audisio-ing/UNLZ-Proyecto_Final-Estacion_de_Escaneo_3D_para_Analisis_de_Desviaciones_Dimensionales/Propuesta Final.pdf

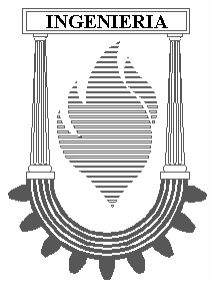
[picture p18: figure]

### Universidad Nacional de Lomas de Zamora

### Facultad de Ingeniería

### PROYECTO EN INGENIERÍA MECATRÓNICA

DOCENTES
- Blanca, Ezequiel.
- Lukaszewicz, Cristian Leandro.
- Szombach, Juan Ignacio.

### PROPUESTA FINAL

## CONTROL DE CALIDAD POR COMPARACIÓN CON NUBE DE PUNTOS

INTEGRANTES
Audisio, Juan Pablo - 43.671.648 Garrahan, Alan - 43.896.825 Reyna, Valentín Julián - 43.798.677

FECHA DE PRESENTACIÓN: 1 de Septiembre de 2025

MOTIVACIÓN
Buscamos desarrollar una solución innovadora para el control de calidad, un nuevo enfoque que permita un control detallado pieza por pieza asegurándose de que el producto final cumpla con los estándares requeridos. Garantizar la precisión, consistencia y velocidad en la detección de defectos y variaciones en las piezas.
Orientado a métodos de producción asociados a la matricería, para verificar si el producto generado por la matriz cumple los estándares de calidad. Por ejemplo para matrices de inyección de plástico, se puede verificar si la matriz se sigue llenando por completo, si se extrae bien la rebaba, y si el desgaste de la misma no es significante.

DESCRIPCIÓN DE LA PROPUESTA
Línea de control equipada con una cámara y un láser de línea funcionando como scanner 3D a través del principio de triangulación láser con el fin de detección de fallas en piezas producidas por matrices destinadas a producciones en serie..

Las piezas entrarán al sistema a través de una cinta transportadora, serán posicionadas dentro de la estación de escaneo 3D y posteriormente obtendremos una nube de puntos relacionada con las dimensiones del objeto. Se ejecutará un código que permitirá visualizar la nube de puntos obtenidas y compararla con el modelo CAD patrón de las piezas existentes para determinar si la misma presenta fallas o deformaciones que puedan afectar a su funcionamiento. Esto nos permite conocer el estado de la matriz y sus posibles deformaciones, para determinar si es apta o no para ser instalada en una línea de producción.

ALCANCE
Al fin de la cursada se presentará un prototipo funcional del sistema que cumpla de forma eficaz la tarea propuesta, no podemos asegurar un funcionamiento eficiente ya que el mismo dependerá de los componentes que seamos capaces de obtener.

Se presentará un prototipo que cuente con una cinta de transporte funcional capaz de transportar las piezas hasta la estación de escaneo 3D retroalimentada con sensores de posición.

El sistema contará con tres variantes de piezas funcionales con cualidades únicas para comprobar el funcionamiento del sistema.

La estación de escaneo 3D será capaz de escanear una órbita 360° alrededor de la pieza y devolviendo una nube de puntos de la misma que luego será utilizada para su comparación con la pieza patrón. El porcentaje de similitud con la misma determinará si la matriz fabricada es apta para la implementación en línea de producción

DOCENTES
- Alejandro Simoncelli (Procesamiento de Señales): Adquisición, gestión y visualización de datos, escaneo por triangulación láser, construcción de representaciones visuales satisfactorias.
- Diego Lopez (Instrumentación Industrial): Tolerancia de los sensores, selección de motores, selección sensores con frecuencia de muestreo apropiada, selección de microprocesador apropiado.
- Luis Lengo o José Luis Pelizzoni (Automatización Industrial): Conveyor belt, sensor de presencia y guardado, línea de producción.

ESPECIFICACIÓN DE REQUERIMIENTOS
El sistema será capaz de mover una pieza por una línea de producción y ubicarla precisamente sobre la plataforma de escaneo mediante una secuencia y retroalimentada por sensores de posición. Luego escaneará la pieza y devolverá una nube de puntos, la cual posteriormente permitirá identificar al sistema el tipo de pieza y reconocer errores para verificar si cumple con los estándares requeridos.

DISEÑO FUNCIONAL
El siguiente diagrama de bloques muestra el diseño funcional del sistema a gran escala, los pasos a seguir y el resultado esperado de cada uno

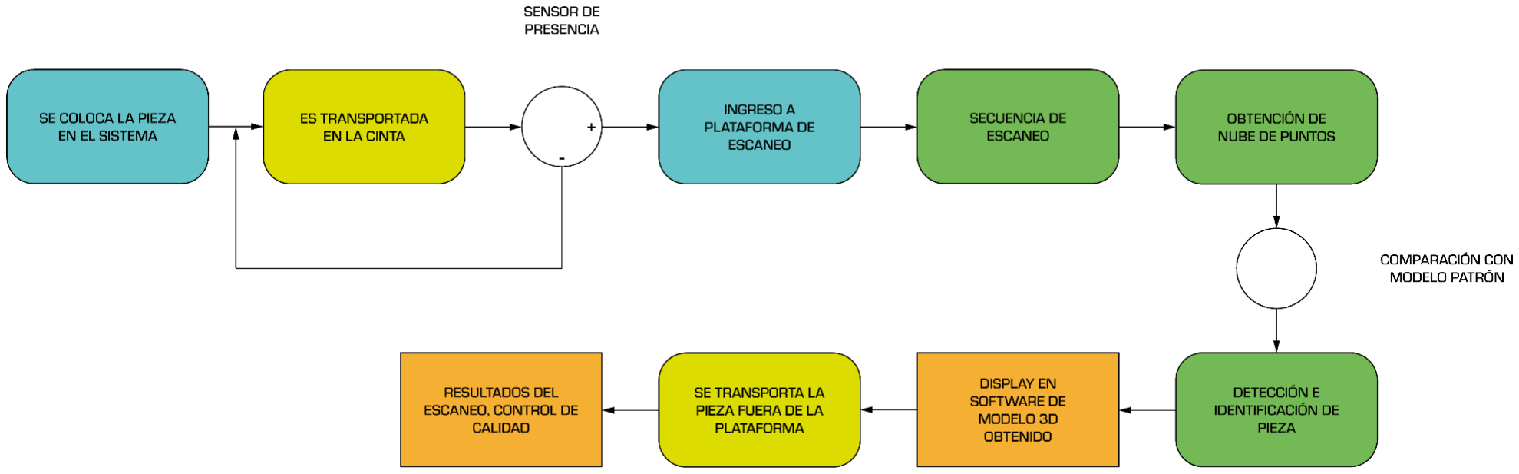
[picture p19: figure]

CONEXIONES DEL MICROCONTROLADOR
El siguiente diagrama muestra el conexionado del microcontrolador seleccionado para el proyecto (Arduino Uno)

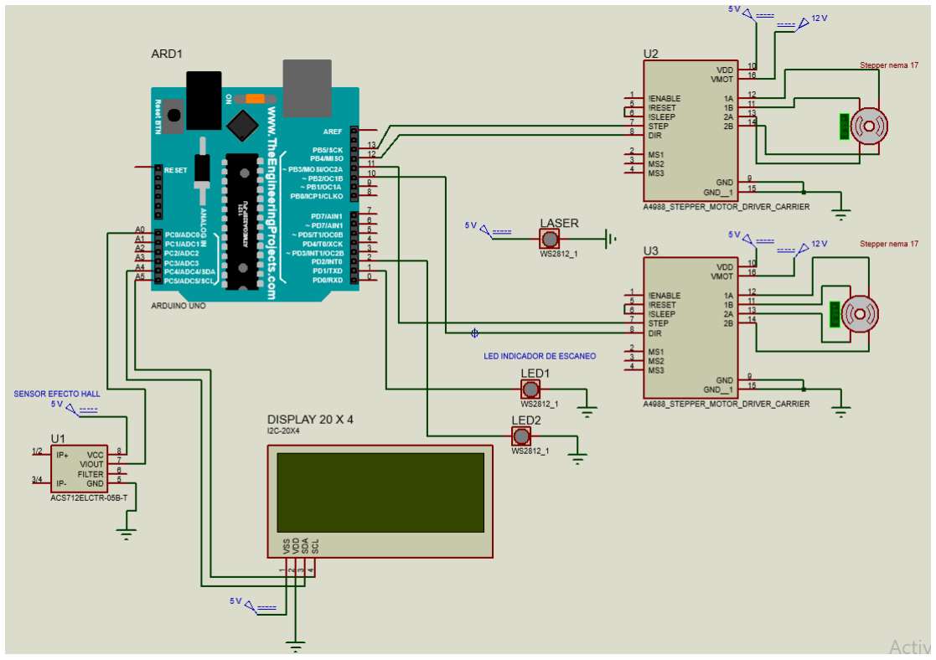
[picture p20: figure]

COSTO DEL PROTOTIPO, PRESUPUESTOS, PLAZOS DE ENTREGA DE MATERIALES
A continuación se incluye el BOM (Bill of Materials) que detalla los materiales necesarios para la realización del proyecto, junto con sus respectivos valores, tiempos de entrega y proveedores tanto en pesos y dólares, presentando alternativas de cada uno.

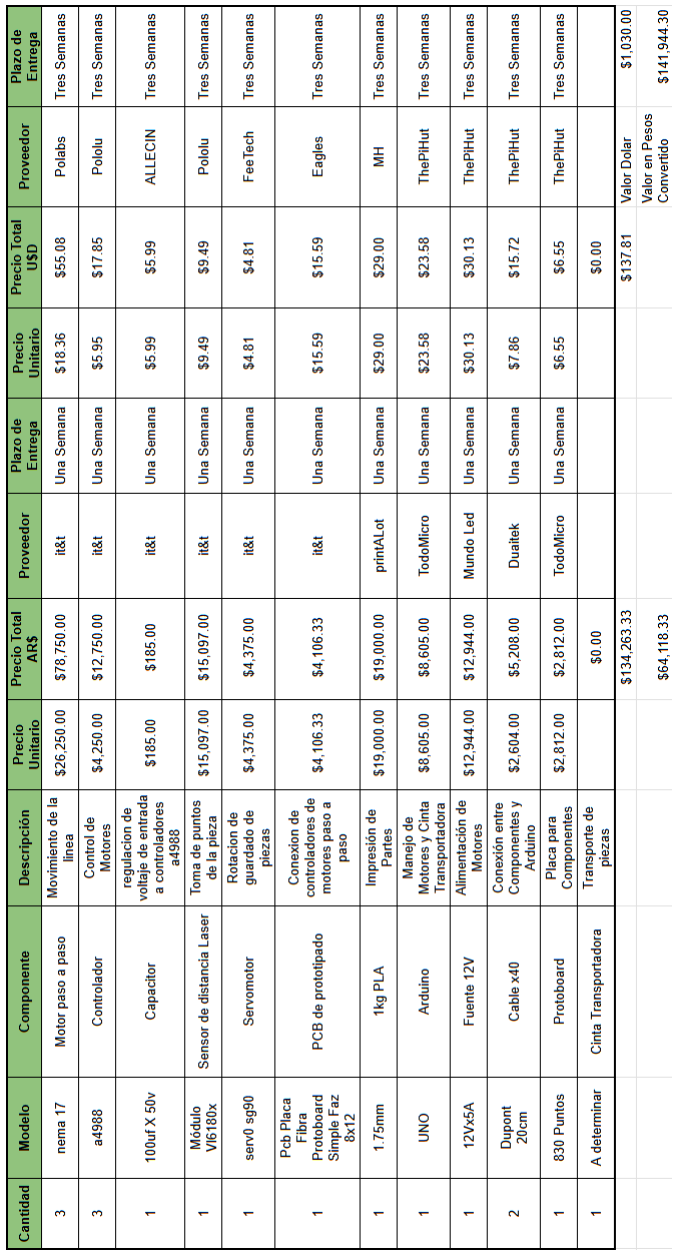
[picture p21: figure]
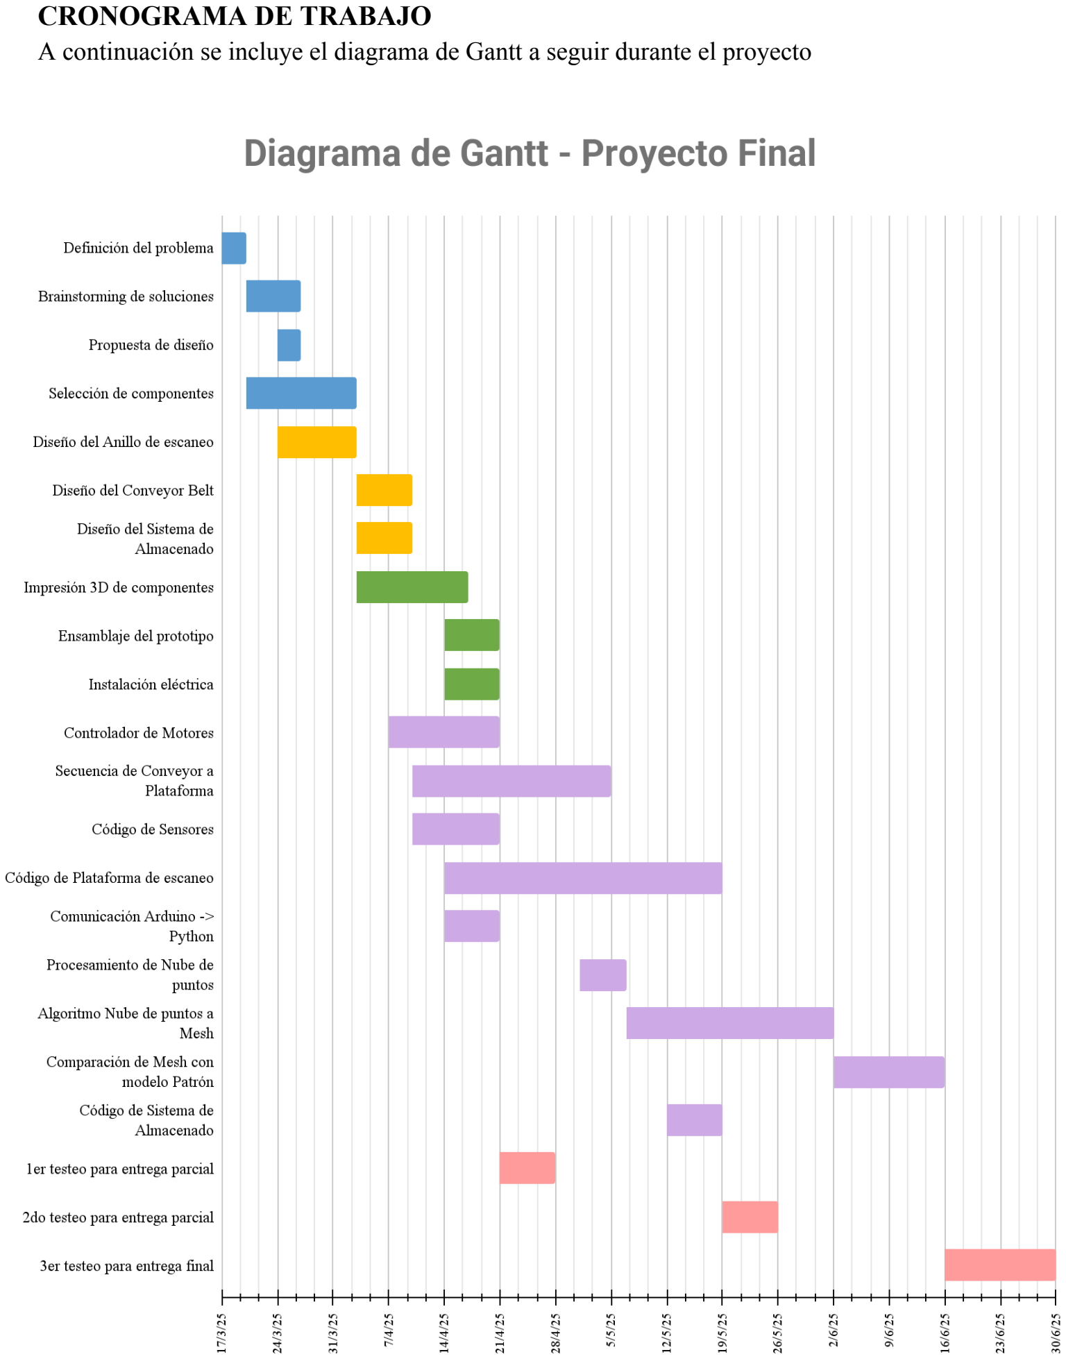
[picture p22: page 6]

CRONOGRAMA DE TRABAJO
A continuación se incluye el diagrama de Gantt a seguir durante el proyecto
