audisio-ing/UNLZ-Proyecto_Final-Estacion_de_Escaneo_3D_para_Analisis_de_Desviaciones_Dimensionales/Informes/DIAGRAMA DE GANTT.pdf

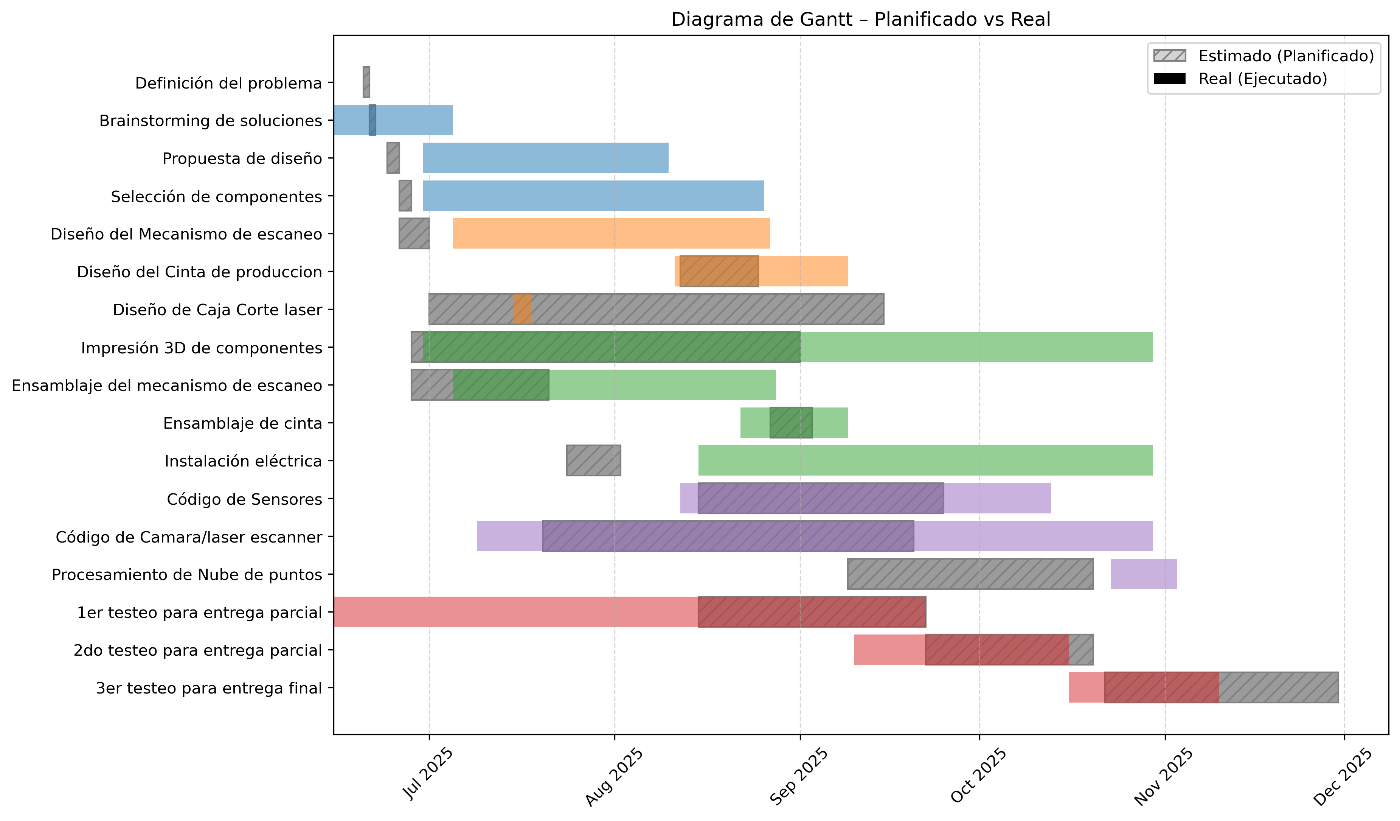
[picture p23: page 1]
