audisio-ing/UNLZ-Proyecto_Final-Estacion_de_Escaneo_3D_para_Analisis_de_Desviaciones_Dimensionales/Planos/Explosion/Explosion mecanismo v7.pdf

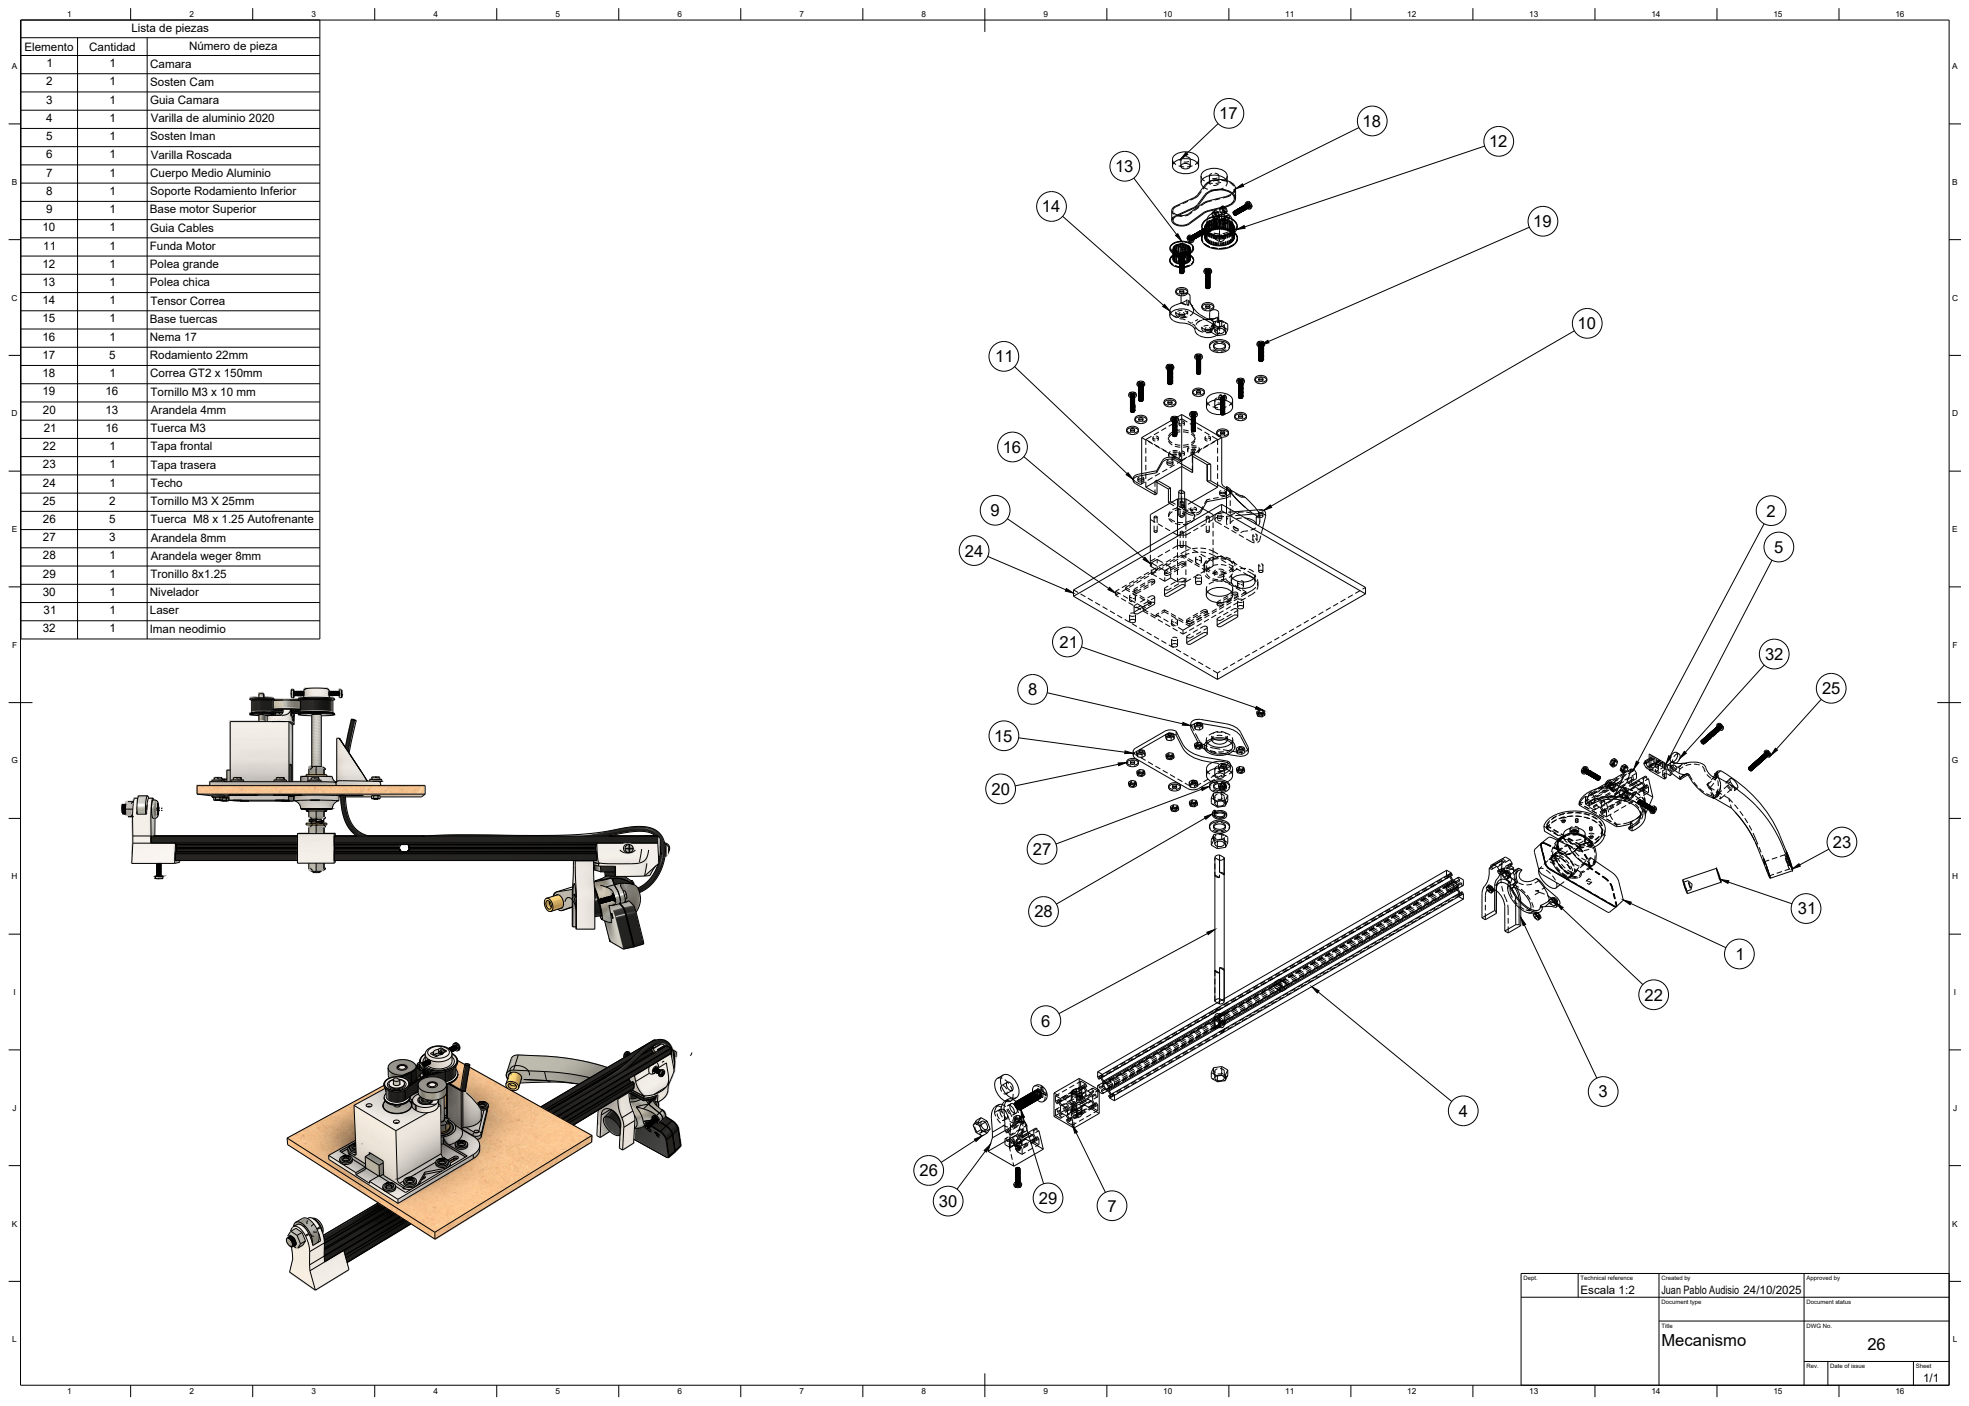
[picture p24: page 1]
Dept.; Technical reference; Created by; Approved by; Document type; Document status; Title; DWG No.; Rev.; Date of issue; Sheet; Escala 1:2; Juan Pablo Audisio; Elemento; Cantidad; Número de pieza 1; Camara 2; Sosten Cam 3; Guia Camara 4; Varilla de aluminio 2020 5; Sosten Iman 6; Varilla Roscada 7; Cuerpo Medio Aluminio 8; Soporte Rodamiento Inferior 9; Base motor Superior; Guia Cables; Funda Motor; Polea grande; Polea chica; Tensor Correa; Base tuercas; Nema 17; Rodamiento 22mm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

Lista de piezas
