audisio-ing/UNLZ-Proyecto_Final-Estacion_de_Escaneo_3D_para_Analisis_de_Desviaciones_Dimensionales/Planos/Explosion/Plano caja v8.pdf

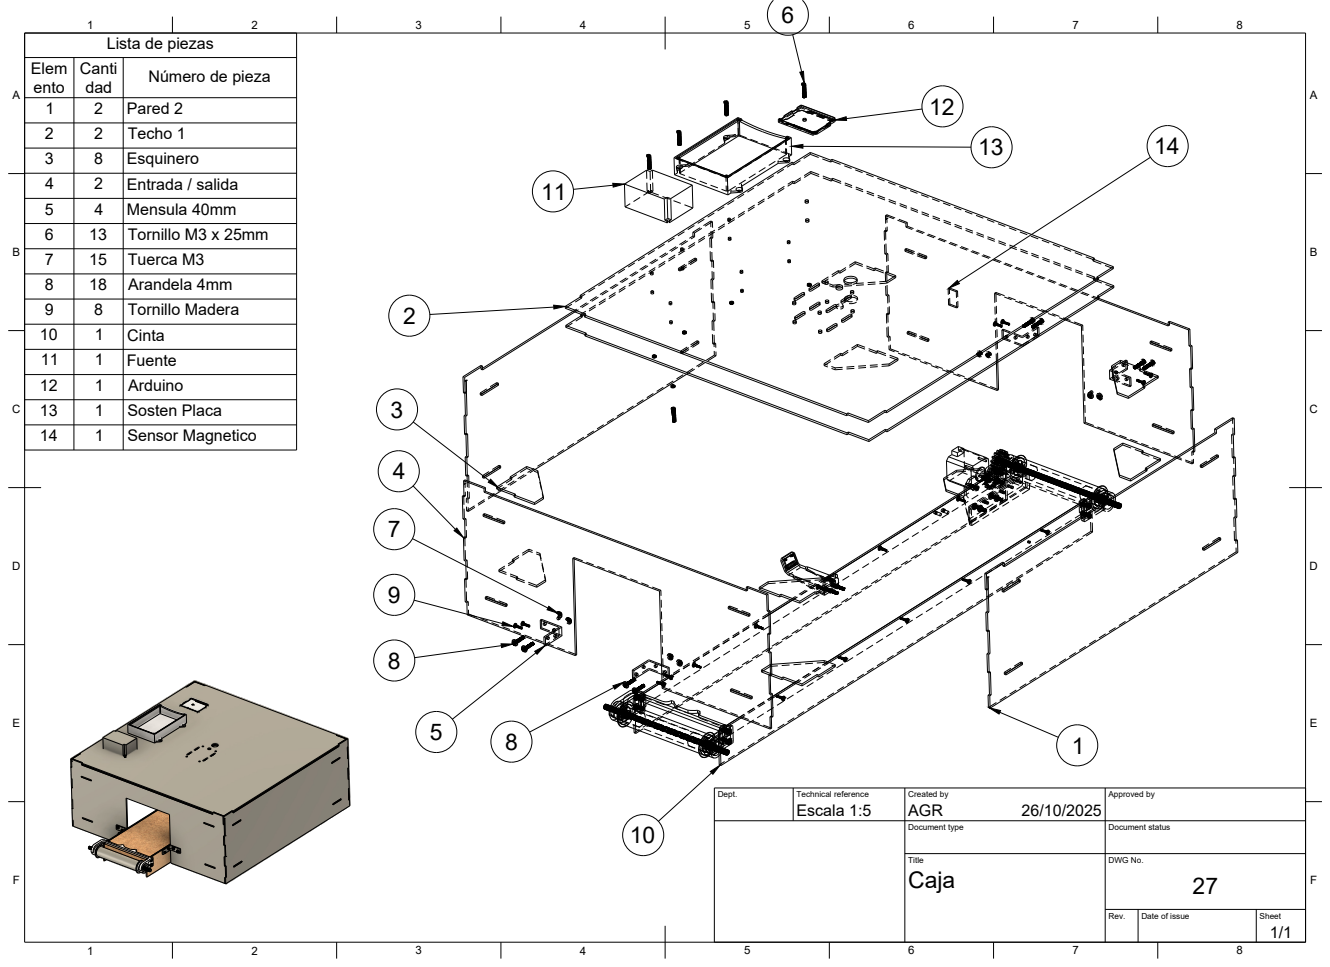
[picture p25: page 1]
Dept.; Technical reference; Created by; Approved by; Document type; Document status; Title; DWG No.; Rev.; Date of issue; Sheet; Escala 1:5; AGR; Lista de piezas; dad; Número de pieza; Pared 2; Techo 1; Entrada / salida; Mensula 40mm; Tornillo M3 x 25mm; Tuerca M3; Arandela 4mm; Tornillo Madera; Sosten Placa; Sensor Magnetico
