audisio-ing/UNLZ-Proyecto_Final-Estacion_de_Escaneo_3D_para_Analisis_de_Desviaciones_Dimensionales/Planos/Explosion/Plano cinta explosion v10.pdf

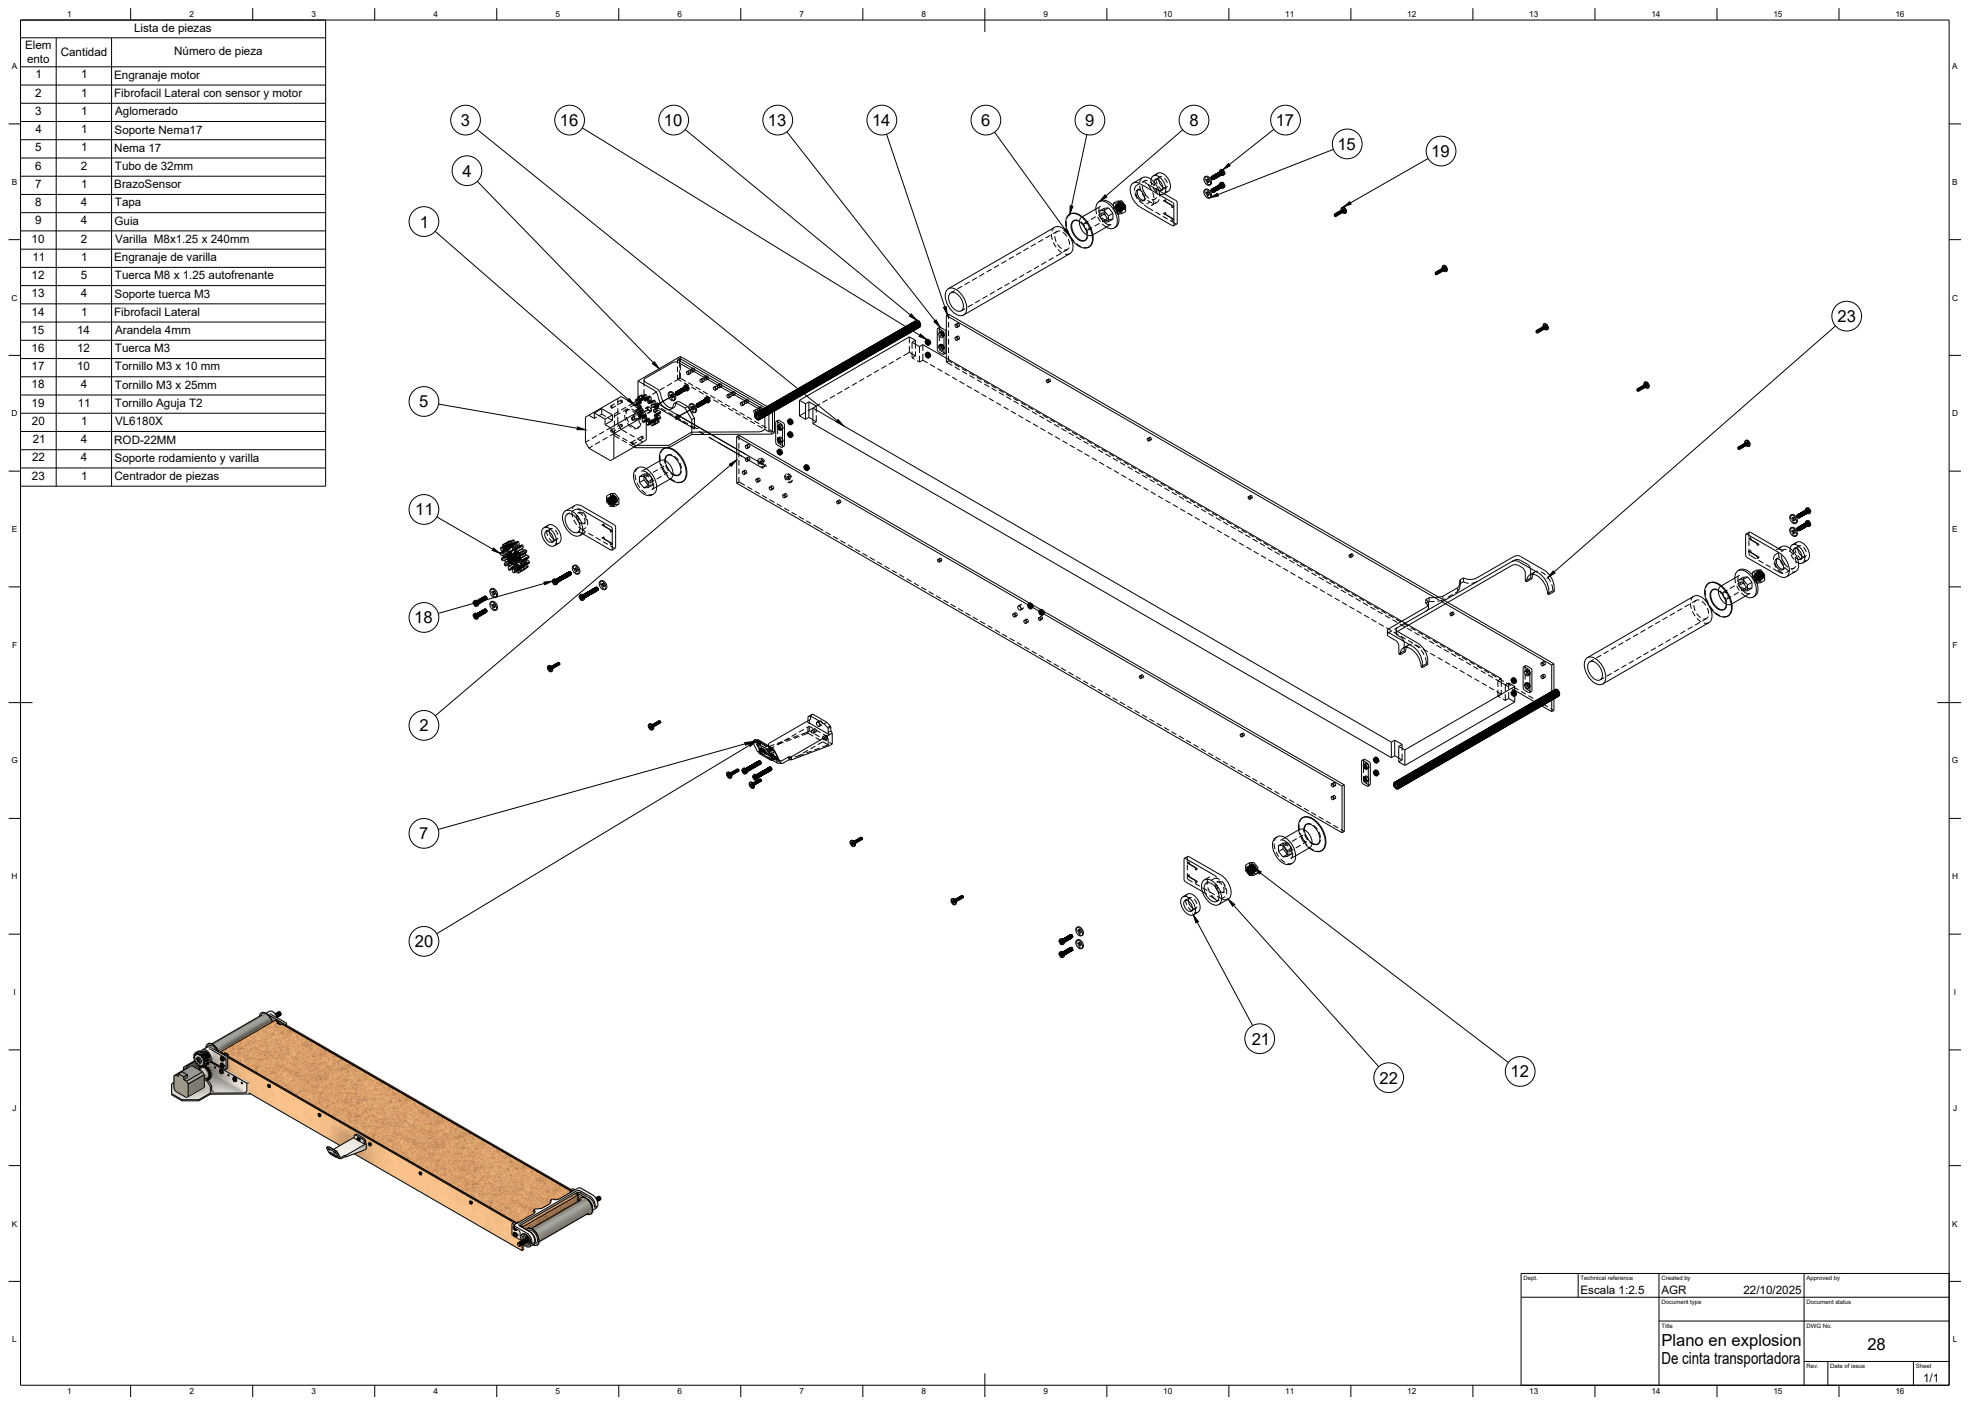
[picture p26: page 1]
Dept.; Technical reference; Created by; Approved by; Document type; Document status; Title; DWG No.; Rev.; Date of issue; Sheet; Plano en explosion; Escala 1:2.5; AGR; ento Cantidad; Número de pieza; Engranaje motor; Fibrofacil Lateral con sensor y motor; Soporte Nema17; Nema 17; Tubo de 32mm; Varilla M8x1.25 x 240mm; Engranaje de varilla; Tuerca M8 x 1.25 autofrenante; Soporte tuerca M3; Fibrofacil Lateral; Arandela 4mm; Tuerca M3; Tornillo M3 x 10 mm; Tornillo M3 x 25mm; Tornillo Aguja T2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

Lista de piezas

De cinta transportadora
