audisio-ing/UNLZ-Proyecto_Final-Estacion_de_Escaneo_3D_para_Analisis_de_Desviaciones_Dimensionales/Planos/Cinta/Plano MDF lados cinta v3.pdf

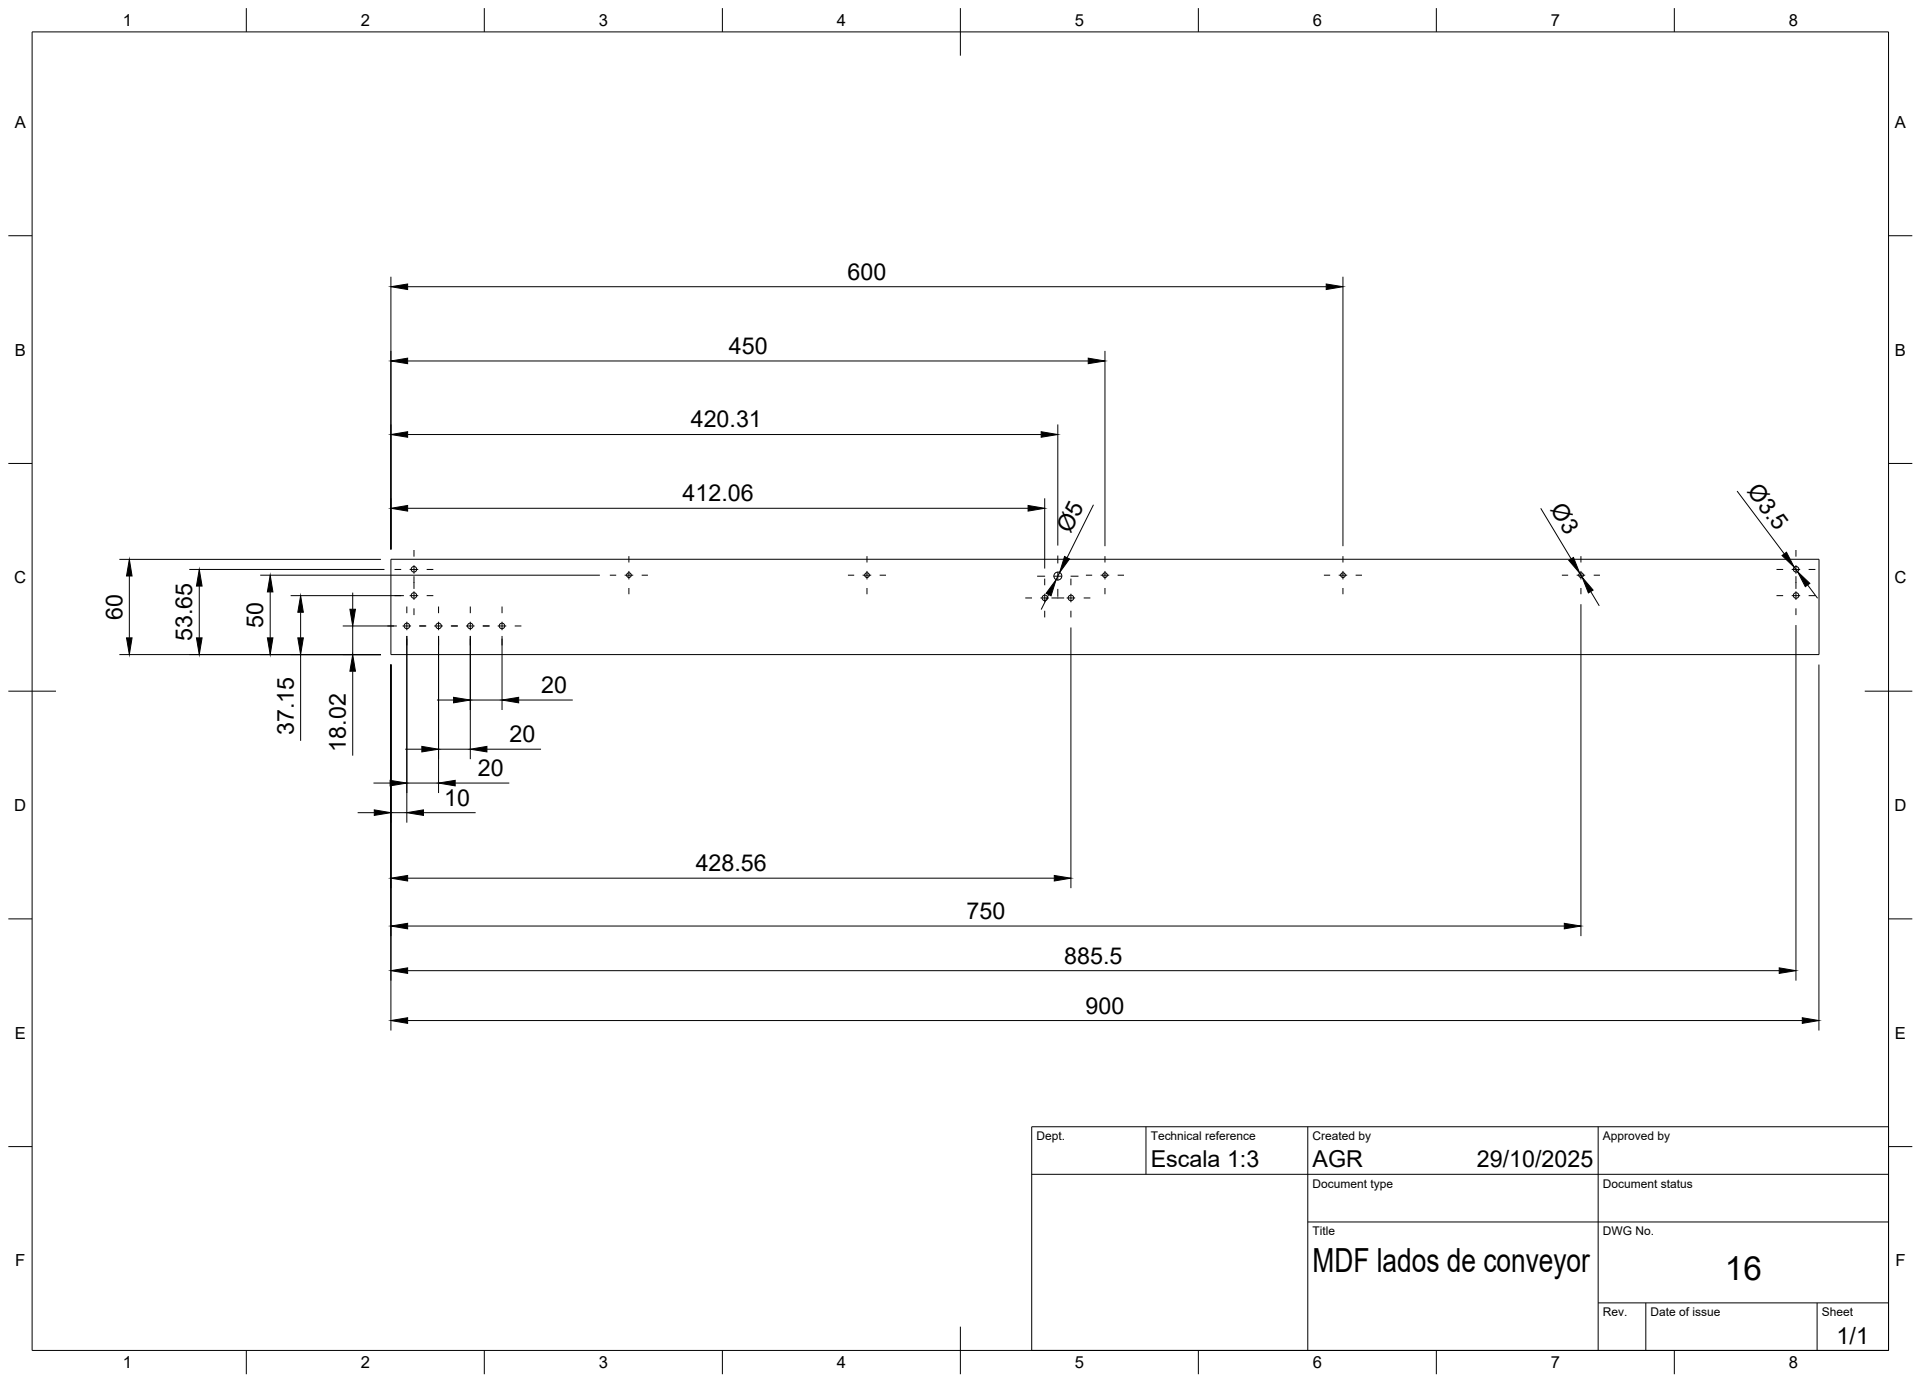
[picture p27: page 1]

Dept. | Technical reference Escala 1:3 | Created by AGR 29/10/2025 | Approved by

Document type | Document status

Title MDF lados de conveyor | DWG No. 16

Rev. | Date of issue | Sheet 1/1
