audisio-ing/UNLZ-Proyecto_Final-Estacion_de_Escaneo_3D_para_Analisis_de_Desviaciones_Dimensionales/Planos/Cinta/Plano soporte sensor VL6180x v2.pdf

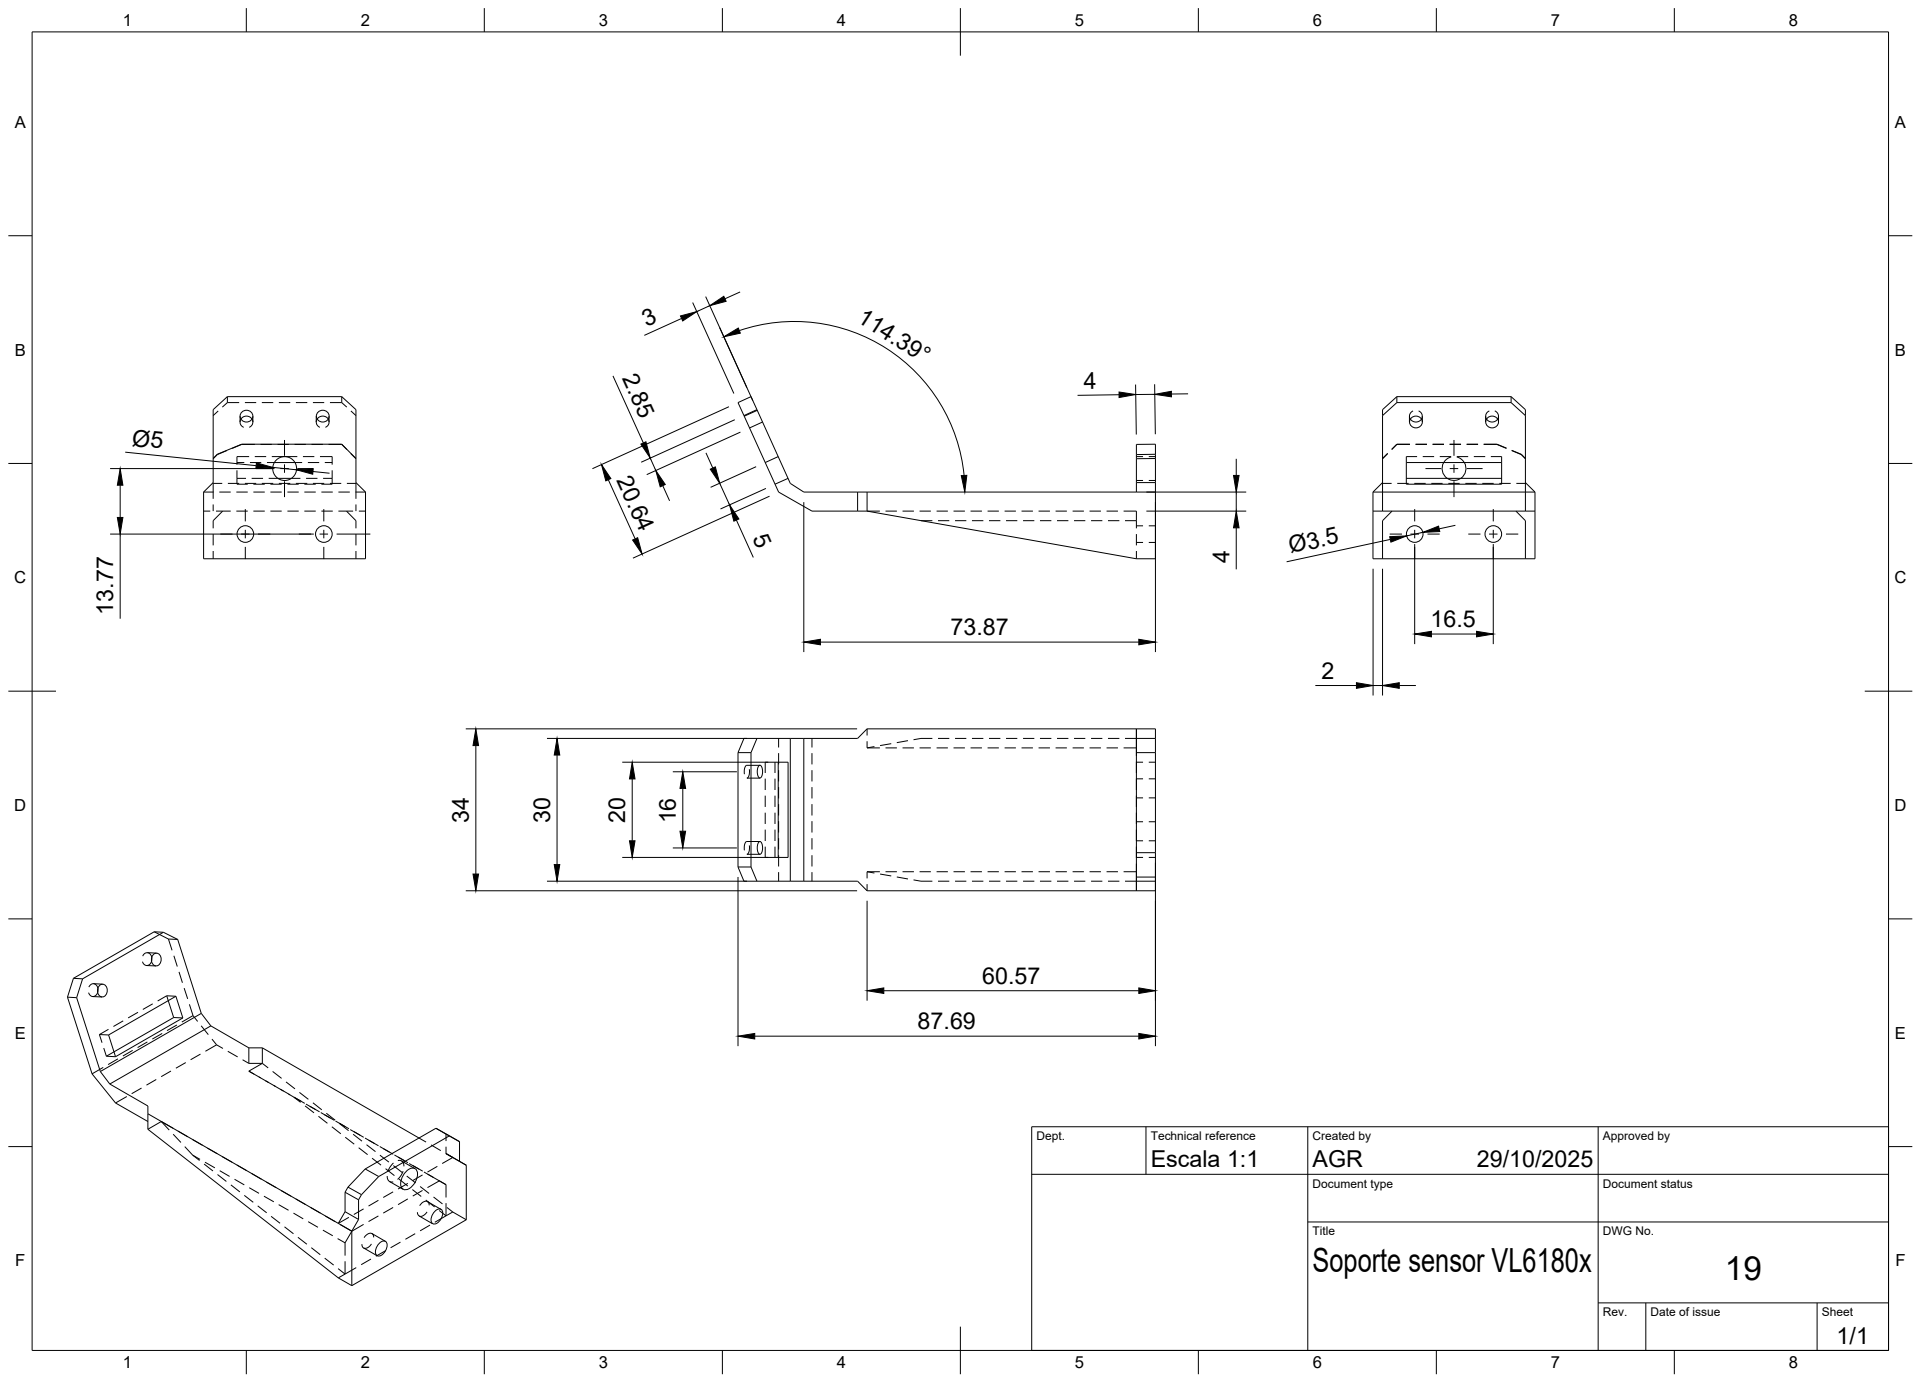
[picture p28: page 1]
Escala 1:1; AGR 16

Dept. | Technical reference | Created by 29/10/2025 | Approved by

Document type | Document status

Title Soporte sensor VL6180x | DWG No. 19

Rev. | Date of issue | Sheet 1/1
