audisio-ing/UNLZ-Proyecto_Final-Estacion_de_Escaneo_3D_para_Analisis_de_Desviaciones_Dimensionales/Planos/Mecanismo Giratorio/Funda motor v2.pdf

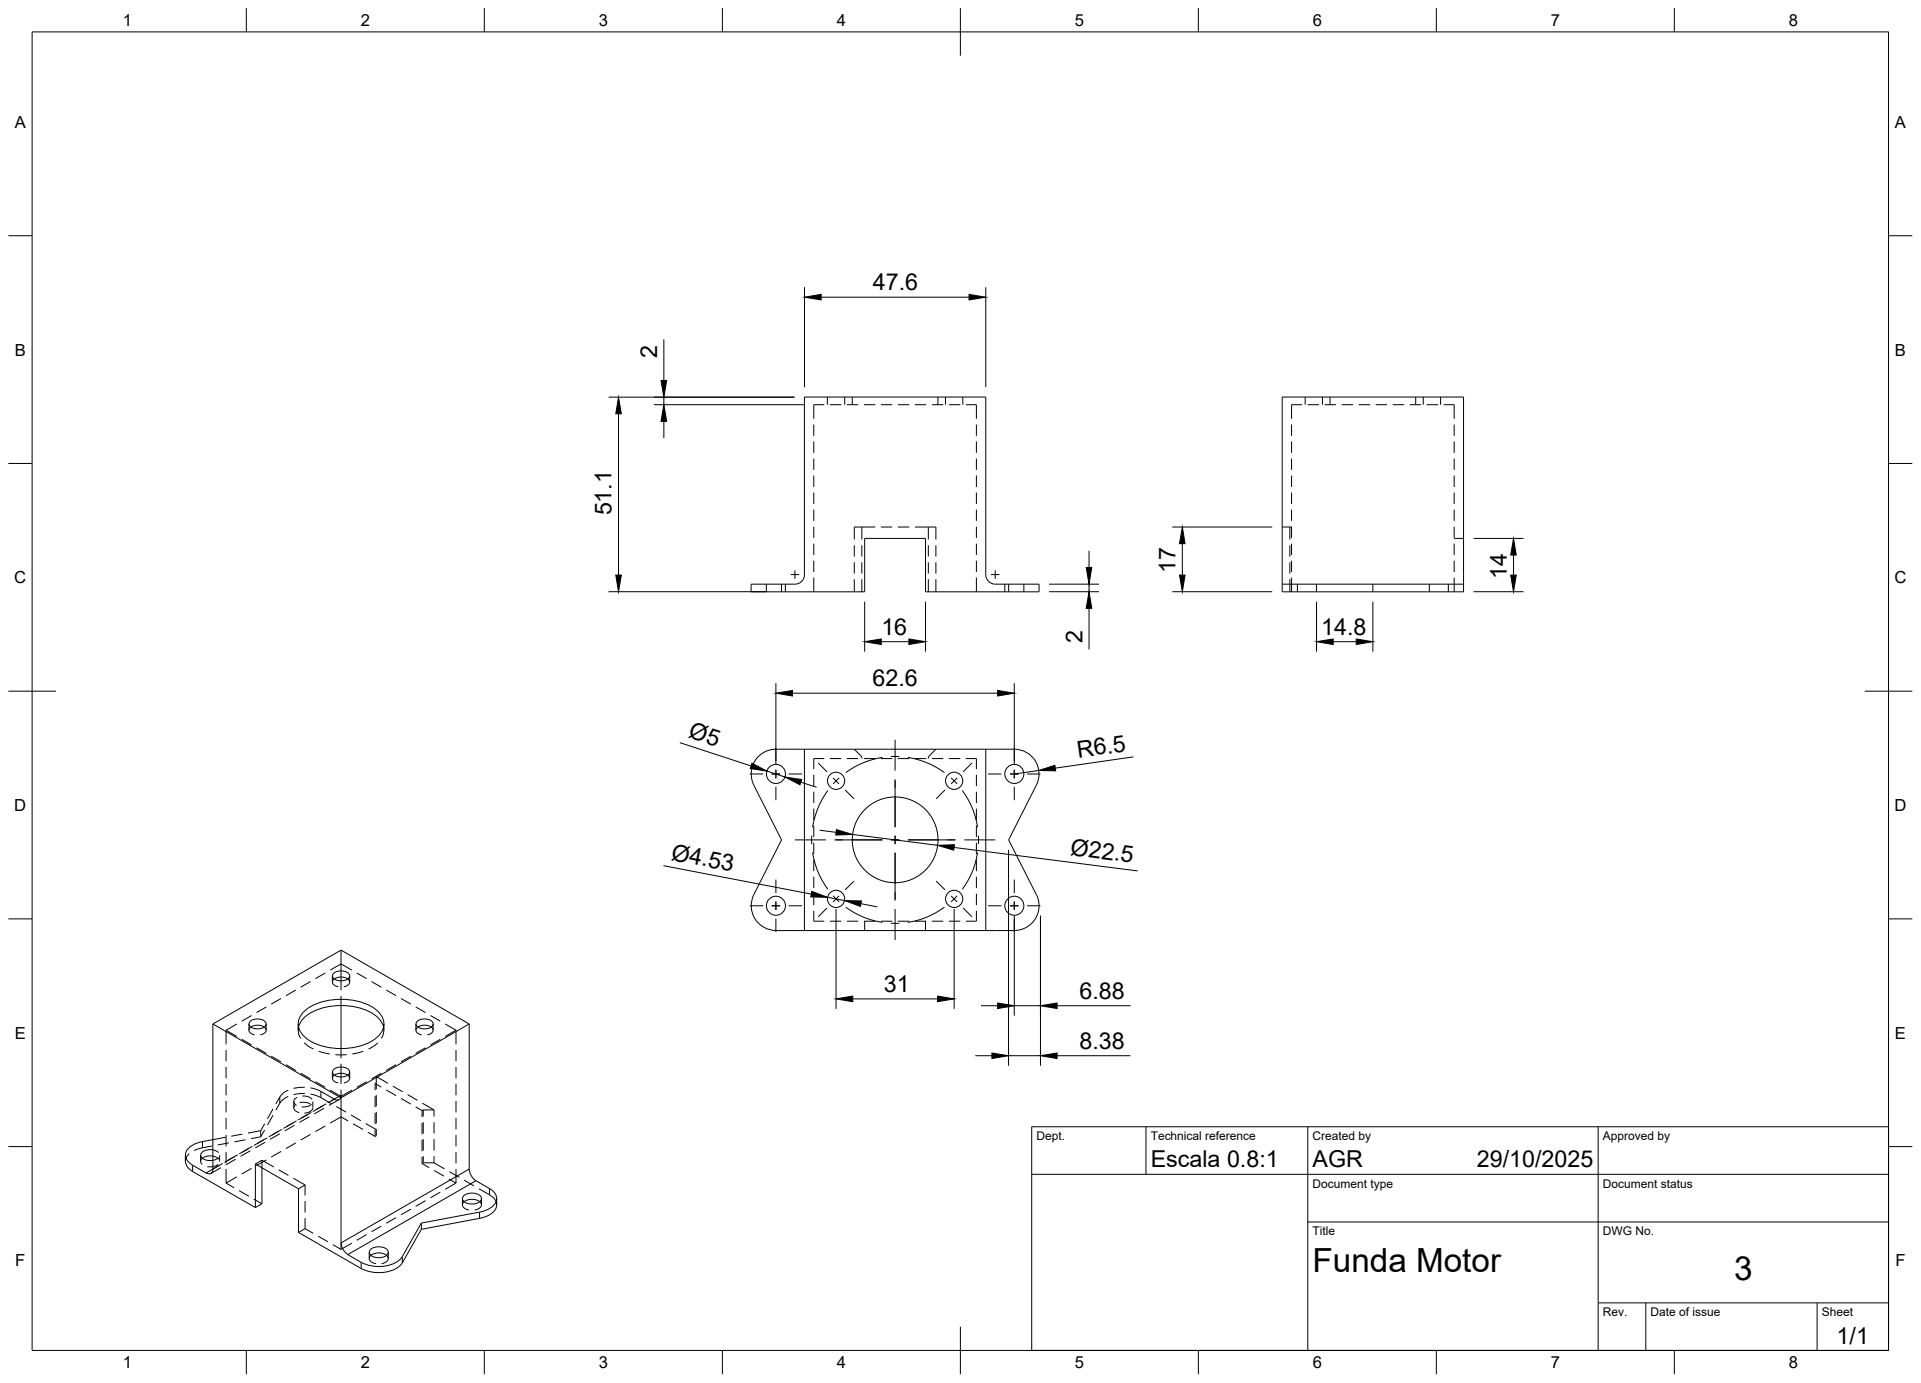
[picture p29: page 1]
Escala 0.8:1; AGR 51.1

Dept. | Technical reference | Created by 29/10/2025 | Approved by

Document type | Document status

Title Funda Motor | DWG No. 3

Rev. | Date of issue | Sheet 1/1
