audisio-ing/UNLZ-Proyecto_Final-Estacion_de_Escaneo_3D_para_Analisis_de_Desviaciones_Dimensionales/Planos/Mecanismo Giratorio/Plano base deslizante motor v3.pdf

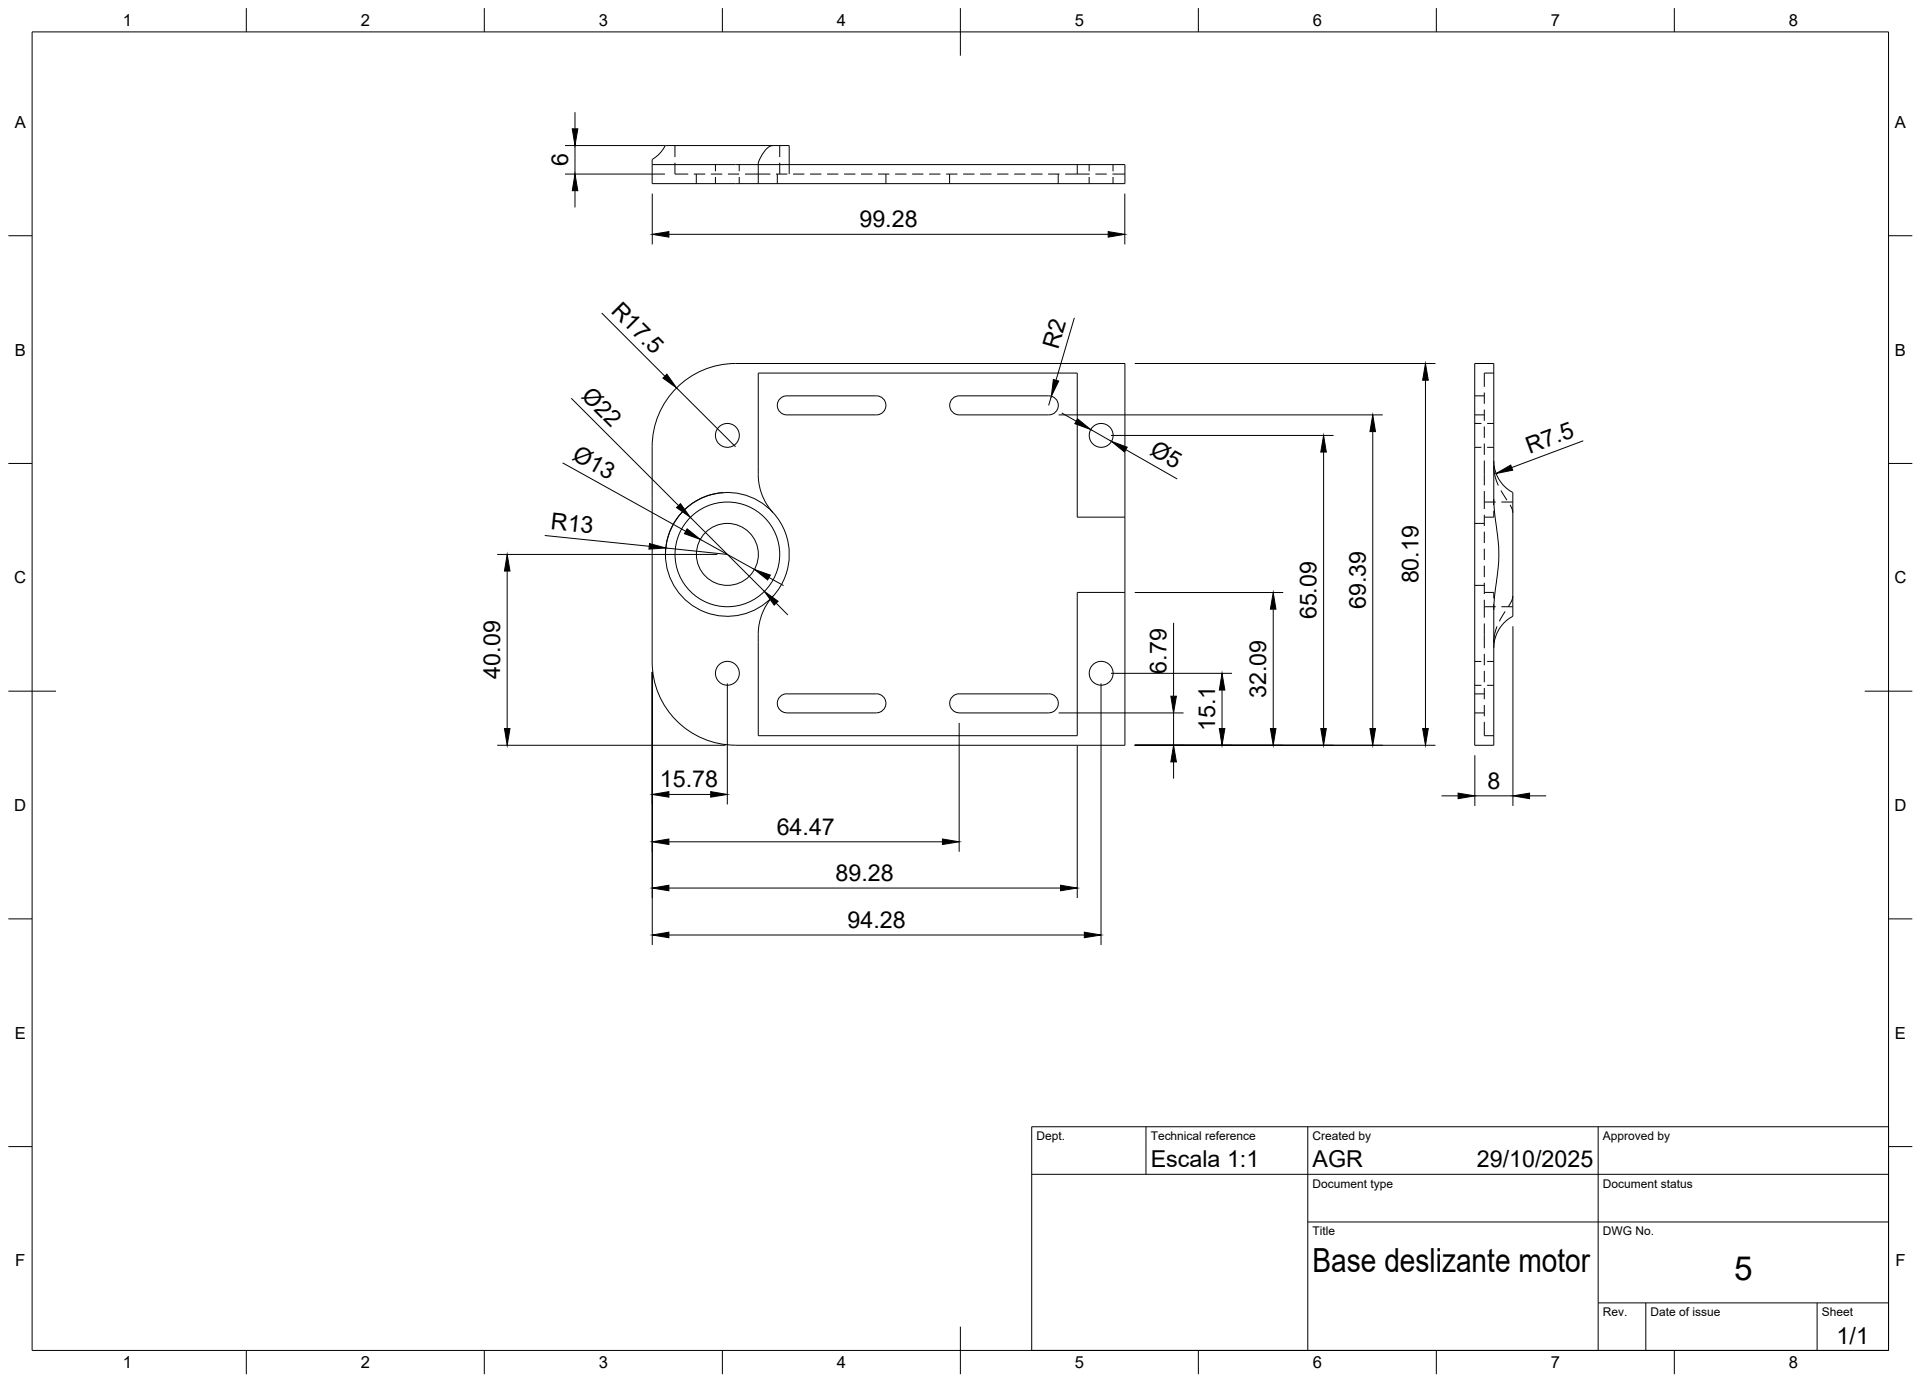
[picture p30: page 1]
Escala 1:1; AGR

Dept. | Technical reference | Created by 29/10/2025 | Approved by

Document type | Document status

Title Base deslizante motor | DWG No. 5

Rev. | Date of issue | Sheet 1/1
