audisio-ing/UNLZ-Proyecto_Final-Estacion_de_Escaneo_3D_para_Analisis_de_Desviaciones_Dimensionales/Planos/Mecanismo Giratorio/Plano guia cable v3.pdf

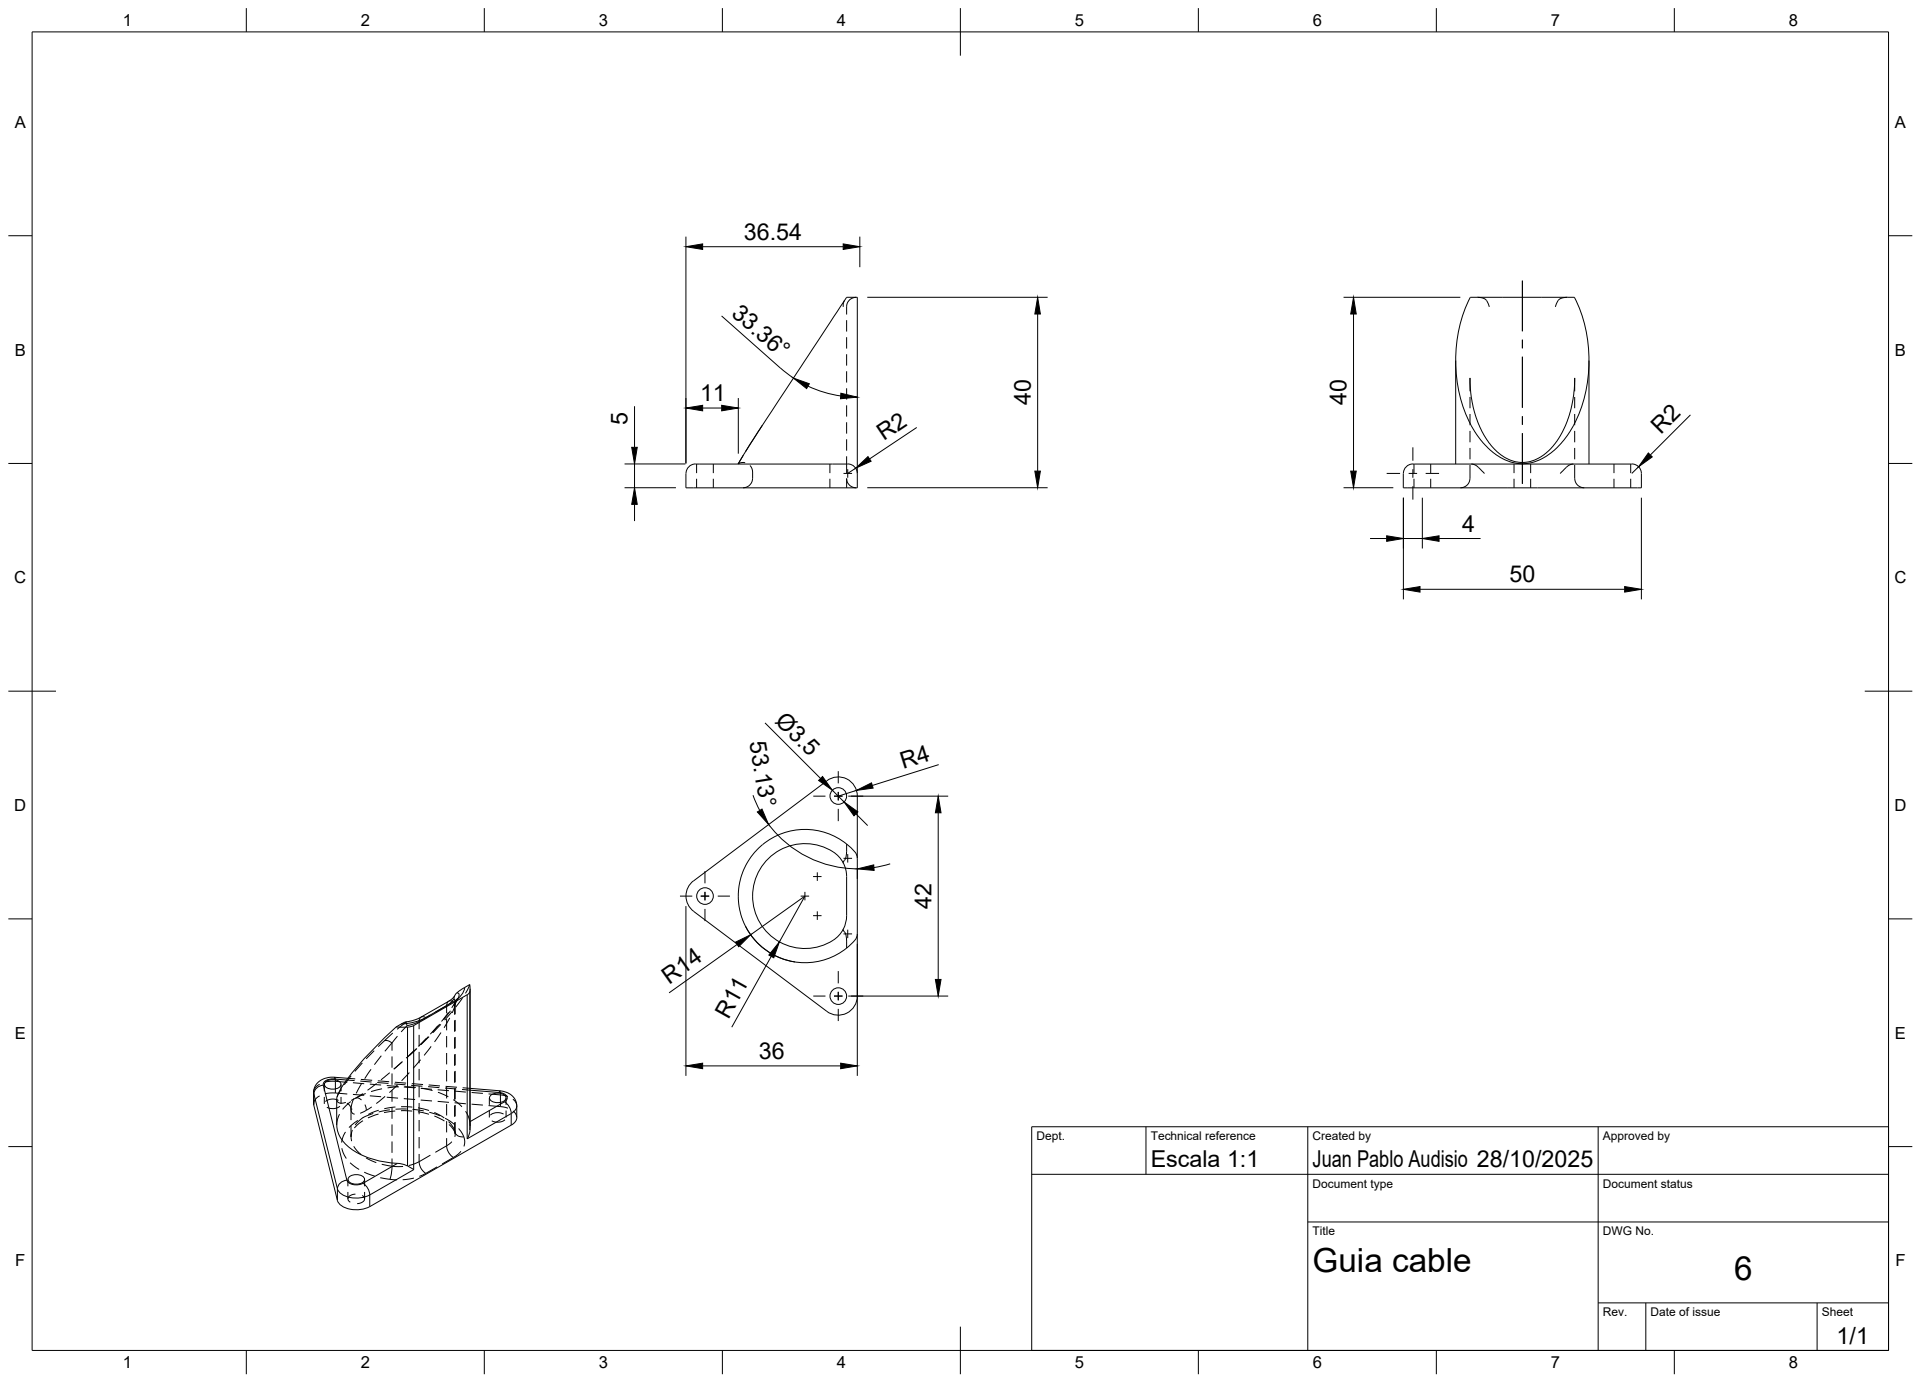
[picture p31: page 1]

Dept. | Technical reference Escala 1:1 | Created by Juan Pablo Audisio 28/10/2025 | Approved by

Document type | Document status

Title Guia cable | DWG No. 6

Rev. | Date of issue | Sheet 1/1
