audisio-ing/UNLZ-Proyecto_Final-Estacion_de_Escaneo_3D_para_Analisis_de_Desviaciones_Dimensionales/Planos/Mecanismo Giratorio/Soporte Iman y pasa cables v4.pdf

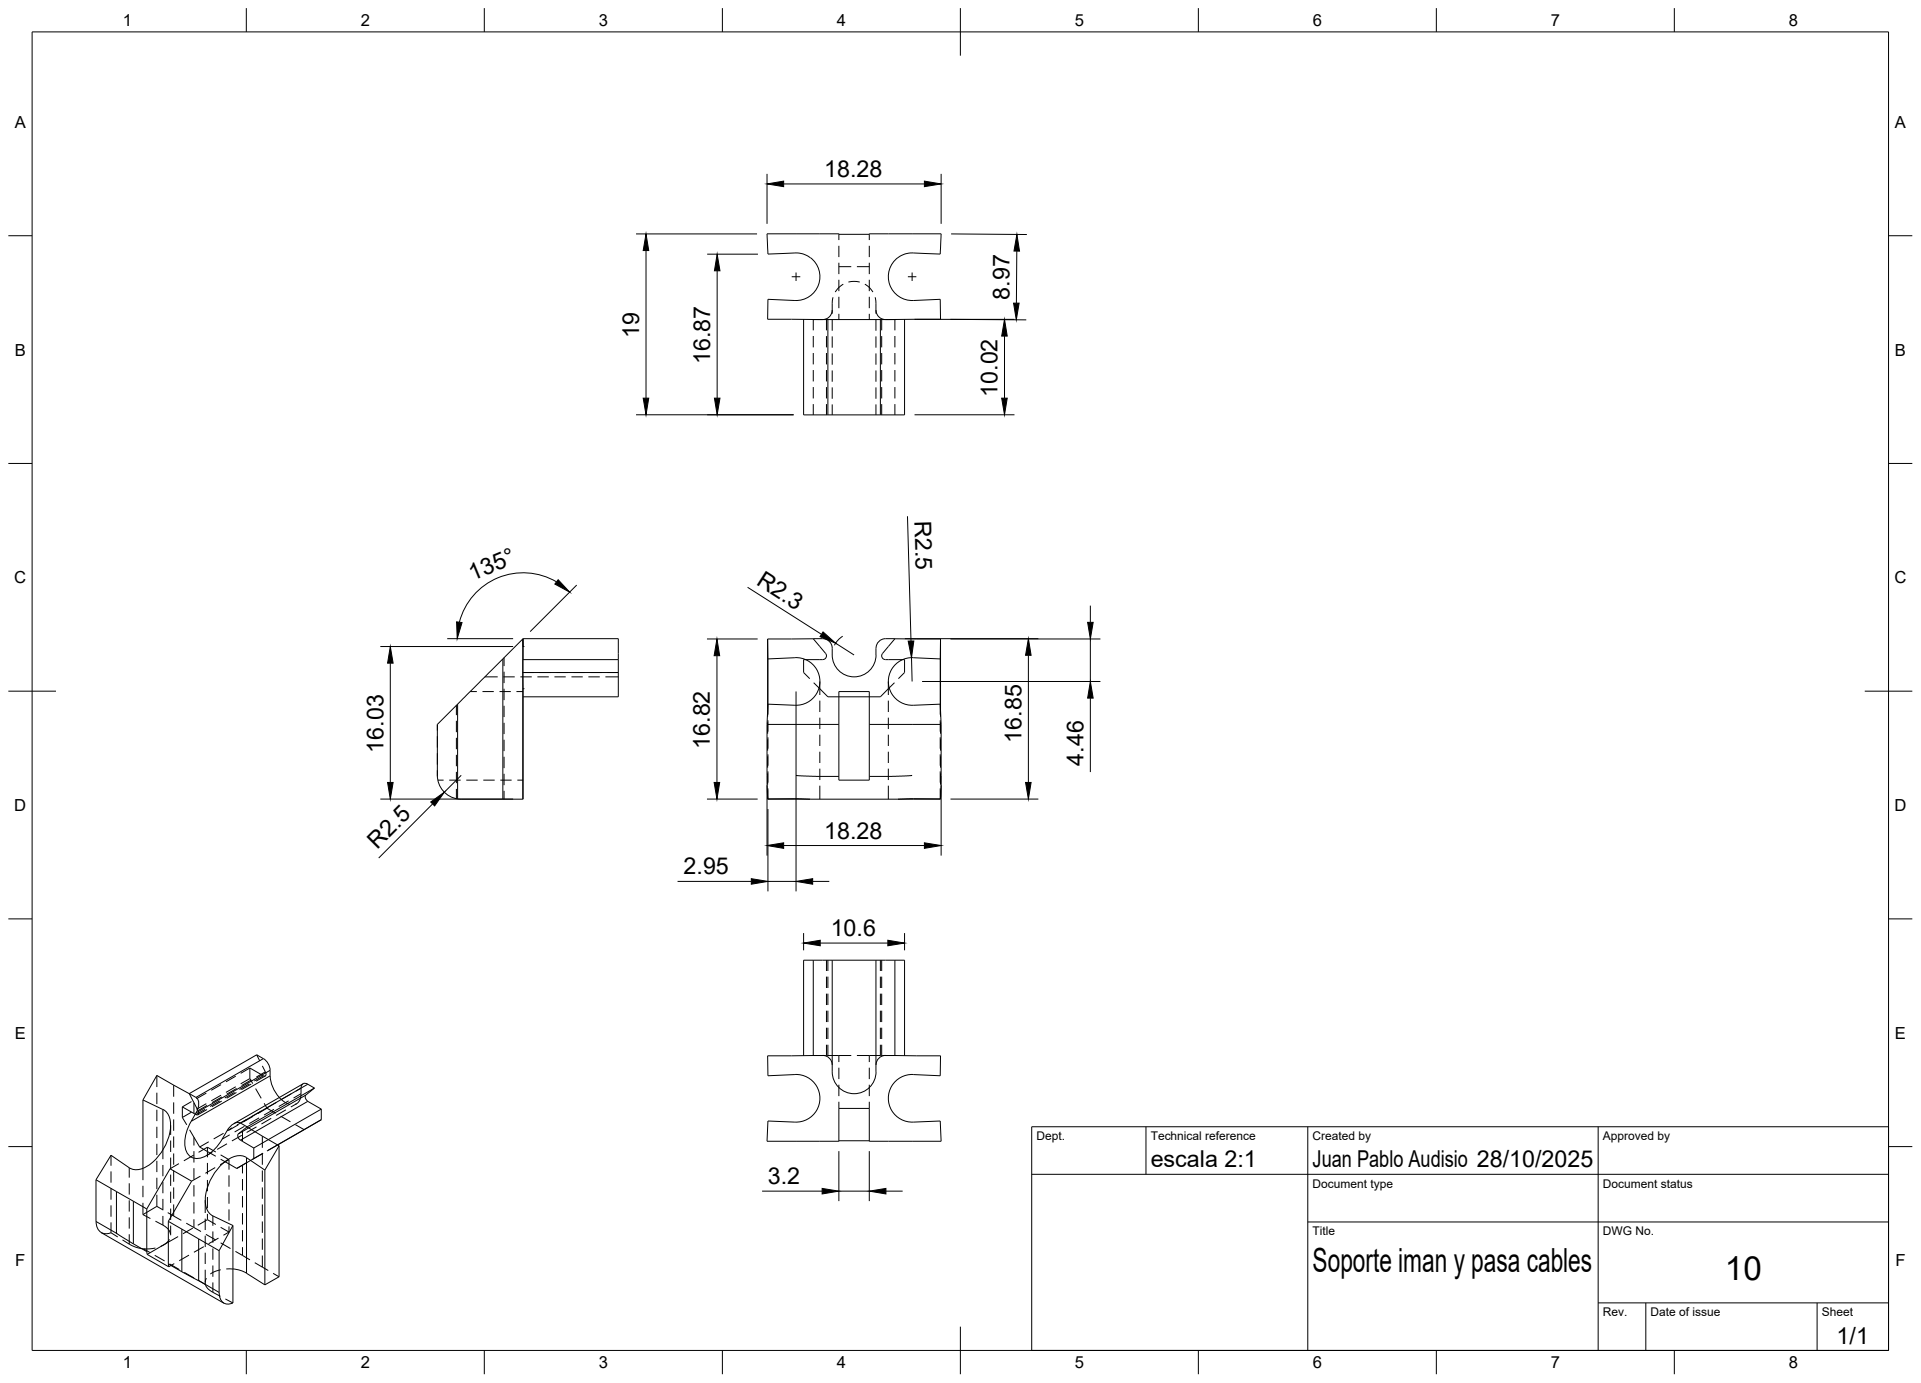
[picture p32: page 1]

Dept. | Technical reference escala 2:1 | Created by Juan Pablo Audisio 28/10/2025 | Approved by

Document type | Document status

Title Soporte iman y pasa cables | DWG No. 10

Rev. | Date of issue | Sheet 1/1
