audisio-ing/UNLZ-Proyecto_Final-Estacion_de_Escaneo_3D_para_Analisis_de_Desviaciones_Dimensionales/Planos/Mecanismo Giratorio/Soporte tuercas y soporte rodamiento inferior v3.pdf

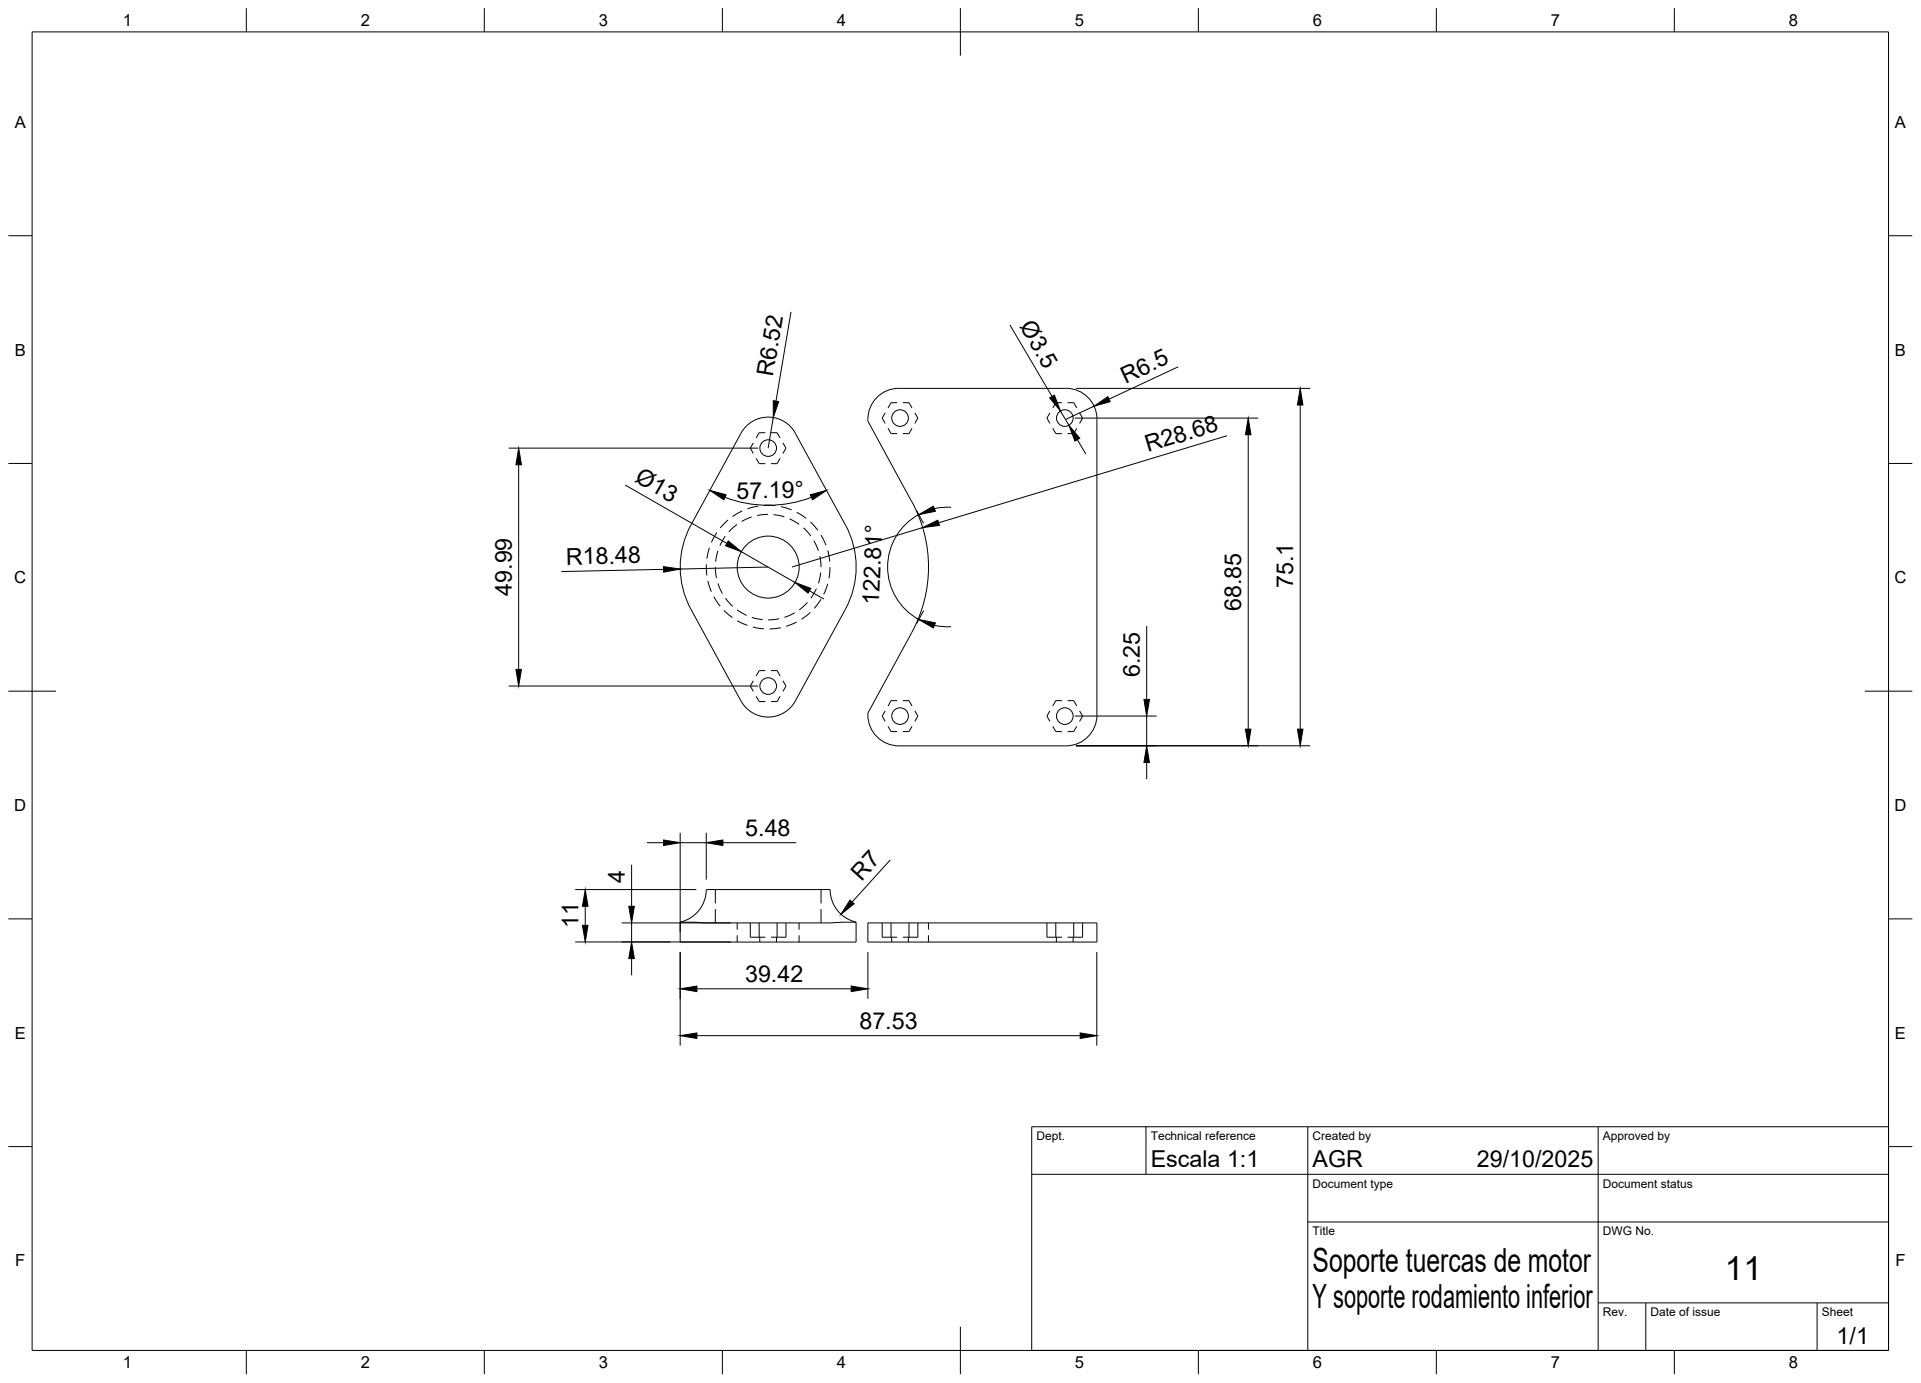
[picture p33: page 1]
Escala 1:1; AGR 75.1

Dept. | Technical reference | Created by 29/10/2025 | Approved by

Document type | Document status

Title Soporte tuercas de motor Y soporte rodamiento inferior | DWG No. 11

Rev. | Date of issue | Sheet 1/1
