audisio-ing/UNLZ-Proyecto_Final-Estacion_de_Escaneo_3D_para_Analisis_de_Desviaciones_Dimensionales/Planos/Caja/Esquinero v0.pdf

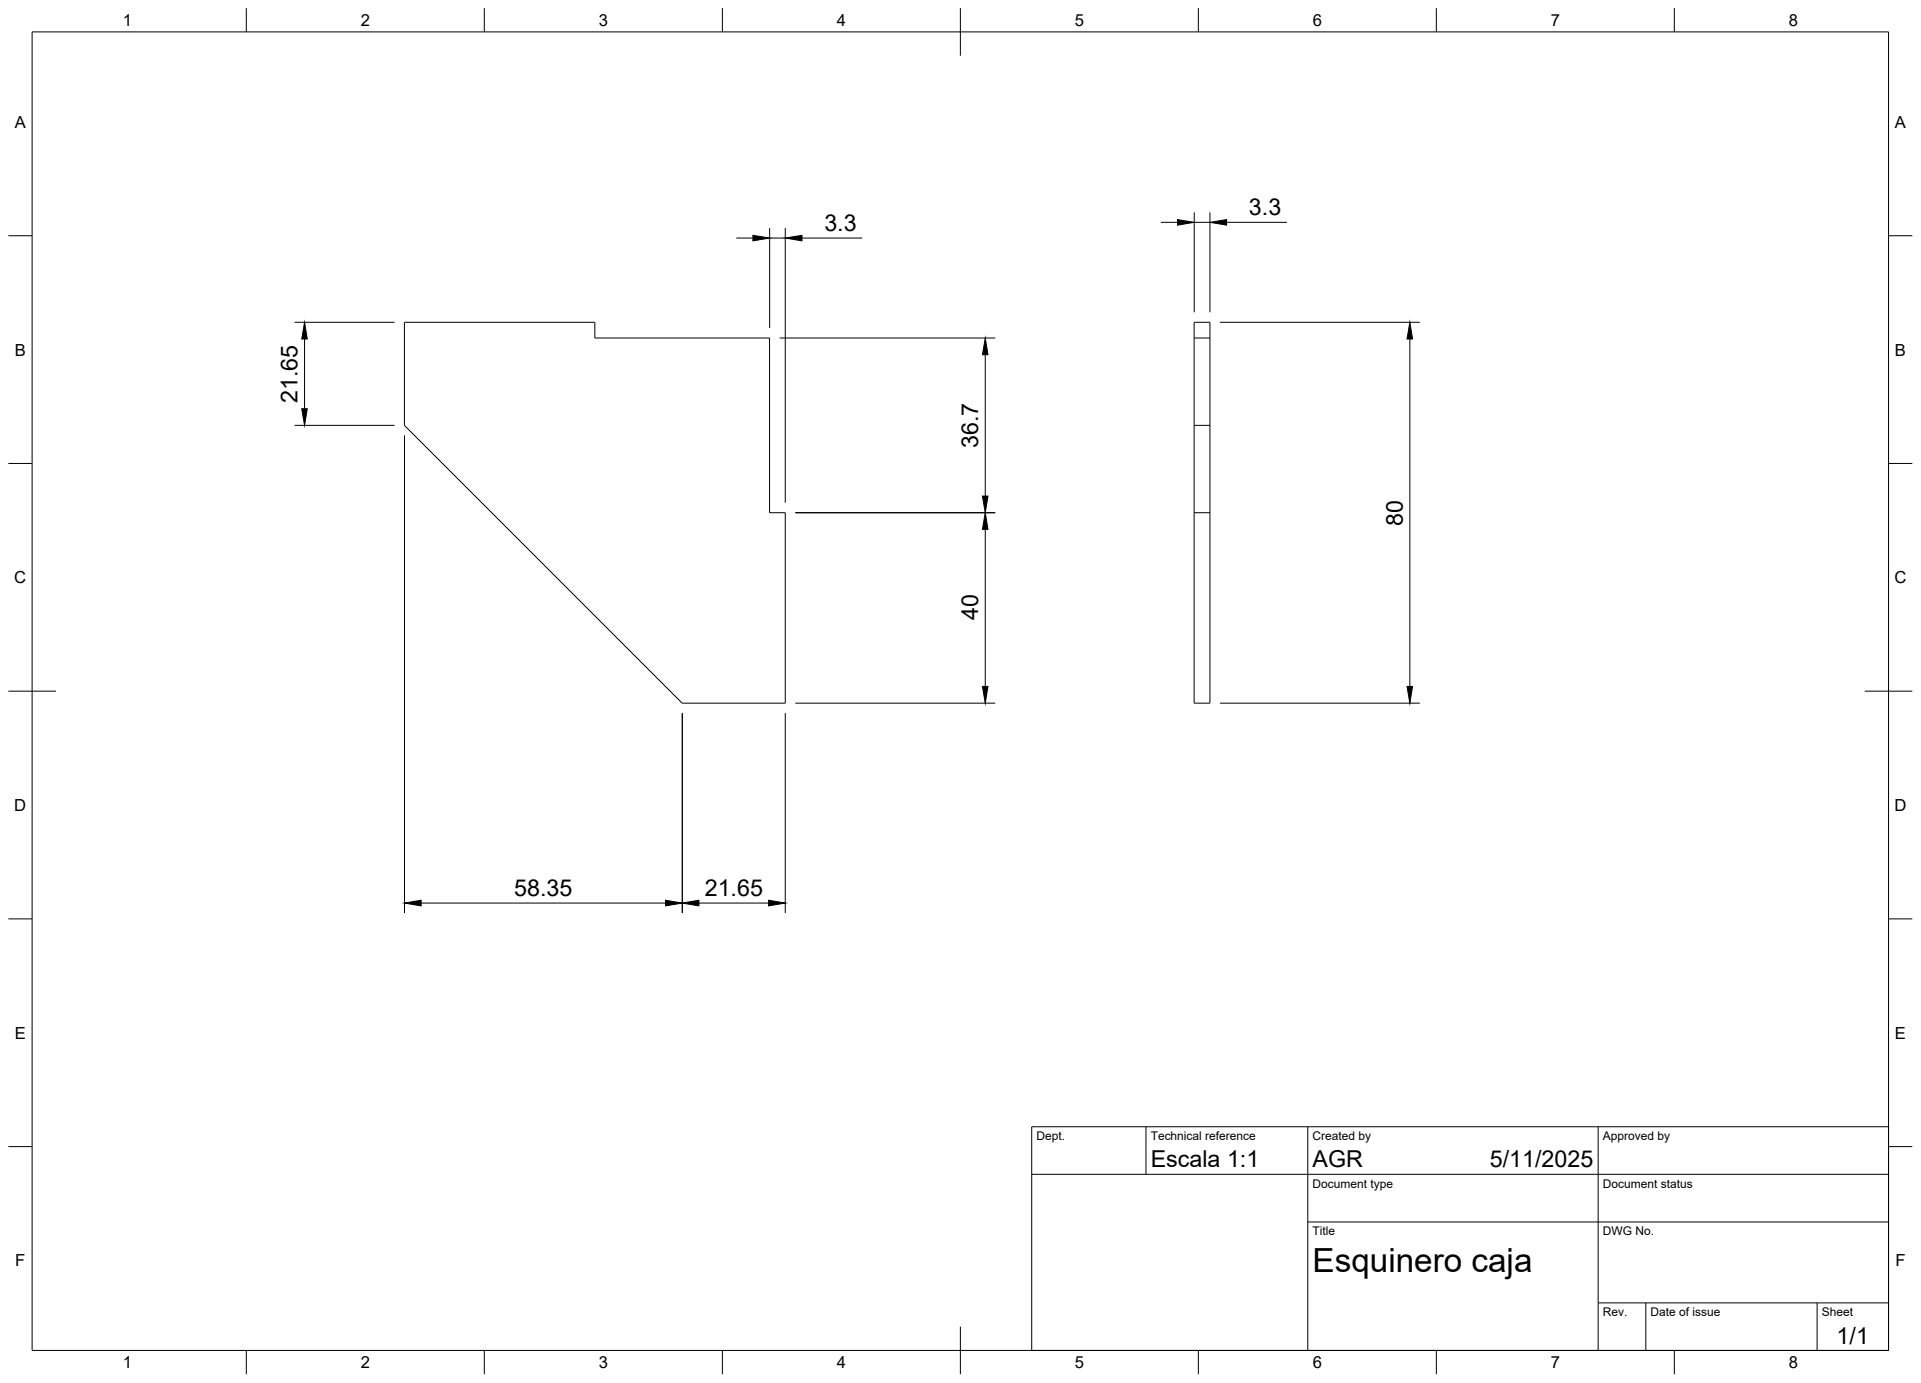
[picture p34: page 1]
Escala 1:1; AGR 80 40 36.7

Dept. | Technical reference | Created by 5/11/2025 | Approved by

Document type | Document status

Title Esquinero caja | DWG No.

Rev. | Date of issue | Sheet 1/1
