audisio-ing/UNLZ-Proyecto_Final-Estacion_de_Escaneo_3D_para_Analisis_de_Desviaciones_Dimensionales/Planos/Caja/Plano de Base de placa de prototipado v2.pdf

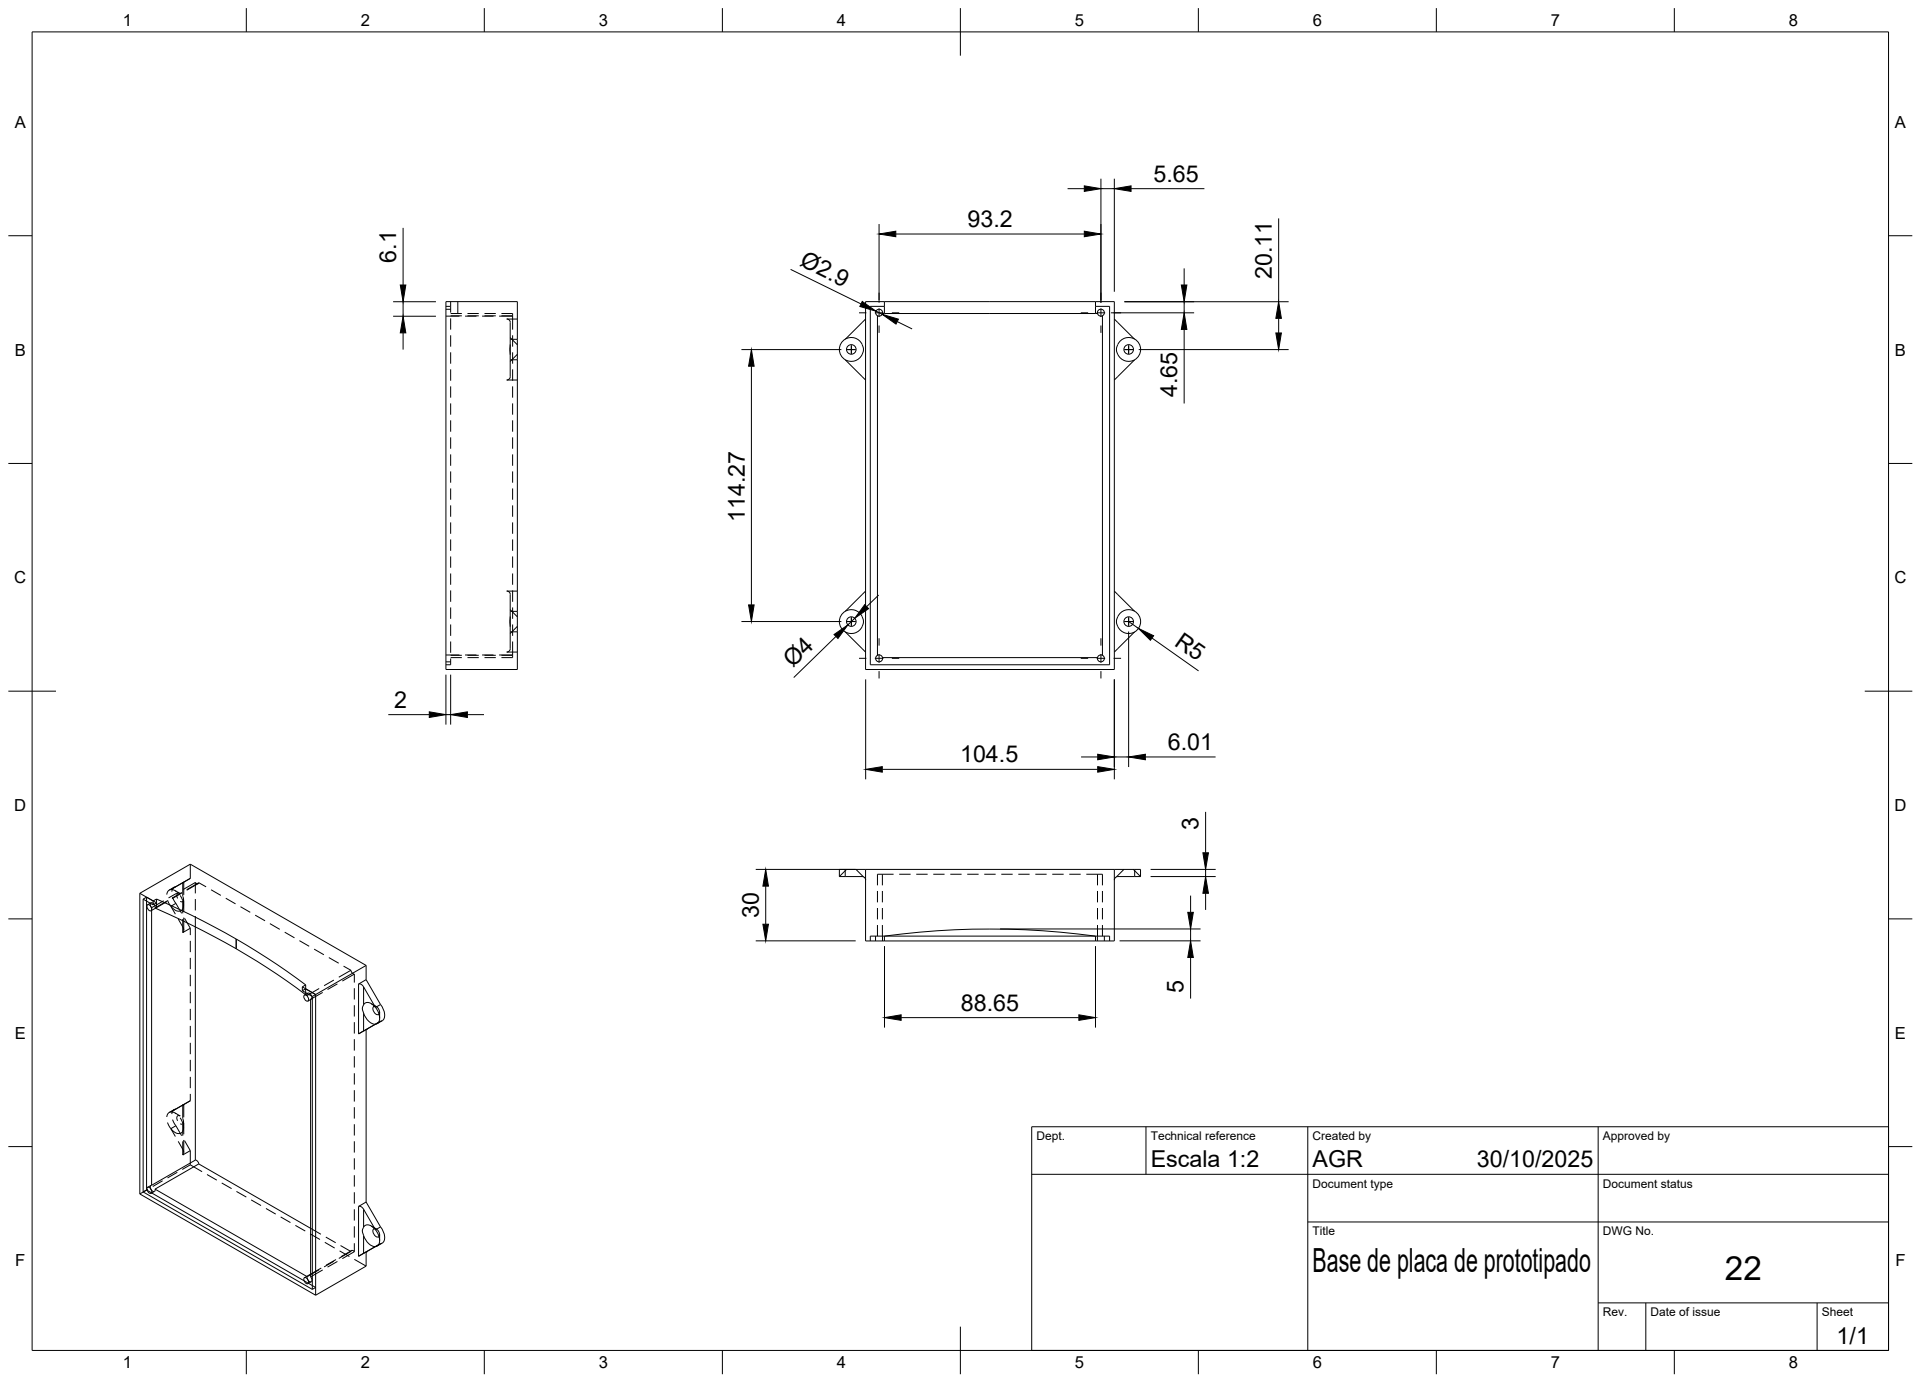
[picture p35: page 1]
Escala 1:2; AGR 114.27

Dept. | Technical reference | Created by 30/10/2025 | Approved by

Document type | Document status

Title Base de placa de prototipado | DWG No. 22

Rev. | Date of issue | Sheet 1/1
