audisio-ing/UNLZ-Proyecto_Final-Estacion_de_Escaneo_3D_para_Analisis_de_Desviaciones_Dimensionales/Planos/Caja/Plano entrada _ salida v2.pdf

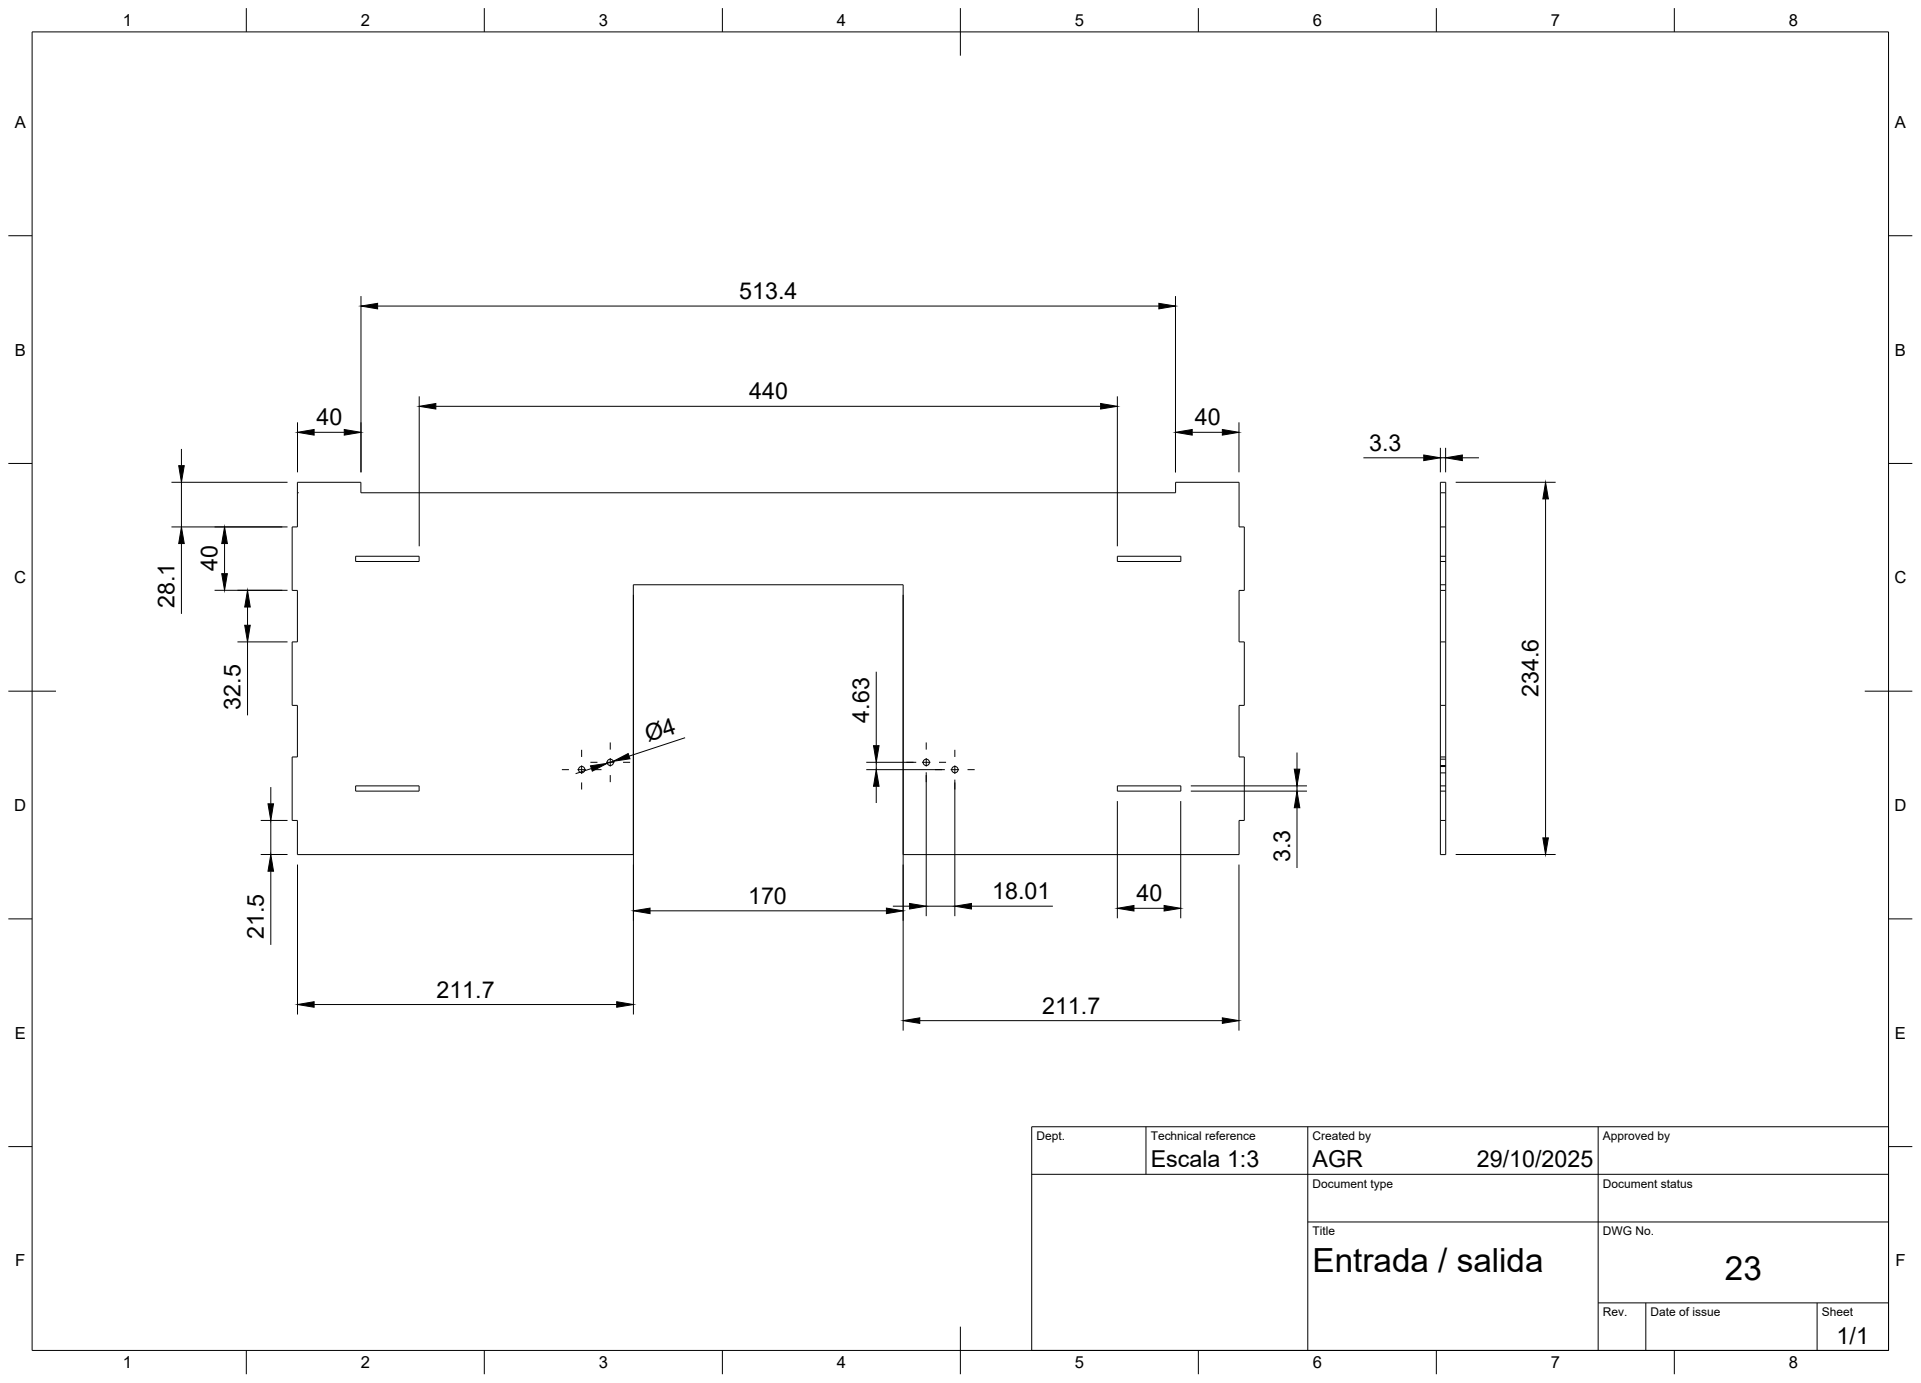
[picture p36: page 1]
Escala 1:3; AGR 40 32.5 21.5 28.1

Dept. | Technical reference | Created by 29/10/2025 | Approved by

Document type | Document status

Title Entrada / salida | DWG No. 23

Rev. | Date of issue | Sheet 1/1
