audisio-ing/UNLZ-Proyecto_Final-Estacion_de_Escaneo_3D_para_Analisis_de_Desviaciones_Dimensionales/Planos/Caja/Plano Paredes Caja v2.pdf

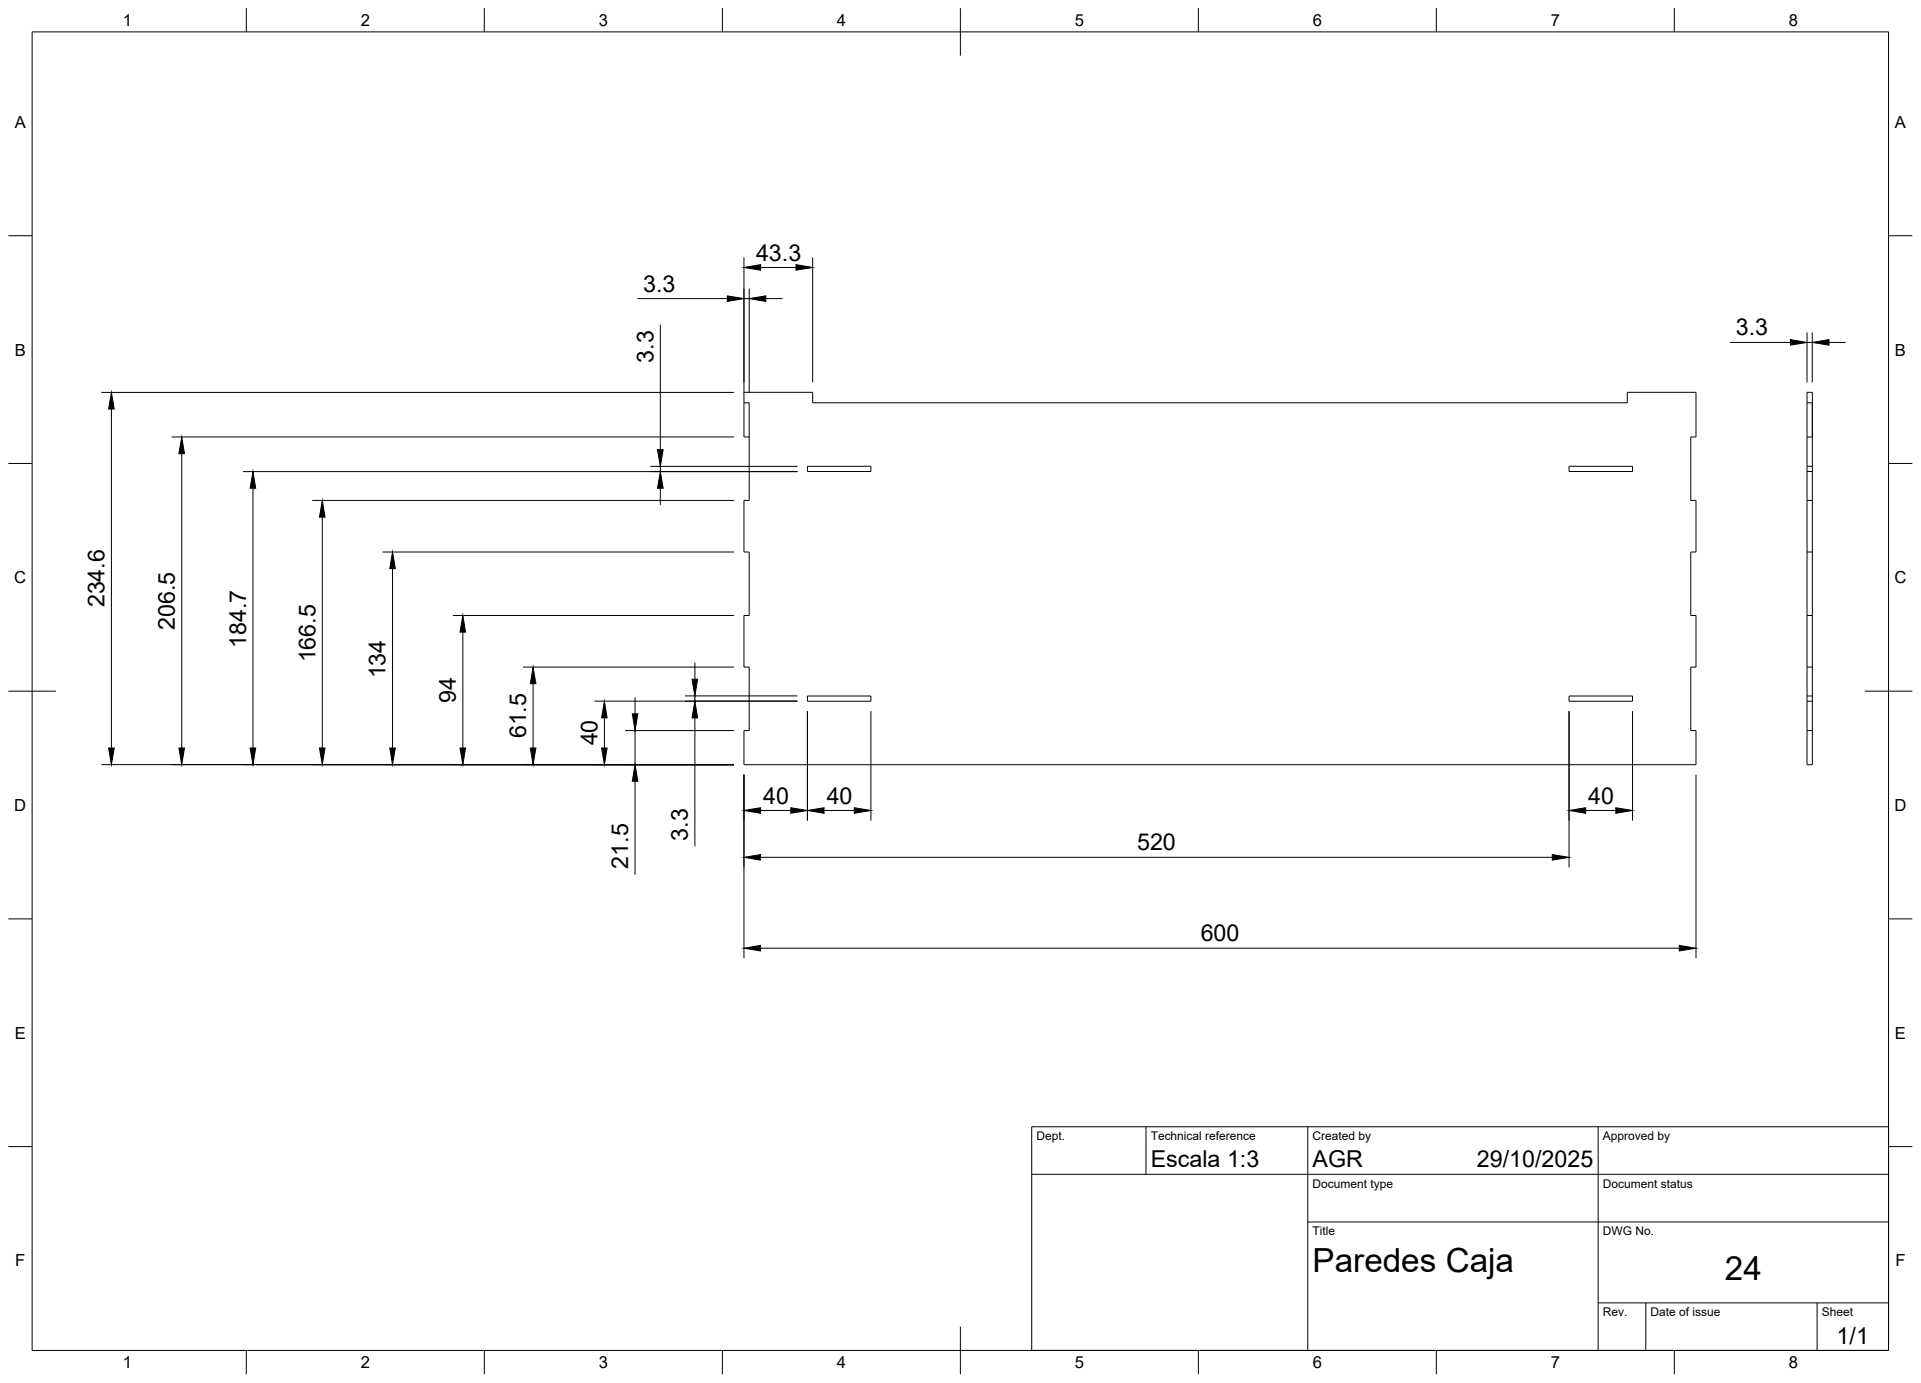
[picture p37: page 1]

Dept. | Technical reference Escala 1:3 | Created by AGR 29/10/2025 | Approved by

Document type | Document status

Title Paredes Caja | DWG No. 24

Rev. | Date of issue | Sheet 1/1
