audisio-ing/UNLZ-Proyecto_Final-Estacion_de_Escaneo_3D_para_Analisis_de_Desviaciones_Dimensionales/Planos/Cinta/Plano centrador v4.pdf

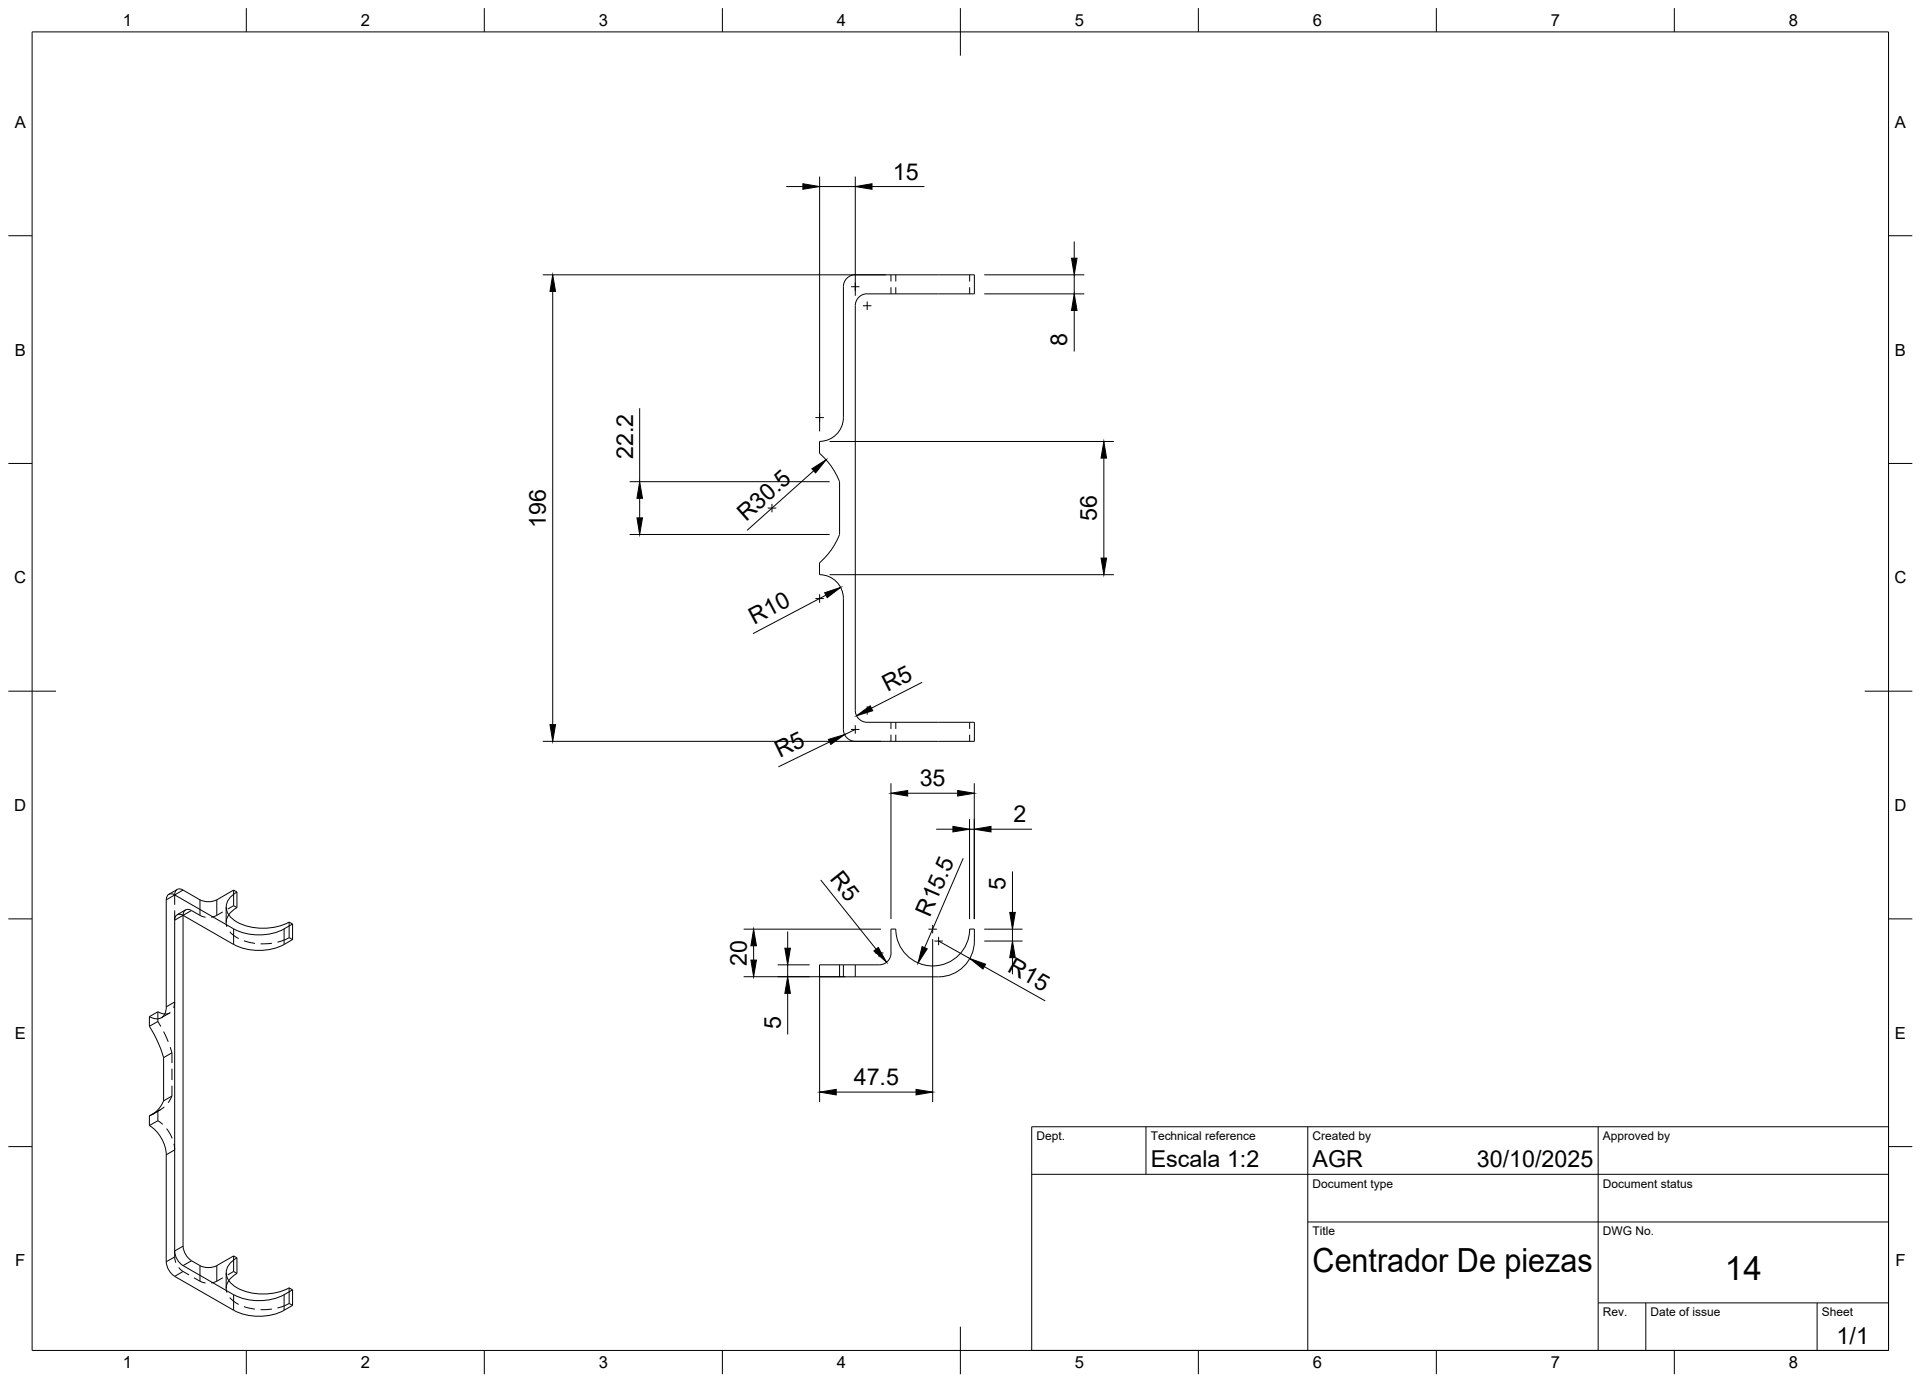
[picture p40: page 1]
Escala 1:2; AGR 22.2

Dept. | Technical reference | Created by 30/10/2025 | Approved by

Document type | Document status

Title Centrador De piezas | DWG No. 14

Rev. | Date of issue | Sheet 1/1
