audisio-ing/UNLZ-Proyecto_Final-Estacion_de_Escaneo_3D_para_Analisis_de_Desviaciones_Dimensionales/Planos/Cinta/Plano Enrganajes M_2 15 dientes v2.pdf

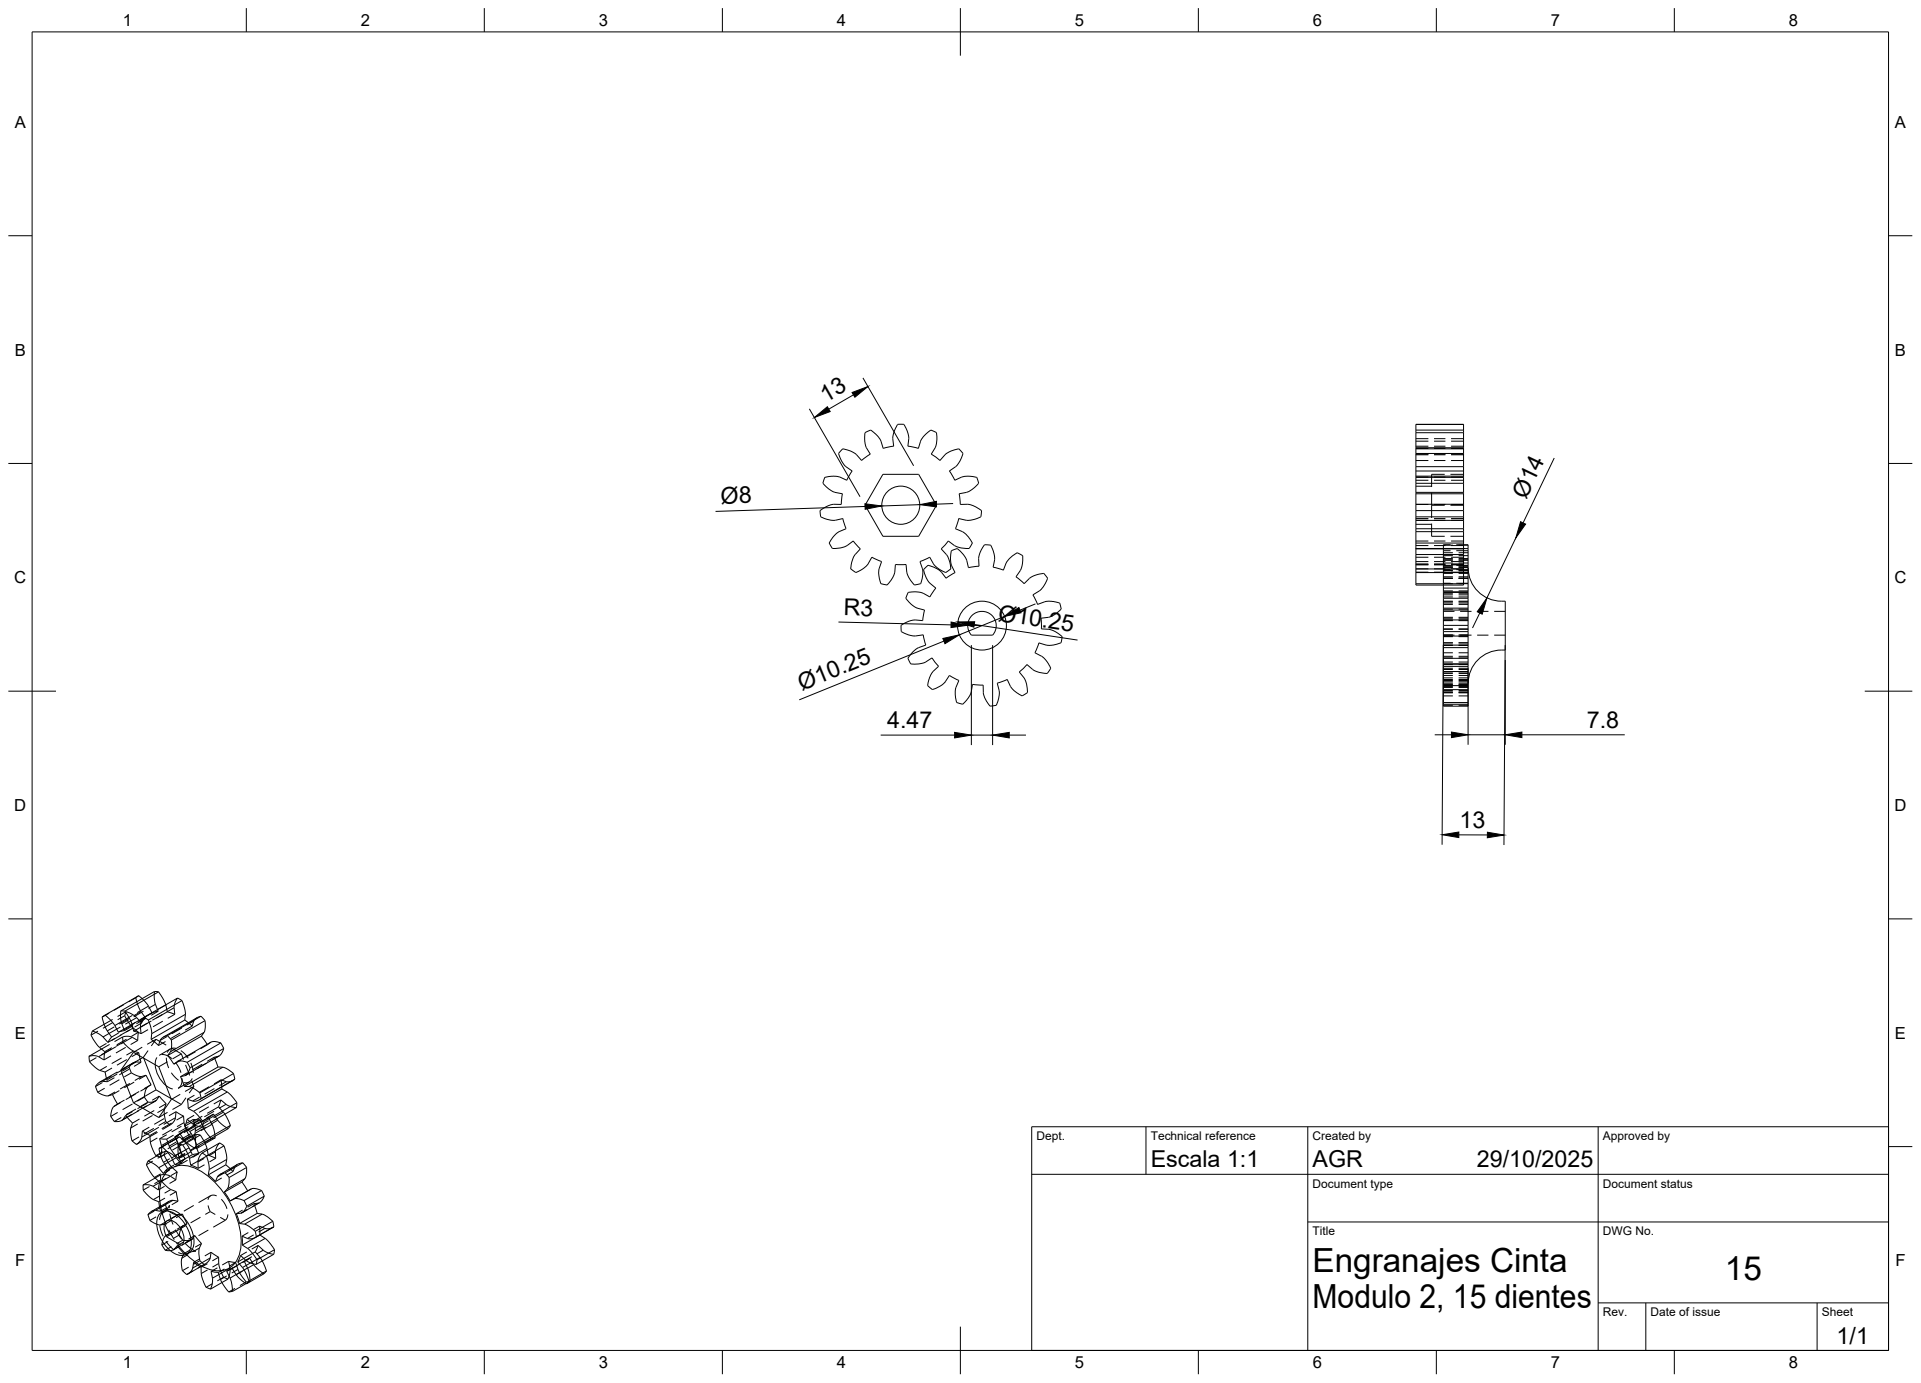
[picture p41: page 1]

Dept. | Technical reference Escala 1:1 | Created by AGR 29/10/2025 | Approved by

Document type | Document status

Title Engranajes Cinta Modulo 2, 15 dientes | DWG No. 15

Rev. | Date of issue | Sheet 1/1
