audisio-ing/UNLZ-Proyecto_Final-Estacion_de_Escaneo_3D_para_Analisis_de_Desviaciones_Dimensionales/Planos/Cinta/Plano soporte paso a paso v2.pdf

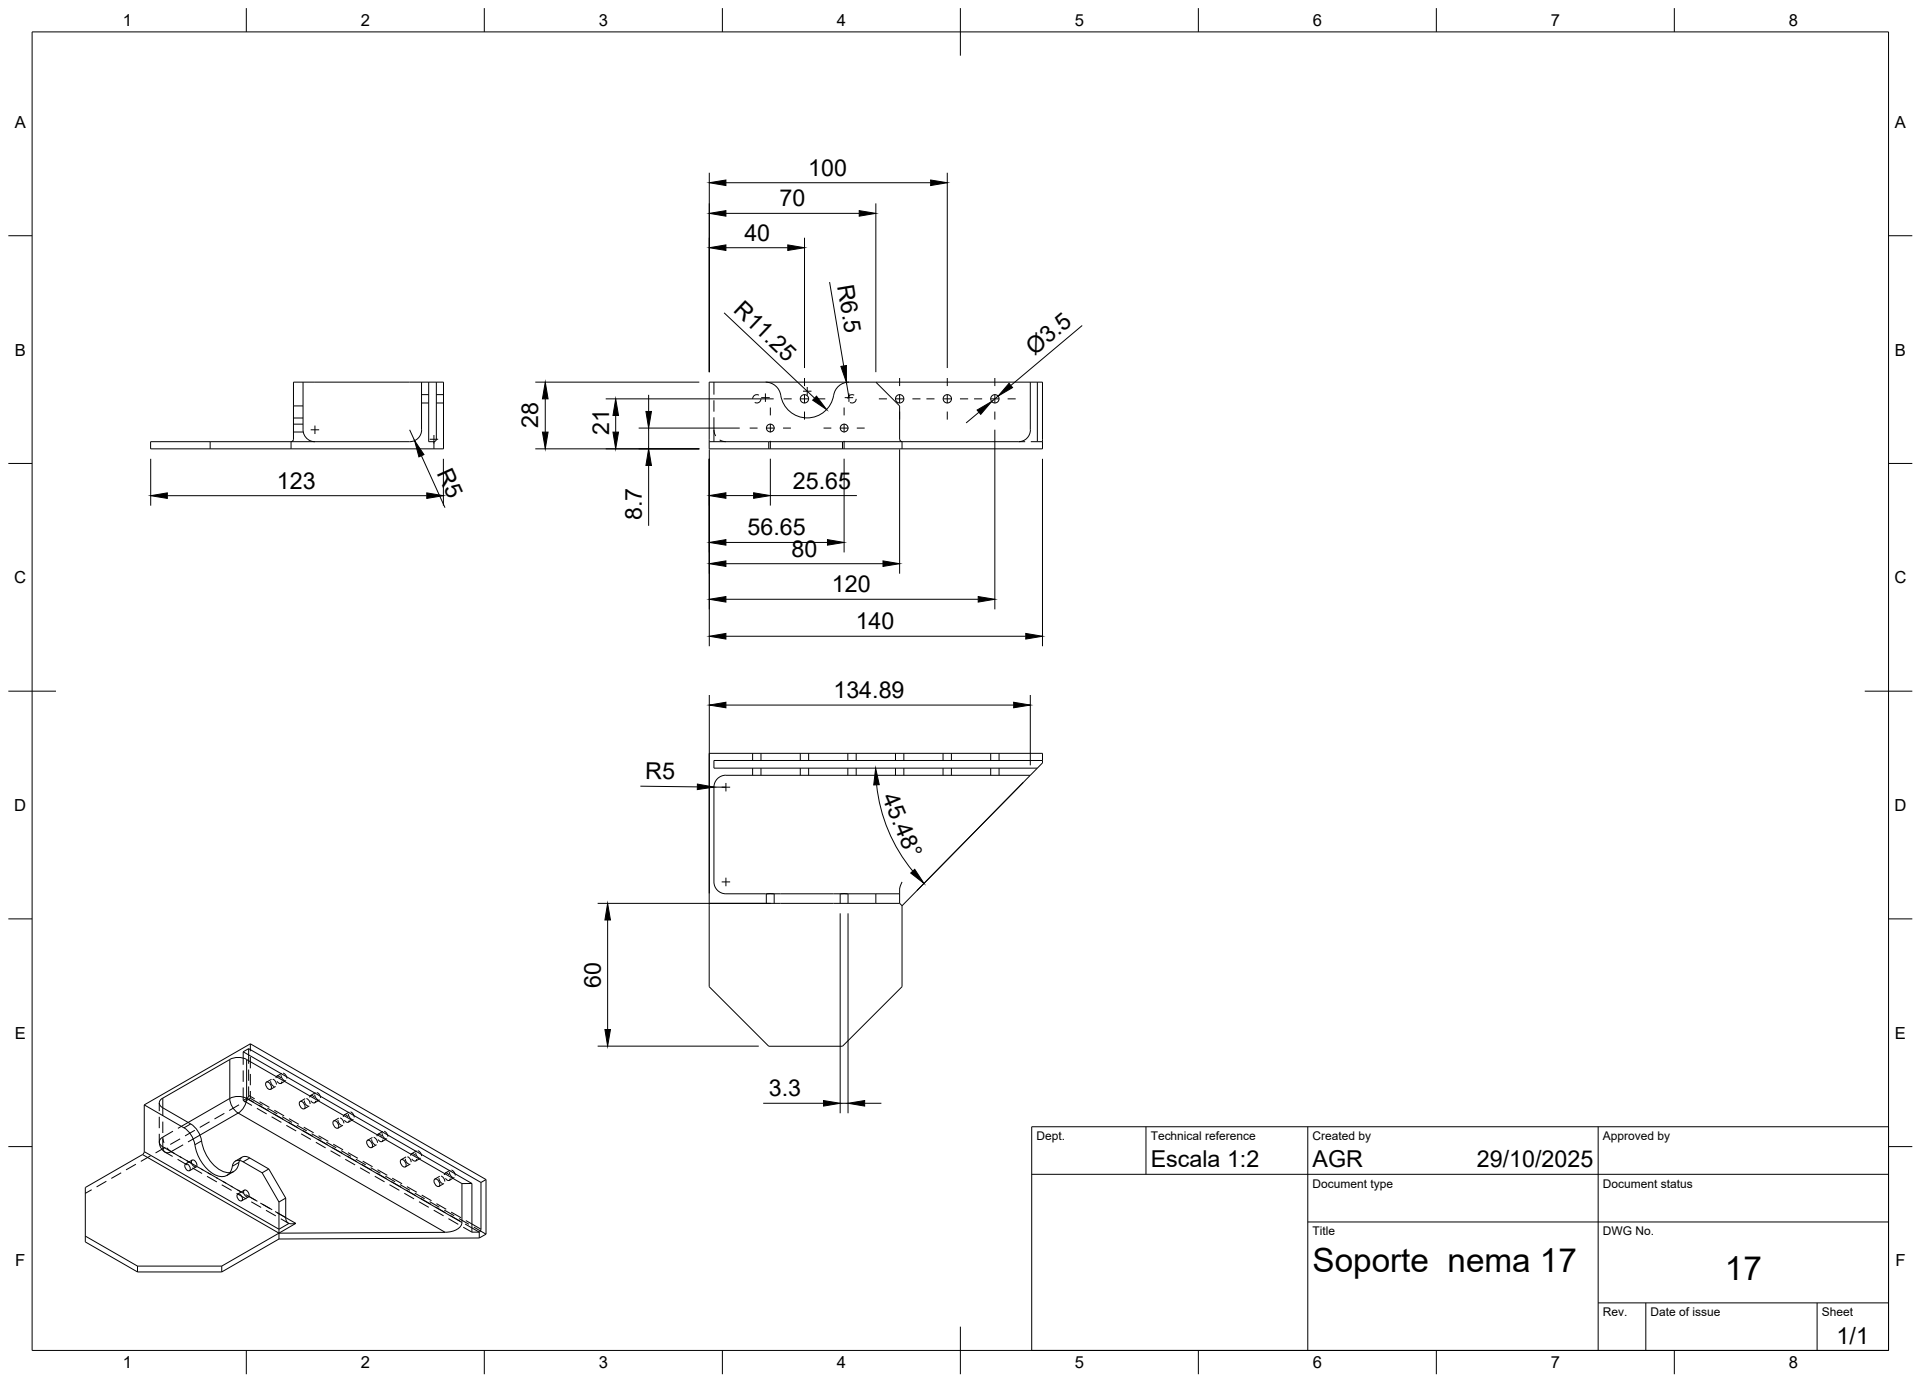
[picture p42: page 1]

Dept. | Technical reference Escala 1:2 | Created by AGR 29/10/2025 | Approved by

Document type | Document status

Title Soporte nema 17 | DWG No. 17

Rev. | Date of issue | Sheet 1/1
