audisio-ing/UNLZ-Proyecto_Final-Estacion_de_Escaneo_3D_para_Analisis_de_Desviaciones_Dimensionales/Planos/Cinta/Plano Soporte Rodamiento v3.pdf

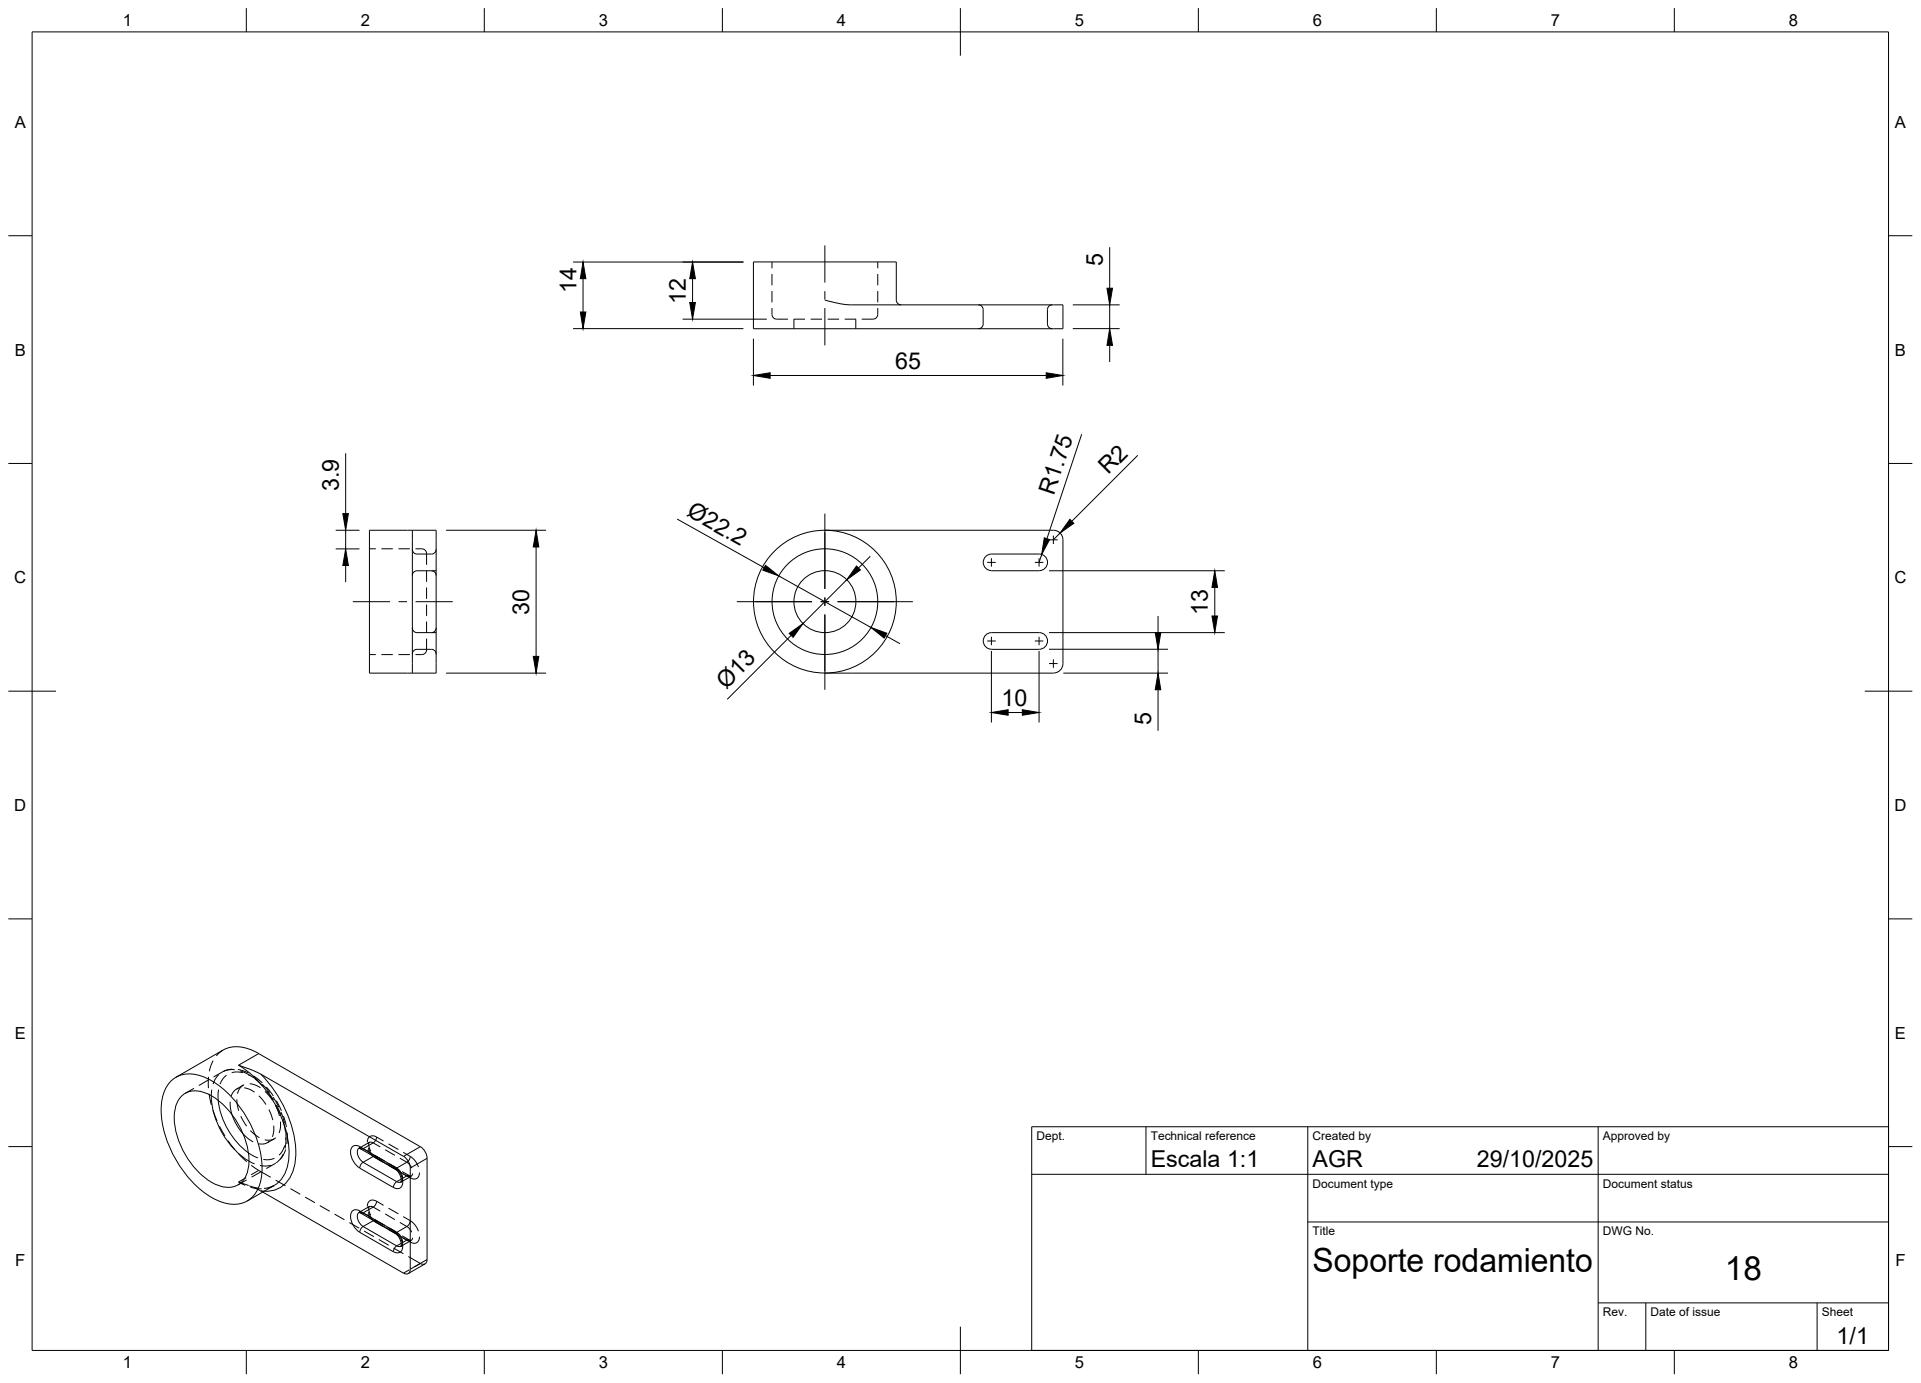
[picture p43: page 1]

Dept. | Technical reference Escala 1:1 | Created by AGR 29/10/2025 | Approved by

Document type | Document status

Title Soporte rodamiento | DWG No. 18

Rev. | Date of issue | Sheet 1/1
