audisio-ing/UNLZ-Proyecto_Final-Estacion_de_Escaneo_3D_para_Analisis_de_Desviaciones_Dimensionales/Planos/Cinta/Plano soporte tuercas M3 v2.pdf

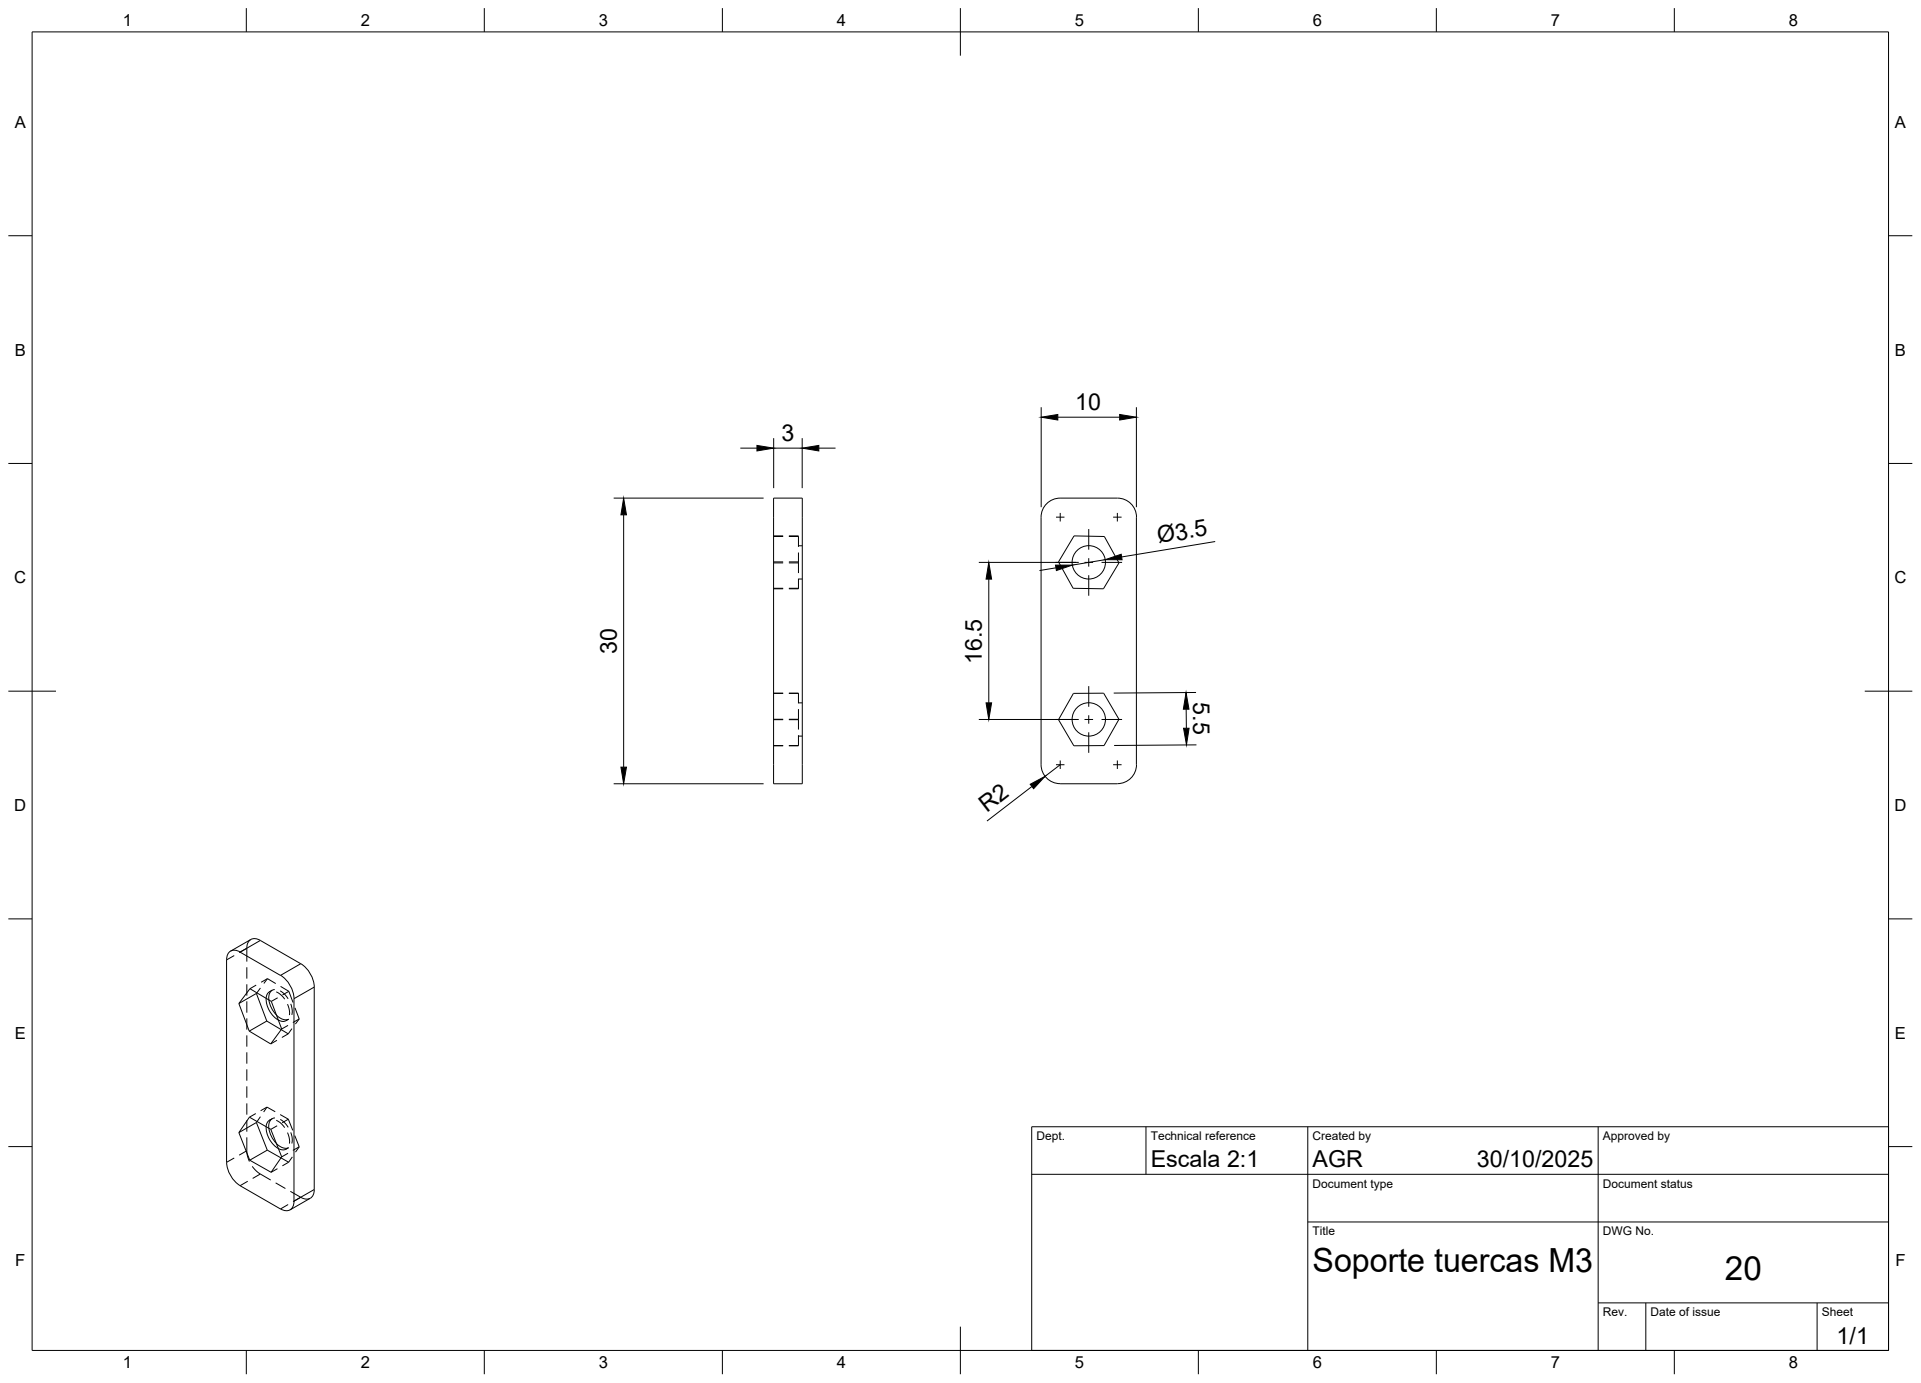
[picture p44: page 1]
Escala 2:1; AGR 30

Dept. | Technical reference | Created by 30/10/2025 | Approved by

Document type | Document status

Title Soporte tuercas M3 | DWG No. 20

Rev. | Date of issue | Sheet 1/1
