audisio-ing/UNLZ-Proyecto_Final-Estacion_de_Escaneo_3D_para_Analisis_de_Desviaciones_Dimensionales/Planos/Cinta/Plano tapas de tambor v3.pdf

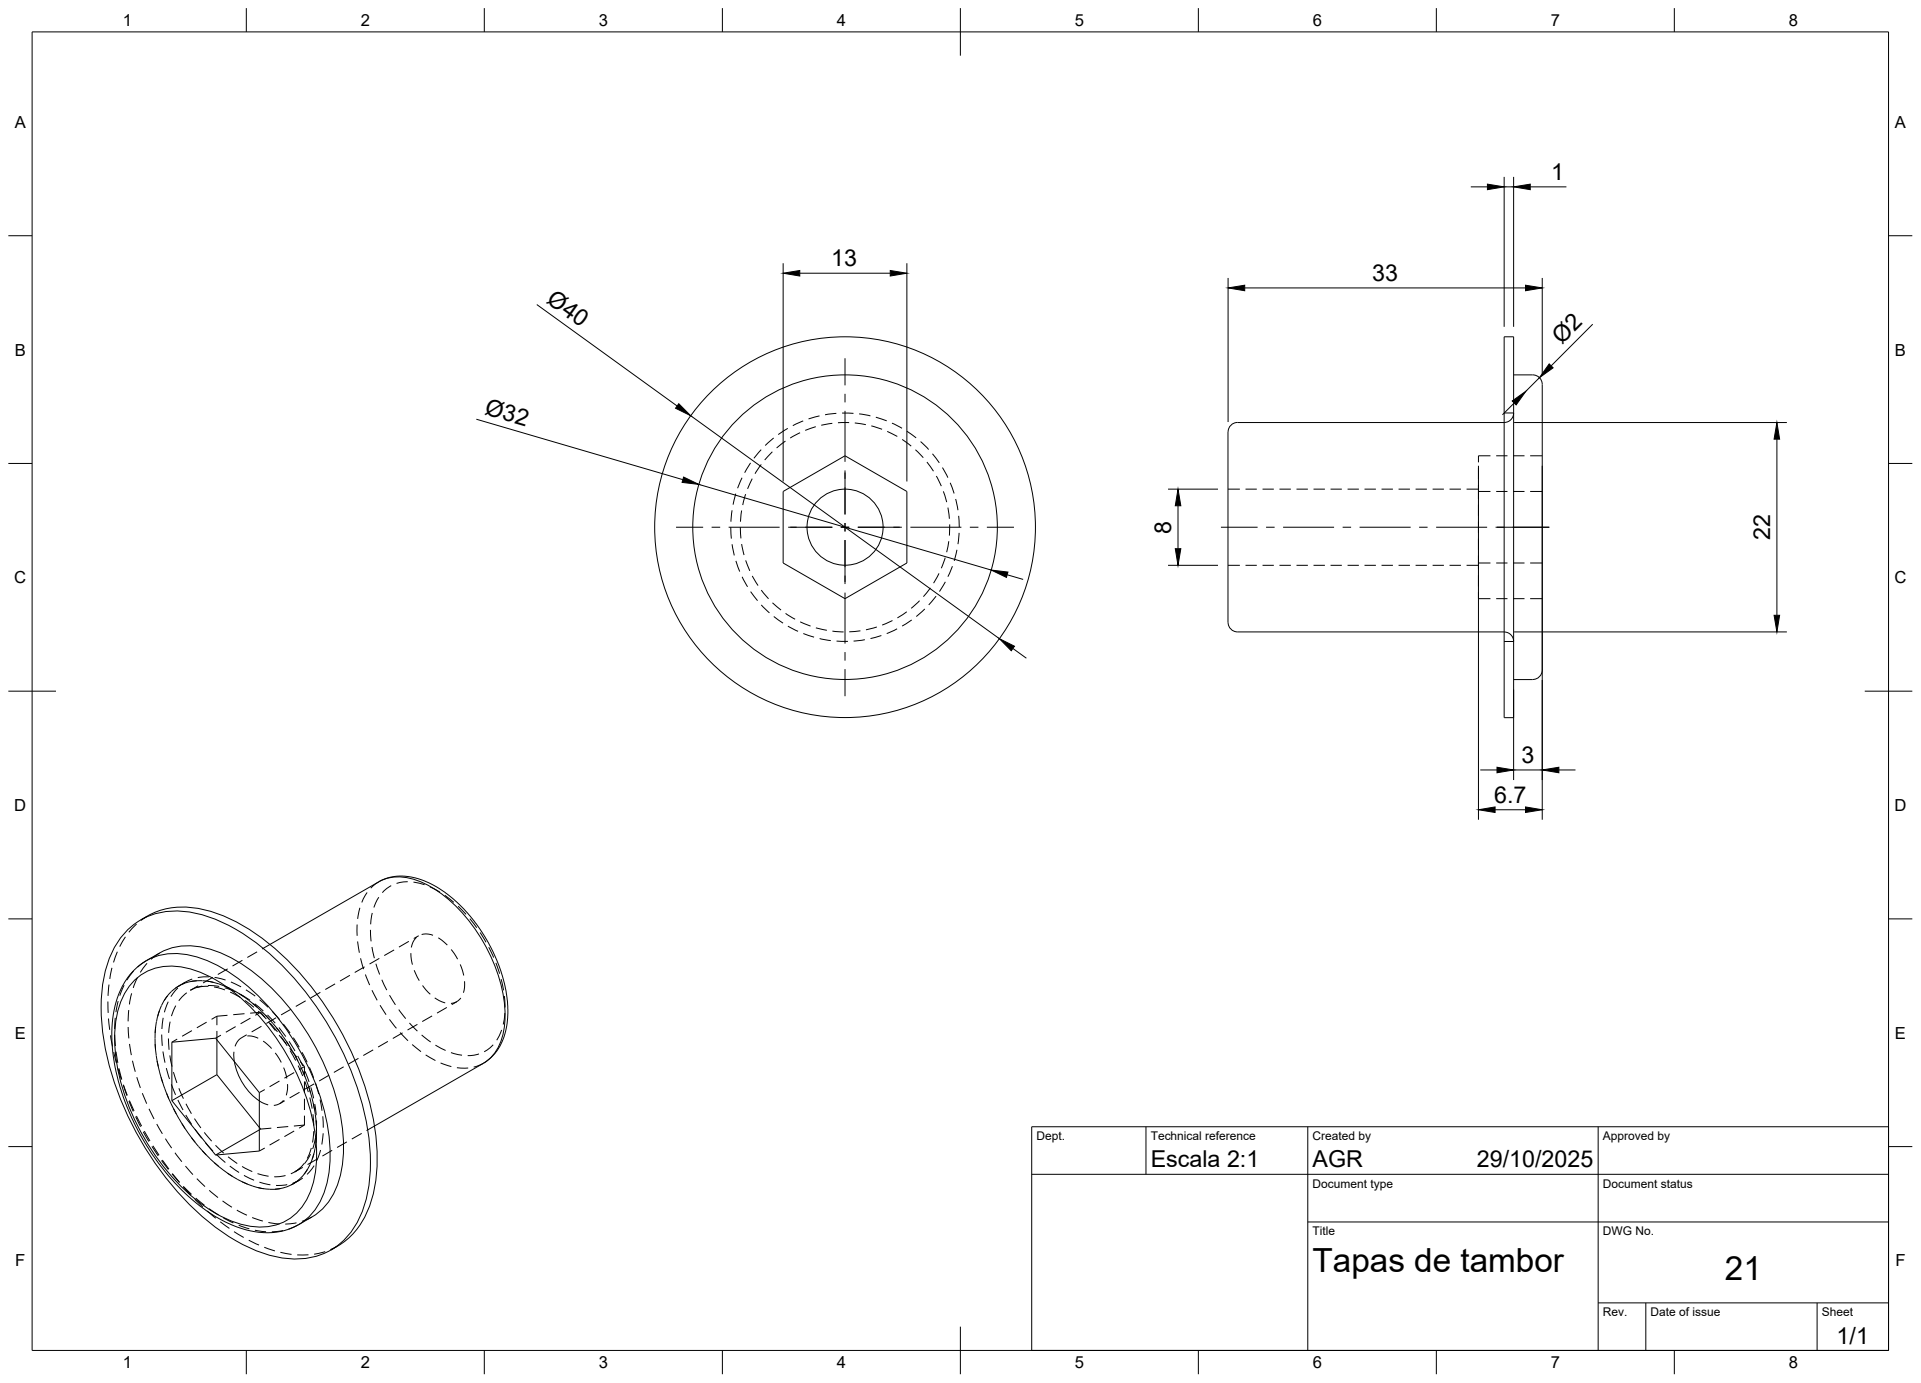
[picture p45: page 1]

Dept. | Technical reference Escala 2:1 | Created by AGR 29/10/2025 | Approved by

Document type | Document status

Title Tapas de tambor | DWG No. 21

Rev. | Date of issue | Sheet 1/1
