audisio-ing/UNLZ-Proyecto_Final-Estacion_de_Escaneo_3D_para_Analisis_de_Desviaciones_Dimensionales/Planos/Mecanismo Giratorio/Agujereado de varilla de aluminio v1.pdf

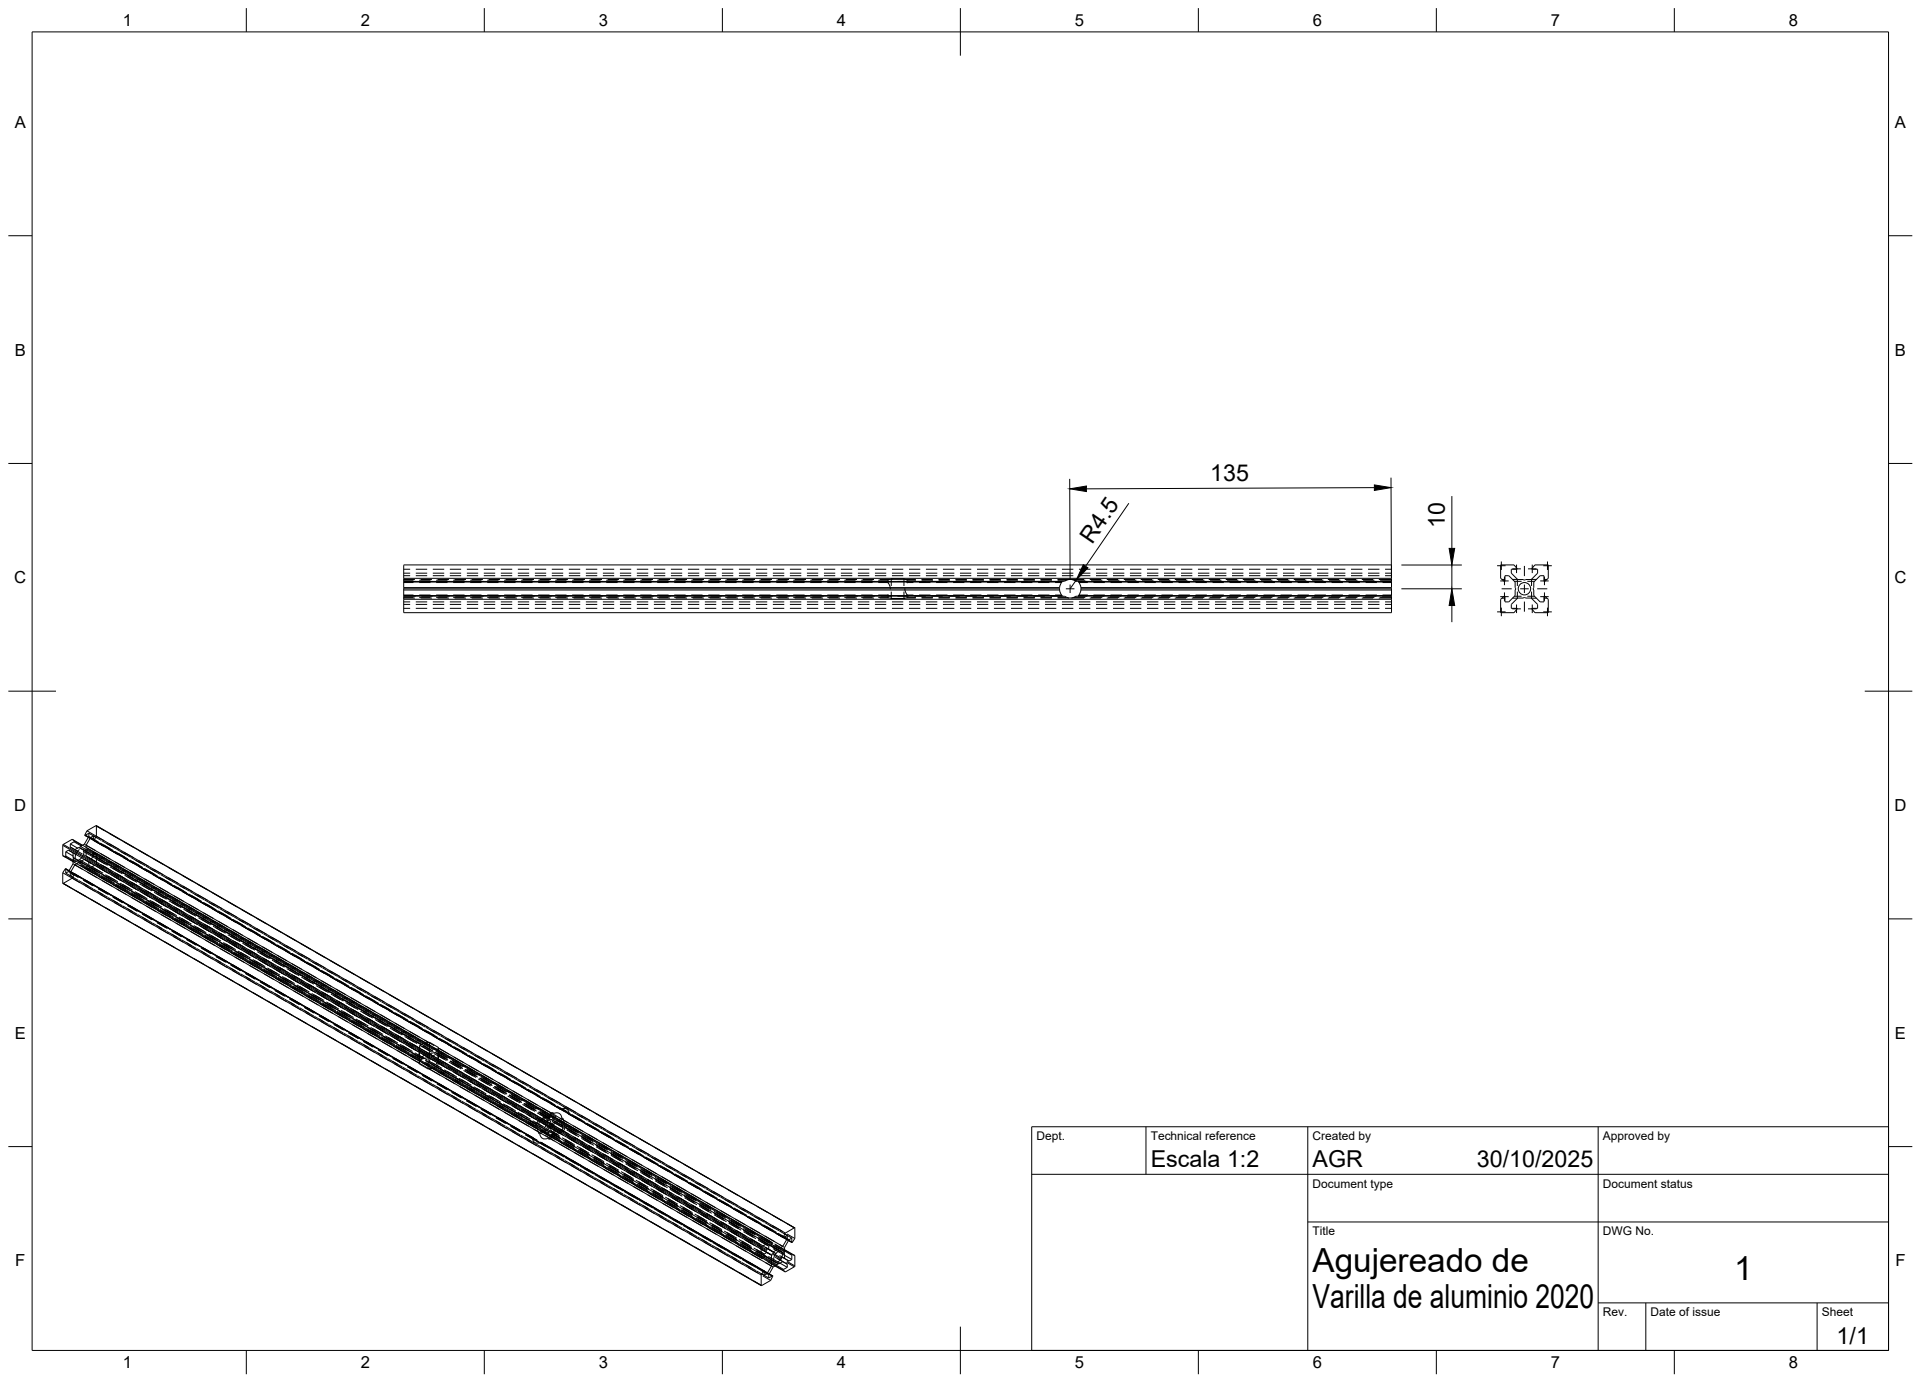
[picture p46: page 1]

Dept. | Technical reference Escala 1:2 | Created by AGR 30/10/2025 | Approved by

Document type | Document status

Title Agujereado de Varilla de aluminio 2020 | DWG No. 1

Rev. | Date of issue | Sheet 1/1
