audisio-ing/UNLZ-Proyecto_Final-Estacion_de_Escaneo_3D_para_Analisis_de_Desviaciones_Dimensionales/Planos/Mecanismo Giratorio/Cuerpo varilla roscada - perfil v4.pdf

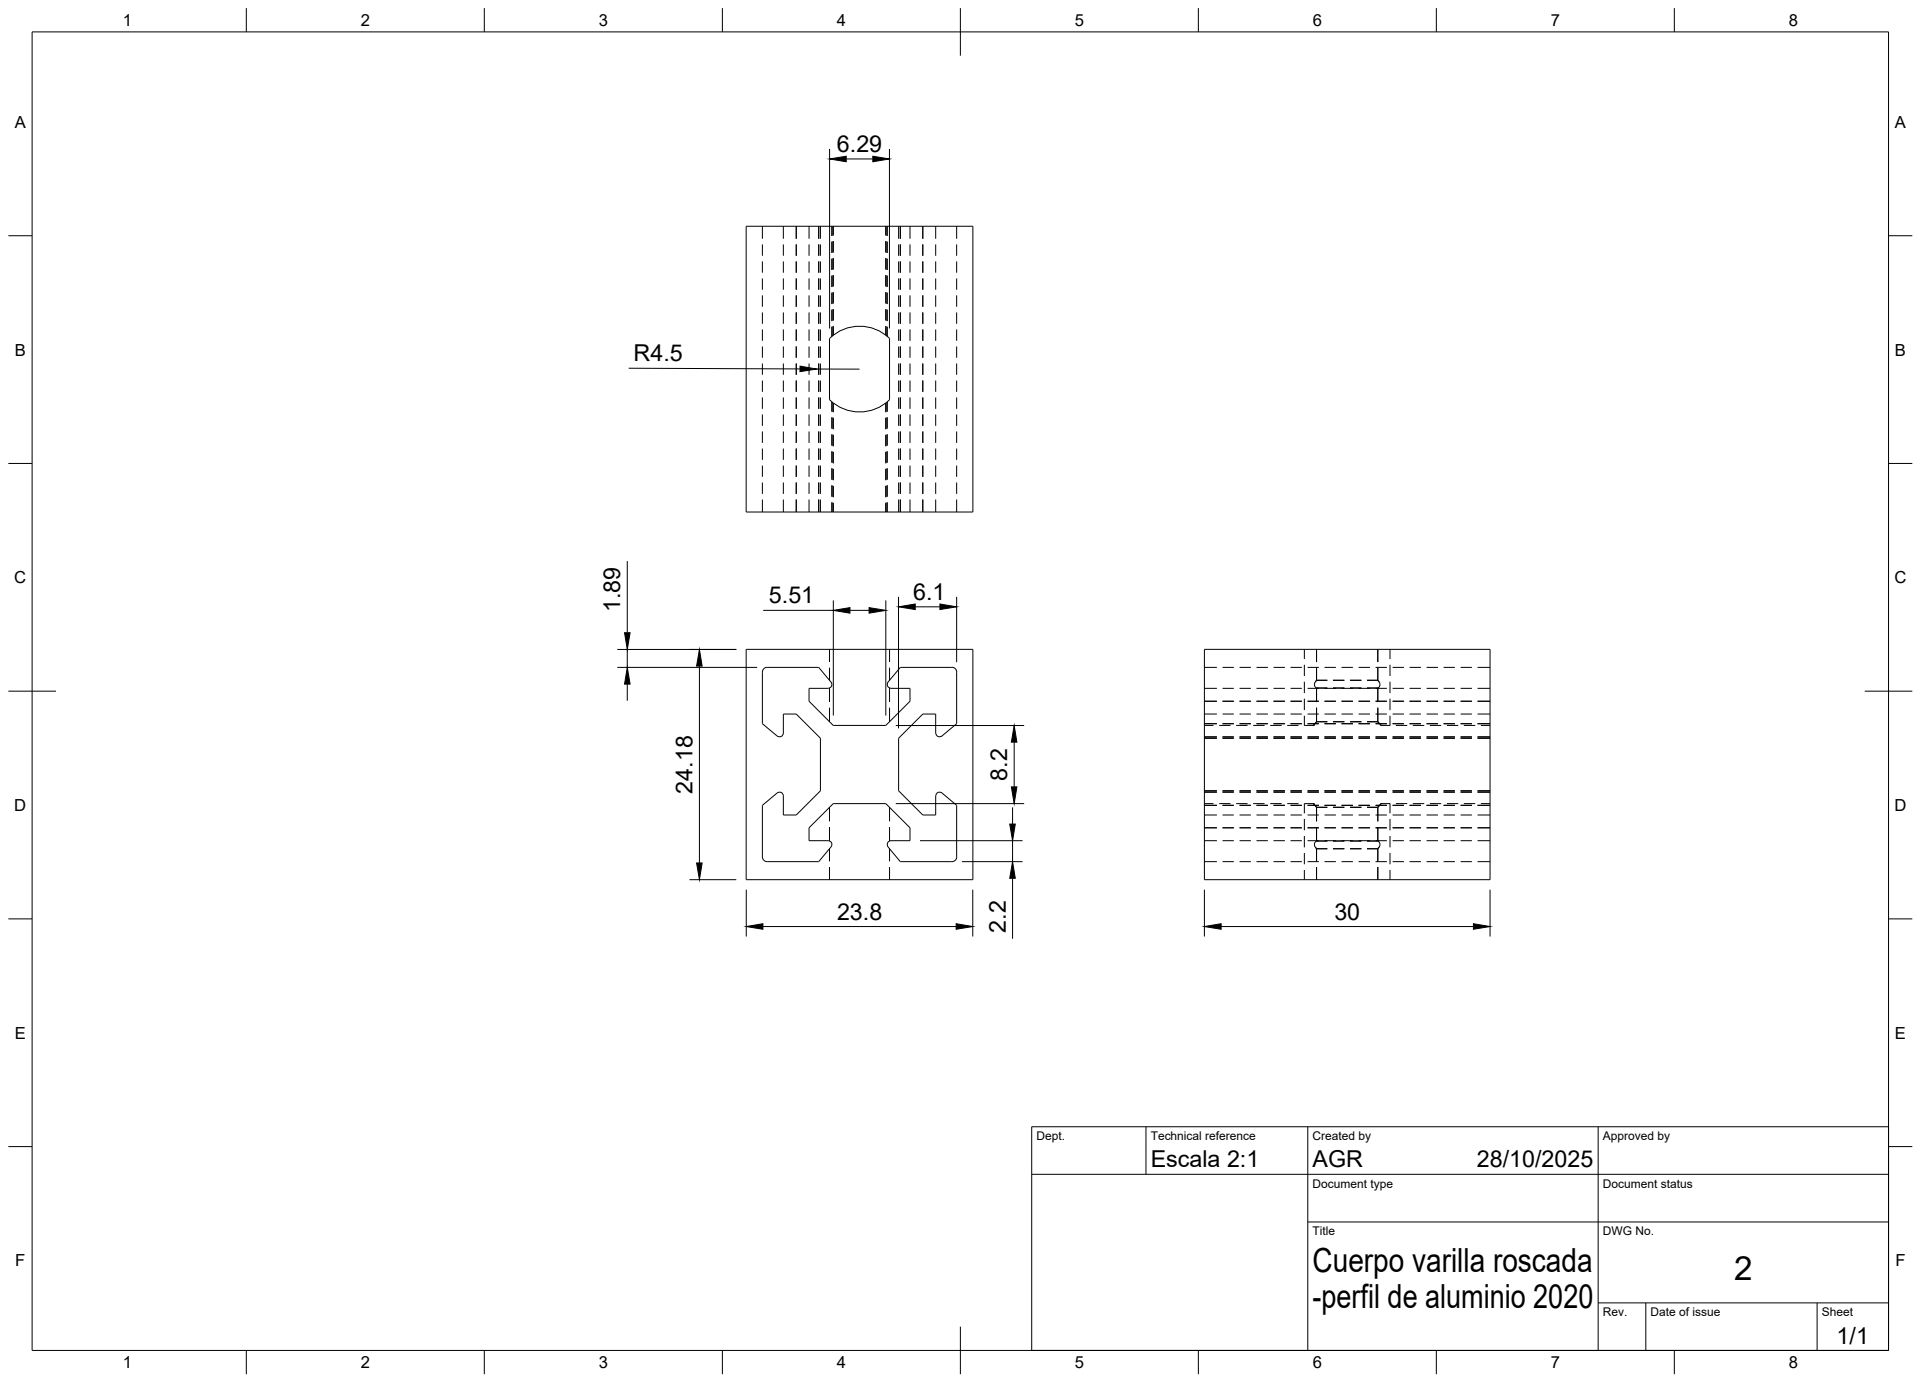
[picture p47: page 1]
Escala 2:1; AGR 24.18

Dept. | Technical reference | Created by 28/10/2025 | Approved by

Document type | Document status

Title Cuerpo varilla roscada -perfil de aluminio 2020 | DWG No. 2

Rev. | Date of issue | Sheet 1/1
