audisio-ing/UNLZ-Proyecto_Final-Estacion_de_Escaneo_3D_para_Analisis_de_Desviaciones_Dimensionales/Planos/Mecanismo Giratorio/Guia lente v4.pdf

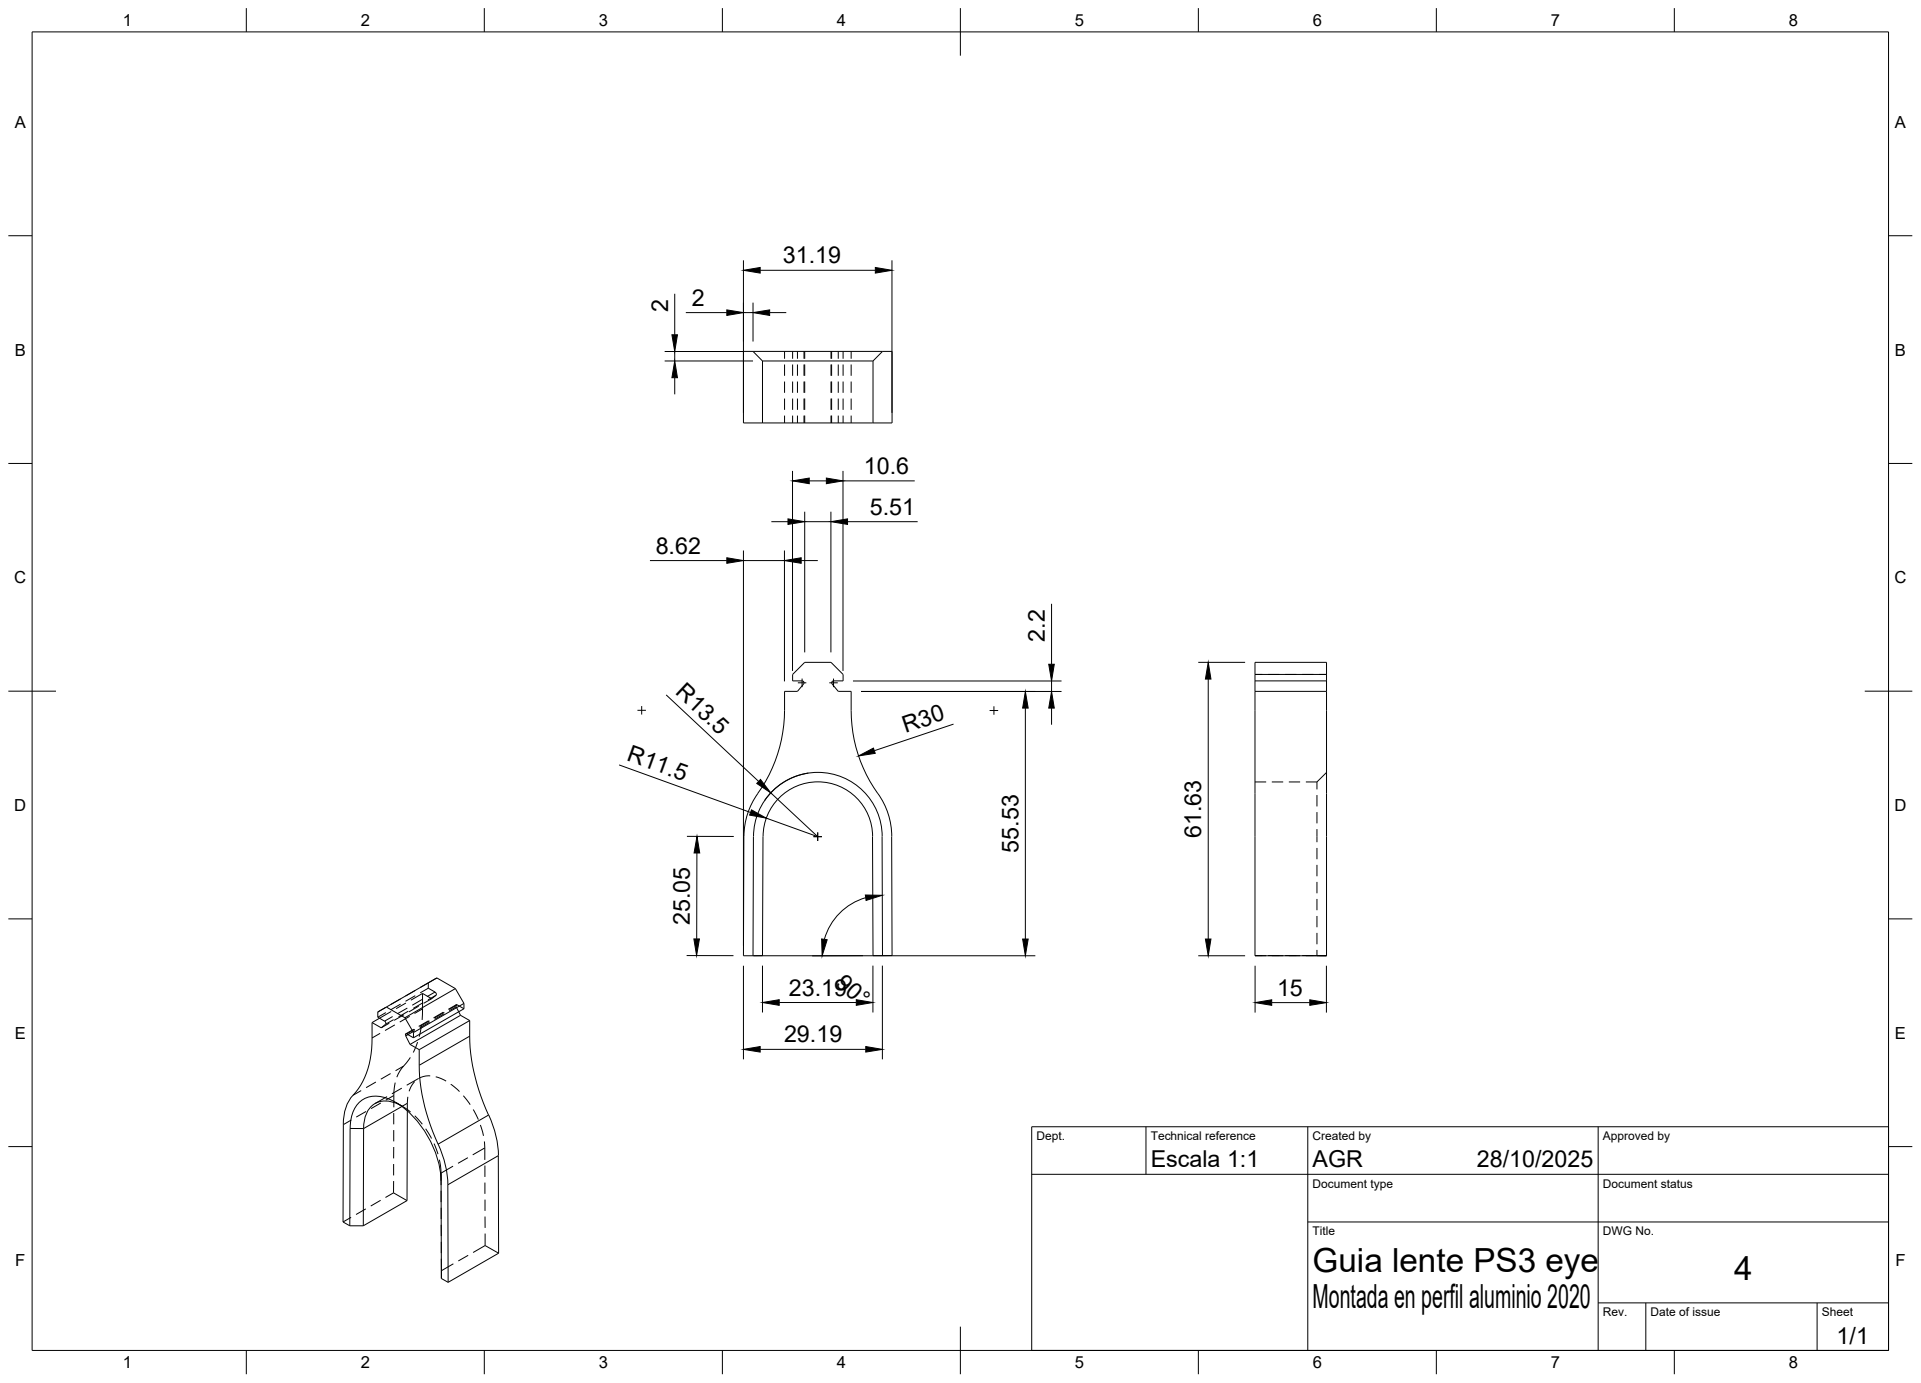
[picture p48: page 1]
Escala 1:1; AGR 61.63

Dept. | Technical reference | Created by 28/10/2025 | Approved by

Document type | Document status

Title Guia lente PS3 eye Montada en perfil aluminio 2020 | DWG No. 4

Rev. | Date of issue | Sheet 1/1
