audisio-ing/UNLZ-Proyecto_Final-Estacion_de_Escaneo_3D_para_Analisis_de_Desviaciones_Dimensionales/Planos/Mecanismo Giratorio/Plano nivelador v1.pdf

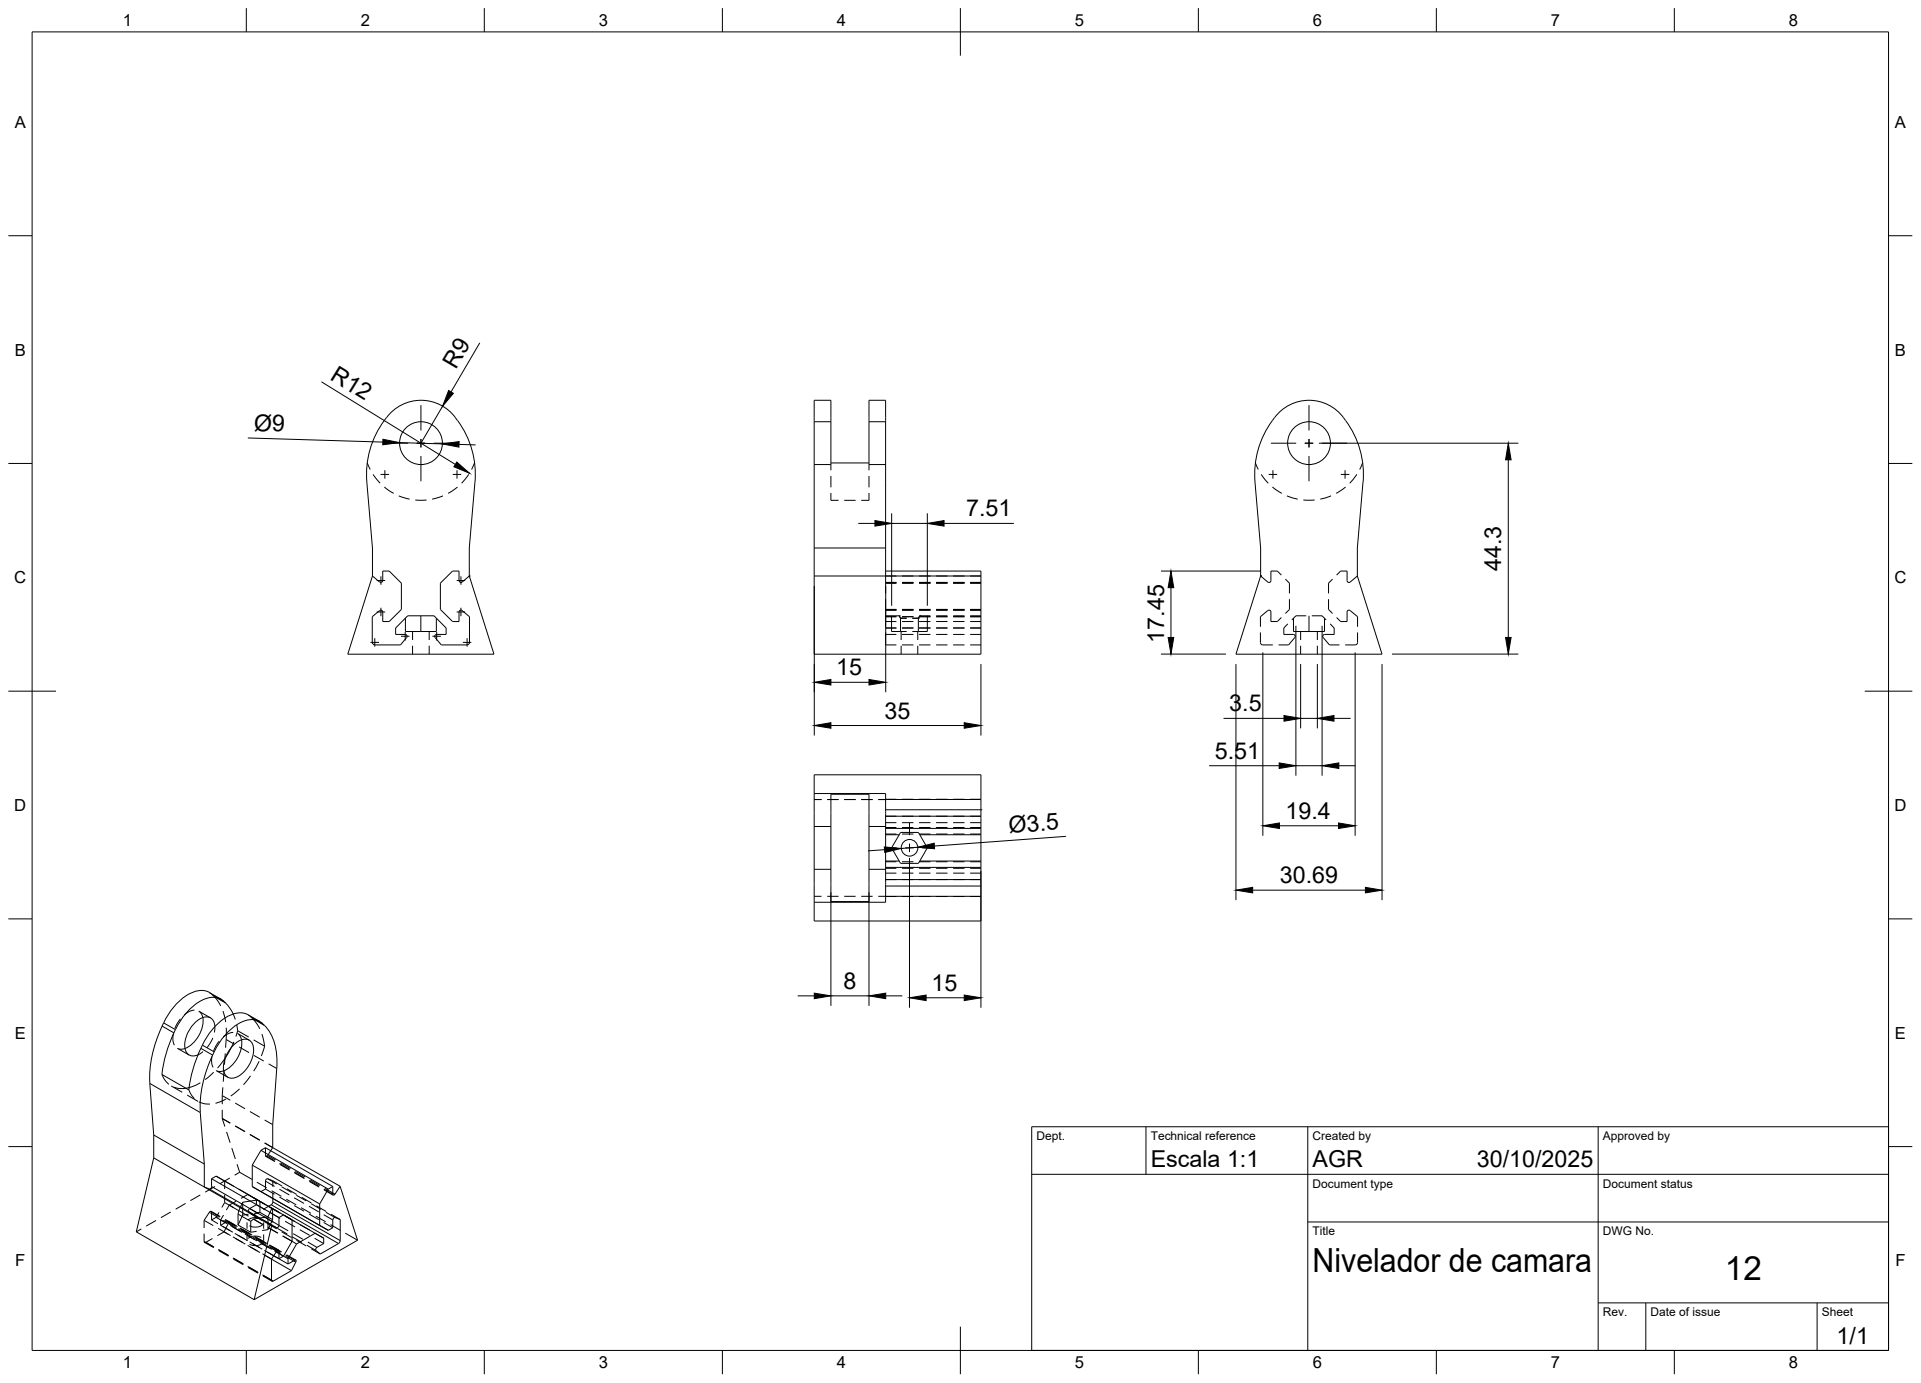
[picture p49: page 1]
Escala 1:1; AGR

Dept. | Technical reference | Created by 30/10/2025 | Approved by

Document type | Document status

Title Nivelador de camara | DWG No. 12

Rev. | Date of issue | Sheet 1/1
