audisio-ing/UNLZ-Proyecto_Final-Estacion_de_Escaneo_3D_para_Analisis_de_Desviaciones_Dimensionales/Planos/Mecanismo Giratorio/Plano tensor correa v3.pdf

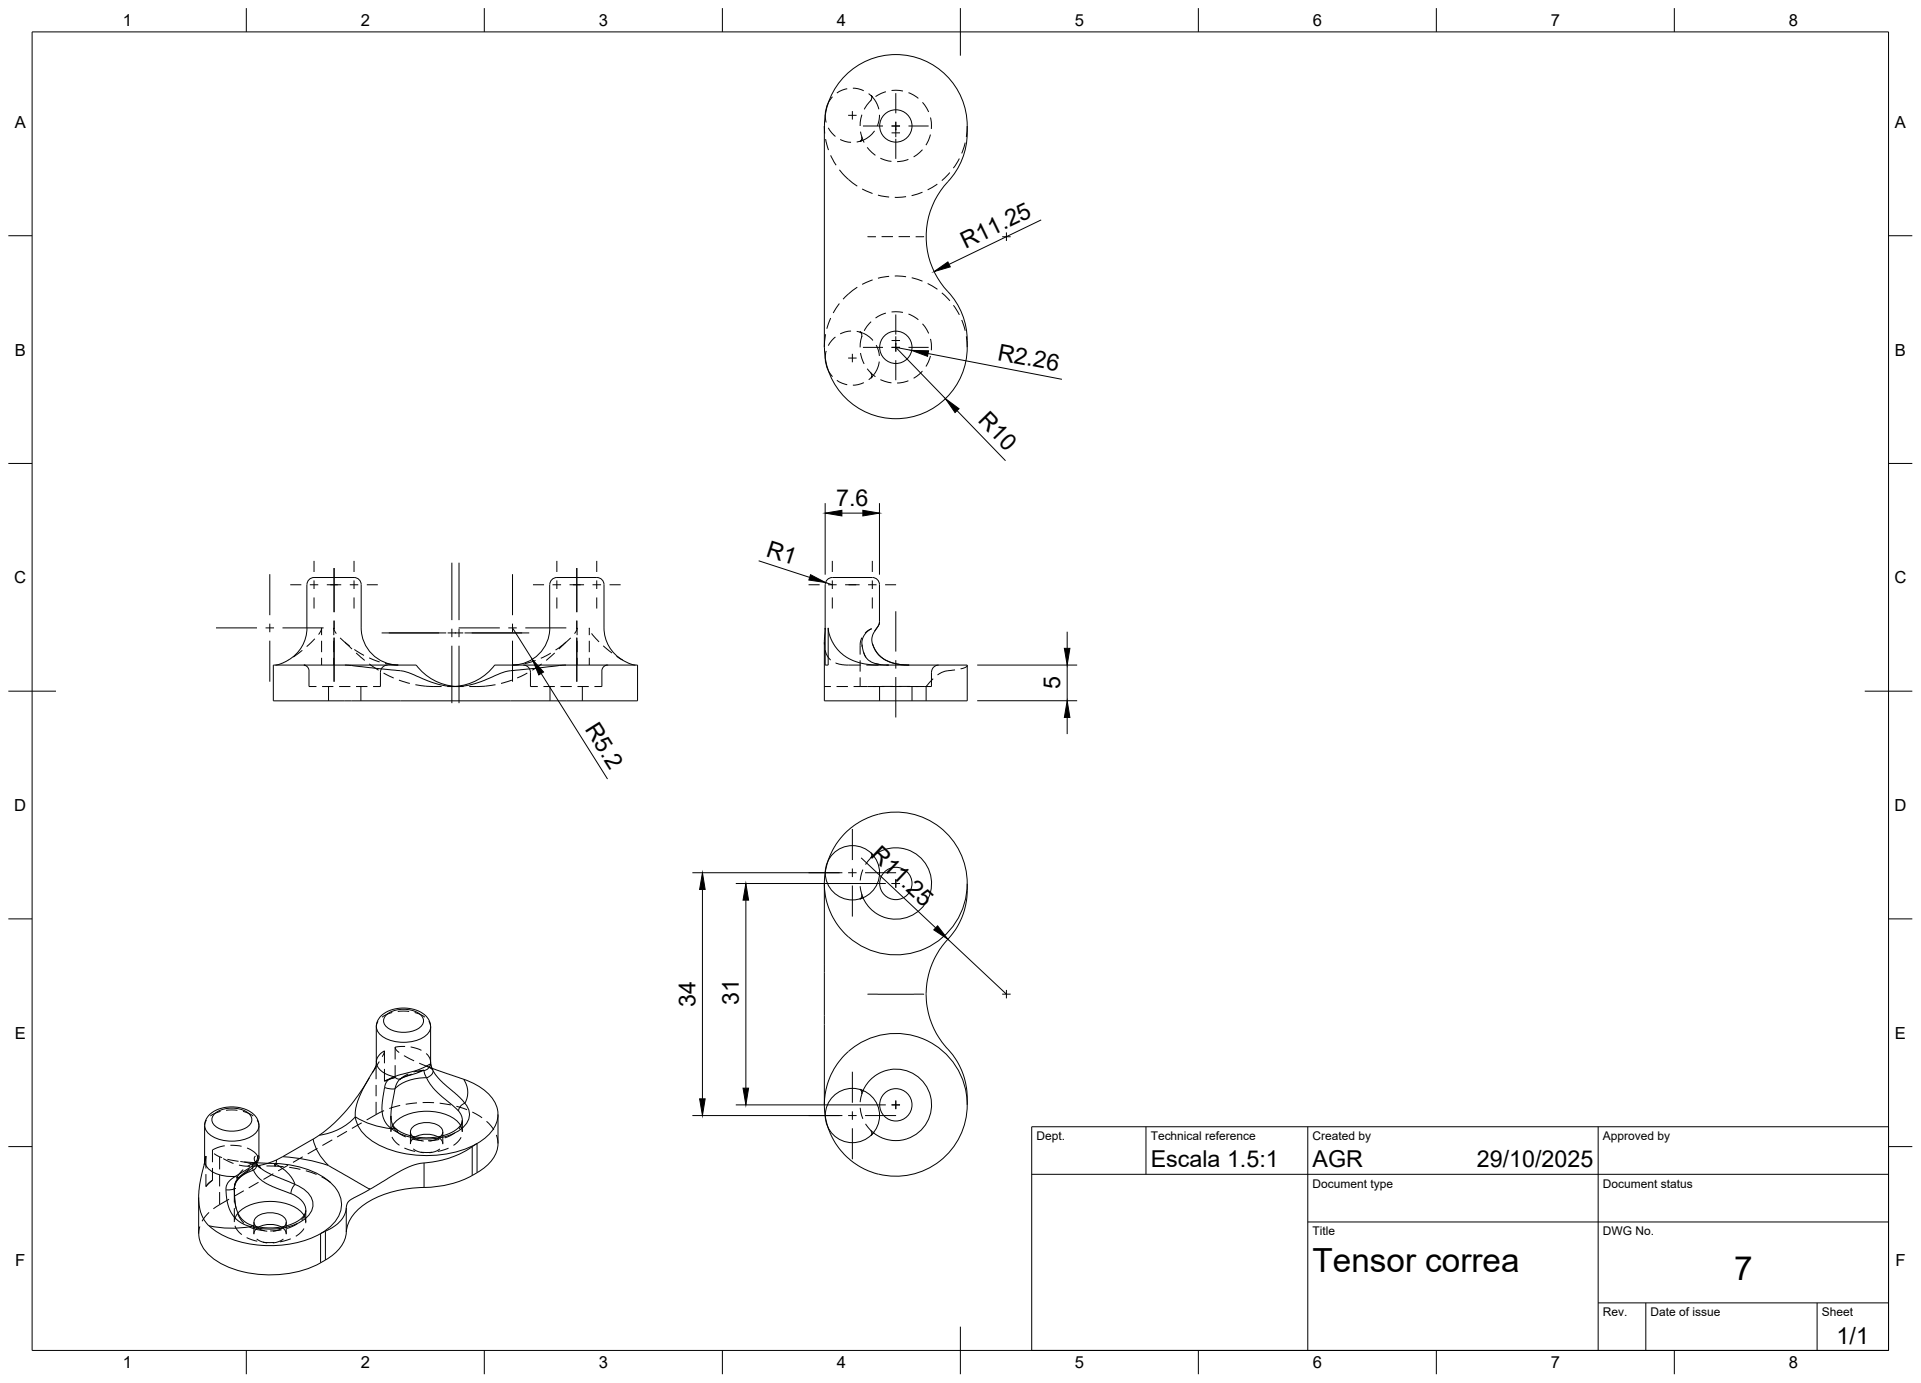
[picture p50: page 1]
Escala 1.5:1; AGR 34

Dept. | Technical reference | Created by 29/10/2025 | Approved by

Document type | Document status

Title Tensor correa | DWG No. 7

Rev. | Date of issue | Sheet 1/1
