audisio-ing/UNLZ-Proyecto_Final-Estacion_de_Escaneo_3D_para_Analisis_de_Desviaciones_Dimensionales/Planos/Mecanismo Giratorio/Poleas GT2 v2.pdf

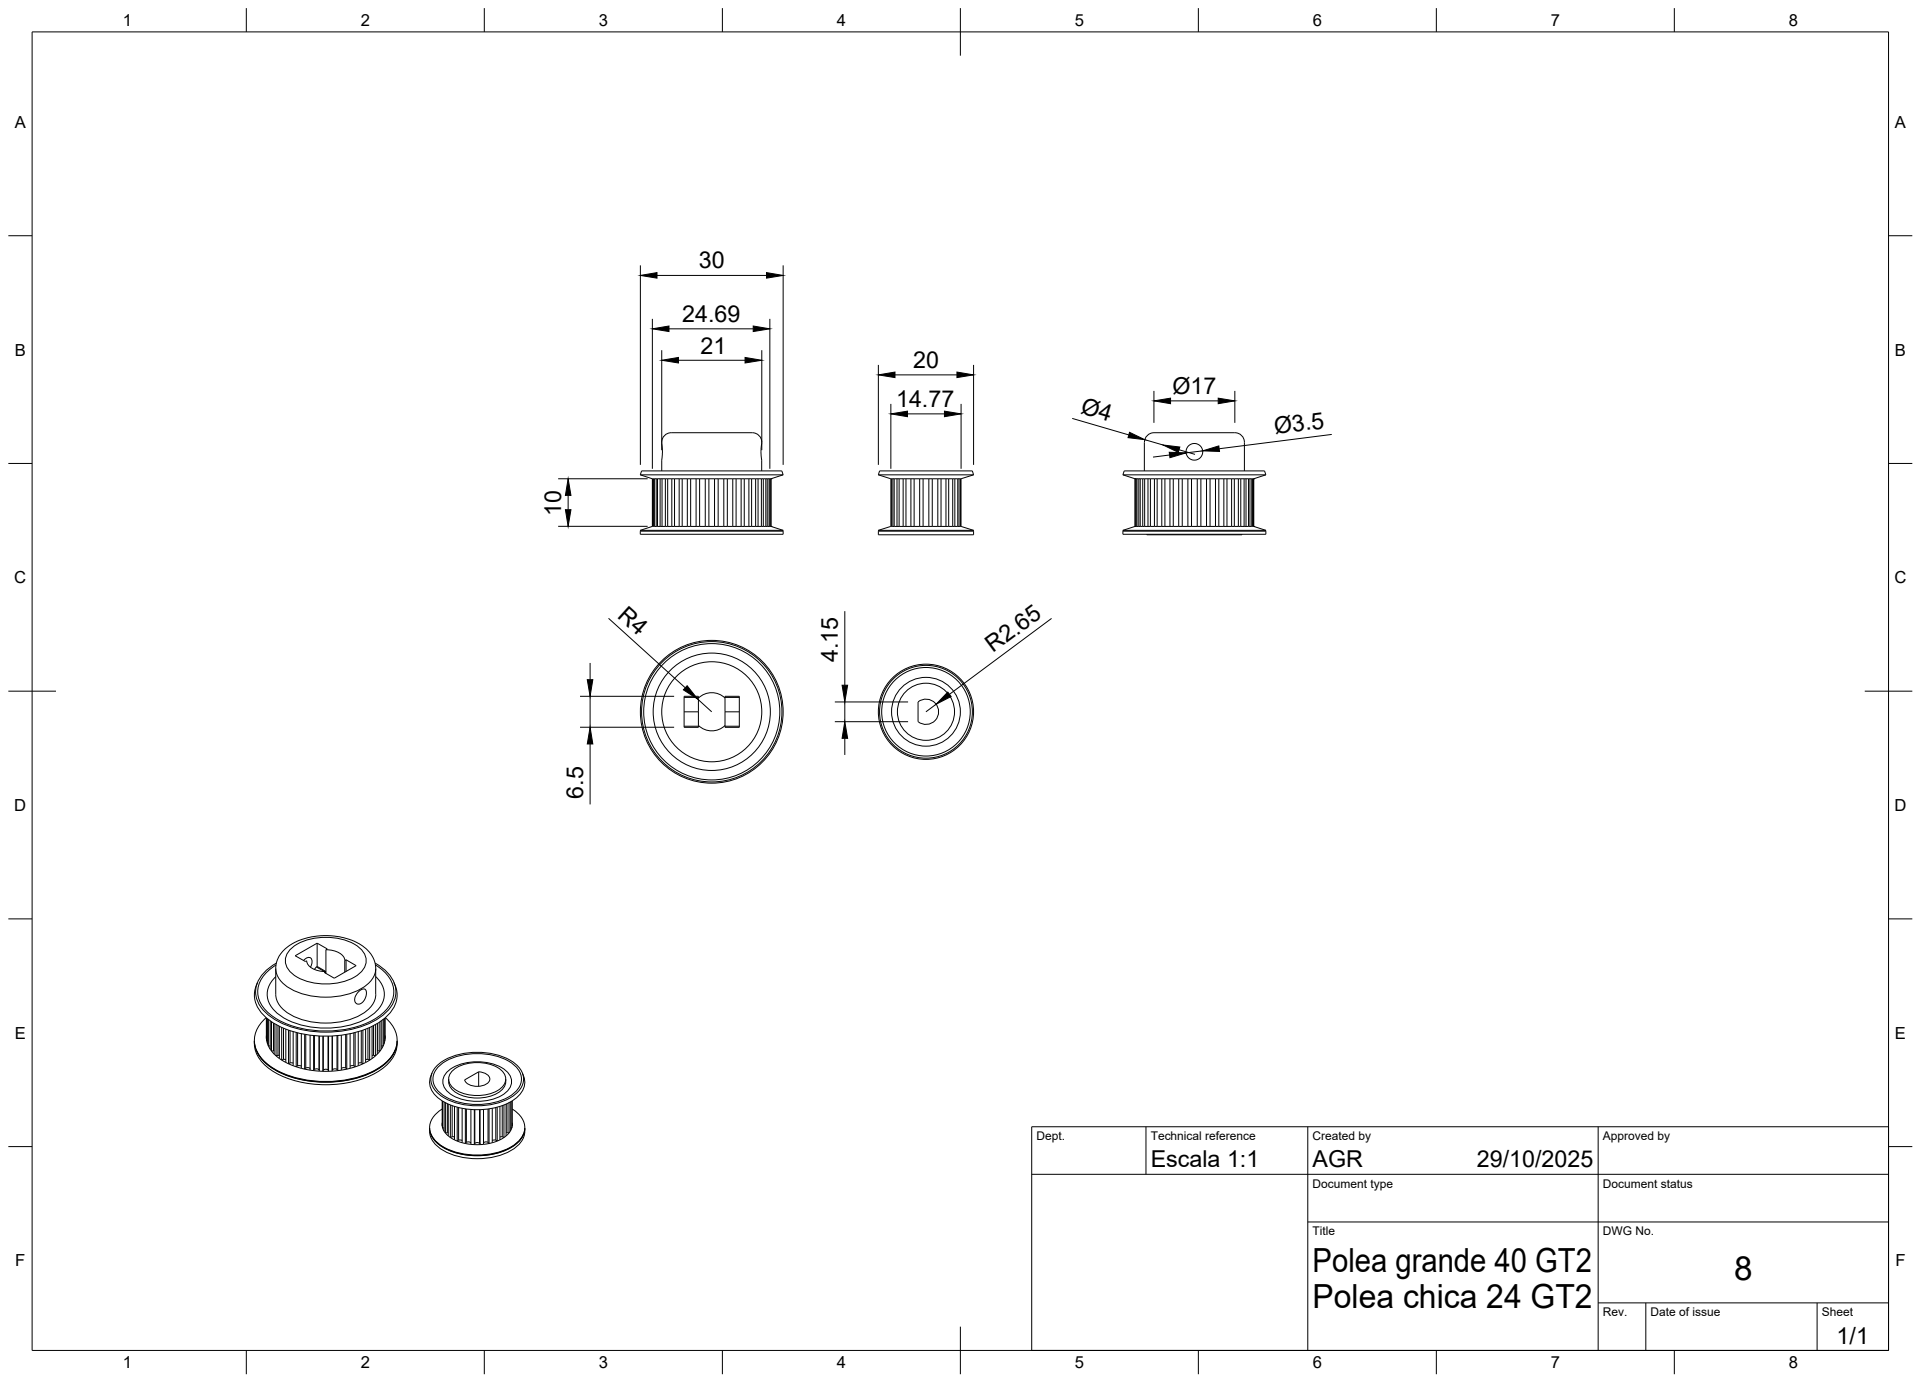
[picture p51: page 1]

Dept. | Technical reference Escala 1:1 | Created by AGR 29/10/2025 | Approved by

Document type | Document status

Title Polea grande 40 GT2 Polea chica 24 GT2 | DWG No. 8

Rev. | Date of issue | Sheet 1/1
