audisio-ing/UNLZ-Proyecto_Final-Estacion_de_Escaneo_3D_para_Analisis_de_Desviaciones_Dimensionales/Planos/Mecanismo Giratorio/Soporte de camara v3.pdf

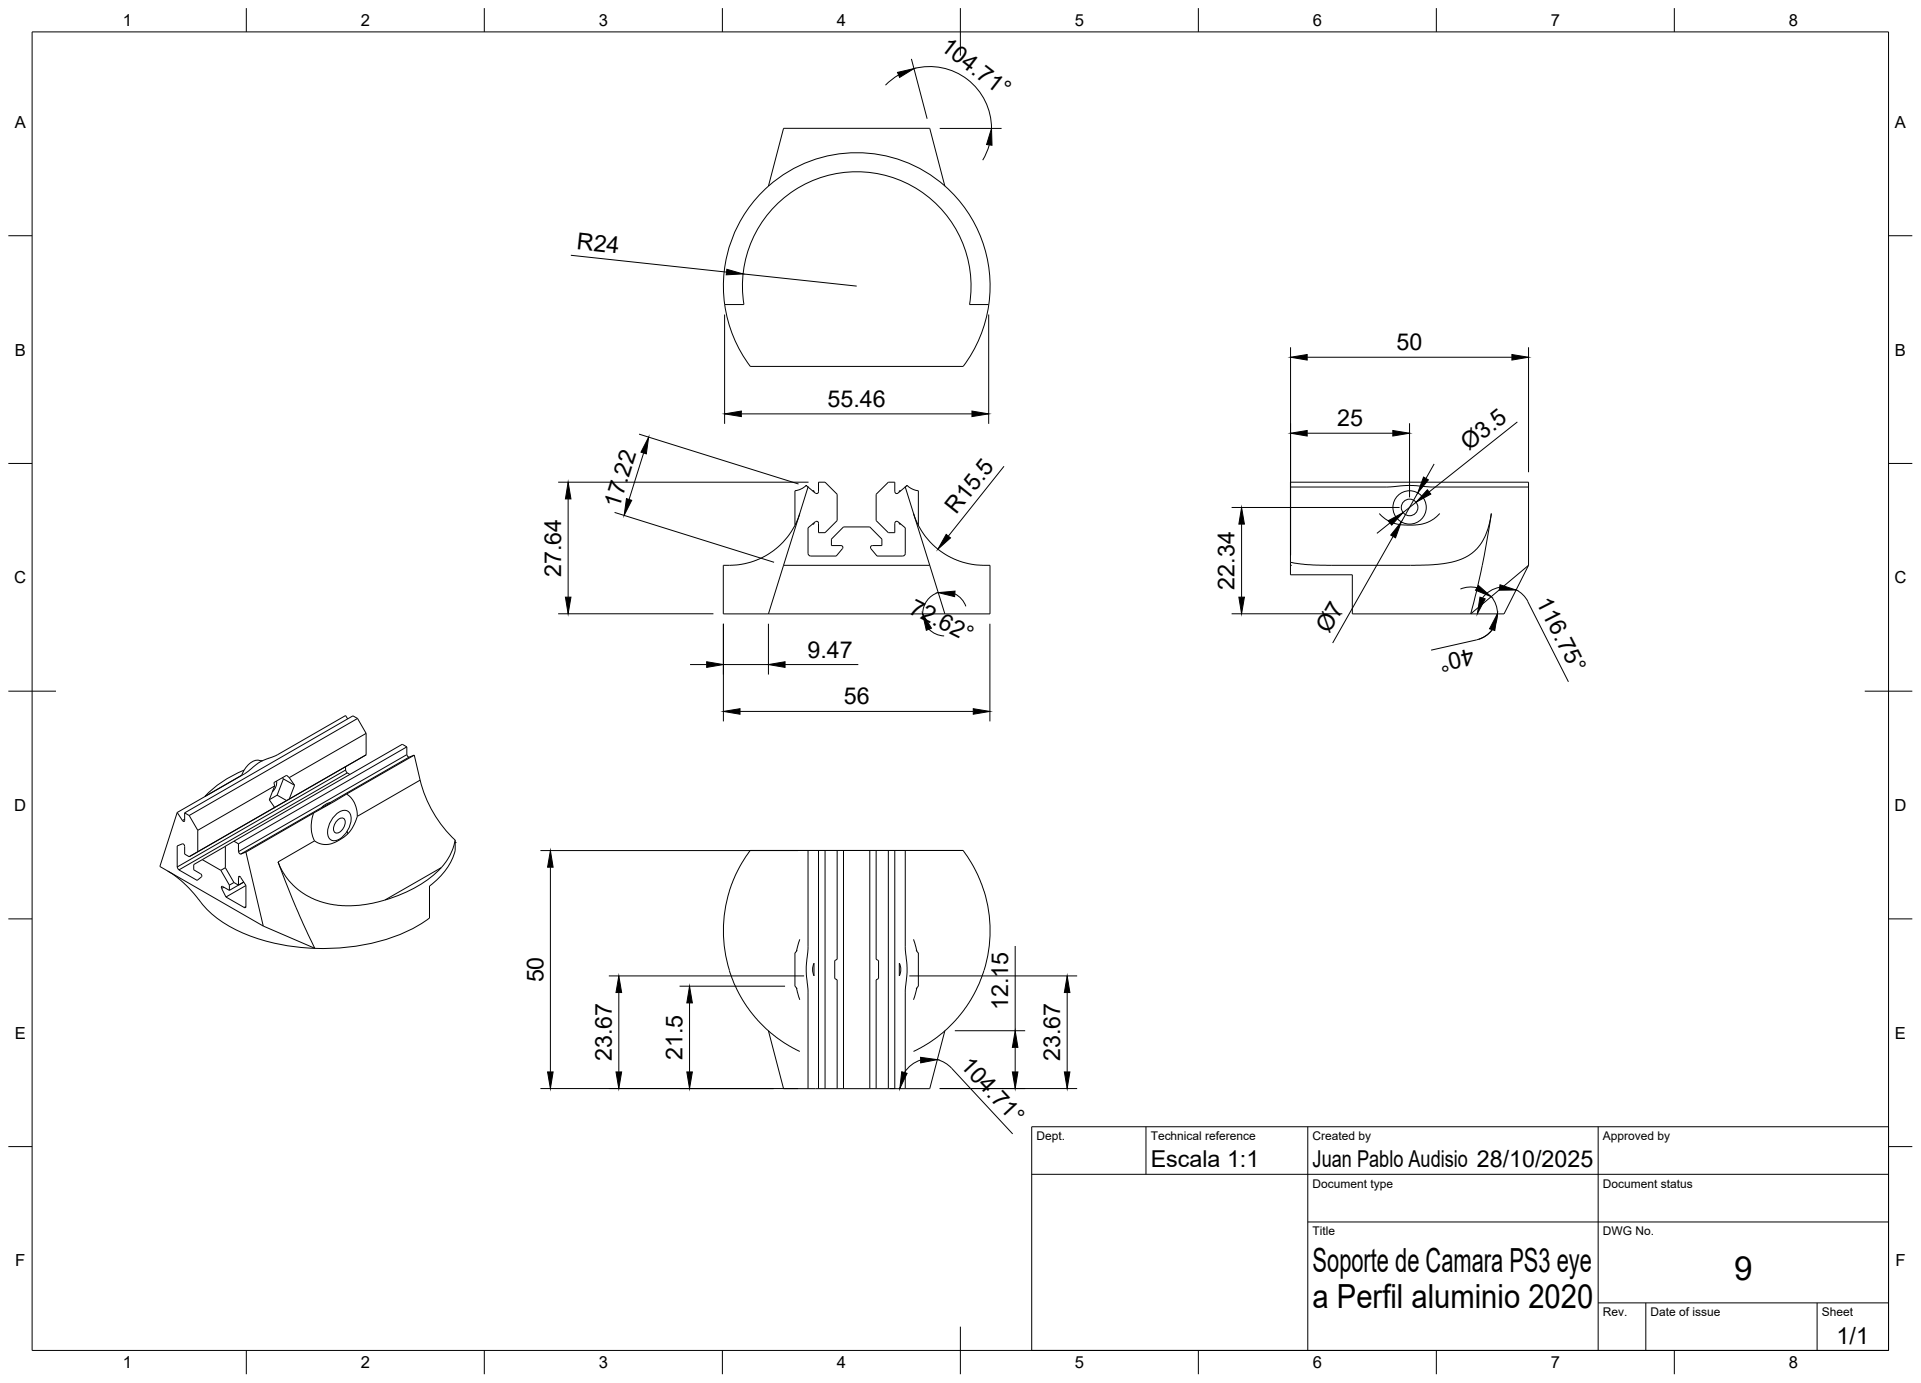
[picture p52: page 1]
8 BCDEF; ABCDEF

Dept. | Technical reference Escala 1:1 | Created by Juan Pablo Audisio 28/10/2025 | Approved by

Document type | Document status

Title Soporte de Camara PS3 eye a Perfil aluminio 2020 | DWG No. 9

Rev. | Date of issue | Sheet 1/1
