audisio-ing/UNLZ-Proyecto_Final-Estacion_de_Escaneo_3D_para_Analisis_de_Desviaciones_Dimensionales/(commit log)

2025-11-06 Añadir aceleracion de la cinta
    Added AccelStepper library and integrated it for controlling the conveyor belt. Updated various functions to utilize the new stepper control methods.
2025-11-10 Update README.md
    Se agrega BOM
2025-11-10 Create BOM
2025-11-11 Añadido Aceleración en el motor de la cámara
2025-11-11 Ajustes menores
    Removed acceleration setting for the scanner motor during homing.
2025-11-14 Mejorar la interfaz
    Added dark theme color palette and improved UI layout for camera and Arduino setup.
2025-11-14 Update README with schematics and images
    Added images and details for schematics and project assembly.
2025-11-25 Restructuración de README
    Updated the README to improve formatting and clarity, including team member section, project description, and index.
2025-11-25 Rename Diagrama de Gantt.pdf to Horas Estimadas vs Reales.pdf
2025-11-26 Expand README with sensor and motor details
    Added sections on Time-of-Flight and Hall effect sensors, and stepper motors.
2025-11-26 Fix wording on scanning distortion issue
    Corrected phrasing regarding camera distortion in scanning section.
2025-11-26 Expand README with 3D scanning and triangulation details
    Added detailed explanation of 3D scanning and laser triangulation principles.
2025-11-30 Update README with camera and mechanism details
    Added details about the rotating mechanism and improvements to the camera setup.
2025-12-01 Update and rename Patron-A-100.csv to Escaneos/Patron-A-100.csv
    [Patron-A-100.csv]
2025-12-01 Update and rename Patron-A-50.csv to Escaneos/Patron-A-50.csv
    [Patron-A-50.csv]
2025-12-08 Update scanning results description in README
    Clarified the number of samples used for scanning both pattern and distorted pieces.
2025-12-08 Rename Diagrama de Gantt.pdf to DIAGRAMA DE GANTT.pdf
2025-12-15 Corregir bug volver a escanear
    [Escaneo UI.py]
